kpezeshki/MuddPiV5/GPIO_TEST_WORKING.txt

/*
 * GccApplication1.c
 *
 * Created: 11/12/2018 7:54:07 PM
 * Author : kaveh
 */ 

//WORKING

#include "sam.h"

int main(void)
{
    /* Initialize the SAM system */
    //SystemInit();
	*(int *)0x20000008 = 2;
    /* Replace with your application code */
	REG_PMC_WPMR = PMC_WPMR_WPKEY_PASSWD;
	//now we enable the clock for peripheral #11 (PIOA p50)
	REG_PMC_PCER0 = PMC_PCER0_PID11; 
	
	//next we set the desired pin (PA26) as an output (P588)
	//first need to disable write protection (P633)
	REG_PIOA_WPMR = PIO_WPMR_WPKEY_PASSWD;
	//Now we set the PIO to control pin 26 (bit 26 of PIO_PER)
	//should we be using REG_PIOA_Per in pioa.h?
	REG_PIOA_PER  = PIO_PER_P10;
	//We allow the PIO write access to pin 26
	REG_PIOA_OWER = PIO_OWER_P10;
	//We now set pin 26 as an output, by writing a 1 in pin 26 of PIO_OER
	REG_PIOA_OER  = PIO_OER_P10;
	//We next write the LED to be high, by writing in PIO_SODR (set output data register), and can be cleared by writing in PIO_CODR (clear output data register). These results can be seen on PIO_ODSR (output data status register), which represents the current state of the output pins
	//An overview is on p573
	REG_PIOA_ODSR = 0; //PIO_ODSR_P9;
    while (1) 
    {
	REG_PIOA_CODR = PIO_CODR_P10; //SETS LED LOW
	REG_PIOA_SODR = PIO_SODR_P10; //SETS LED HIGH
	}
	
}
