kpezeshki/MuddPiV5/Pre-Existing Work/FinalVersion/README.txt.docx

The latest update of this version of microMudd Mark V board was April 24, 2018 by Teerapat Jenrungrot.

The Gerbers are generated for both tester board and the main board.
