kpezeshki/MuddPiV5/New PCB, no jumpers/Layout.docx

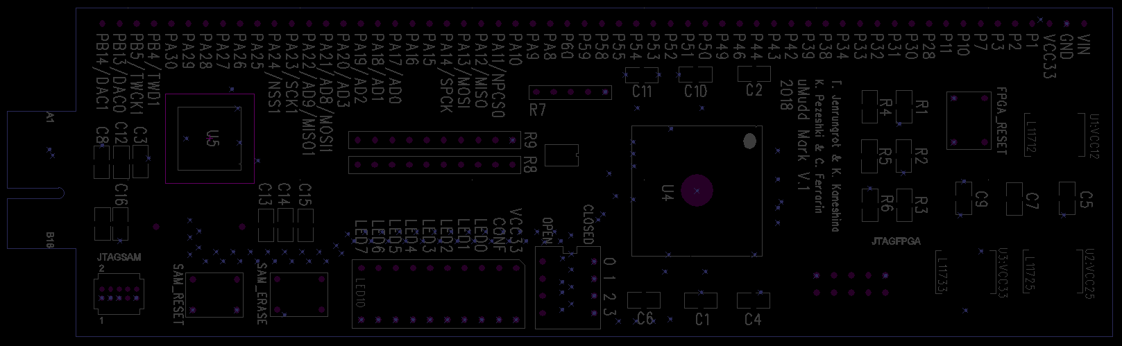
[picture p39: figure]
