kpezeshki/MuddPiV5/Pre-Existing Work/DEPRECATED/OLD/microp-revised-board-20170927T040230Z-001/top-layer.pdf

# R6R⁶x1 R⁶x2 U10

## C10C¹⁰x1 C¹⁰x2

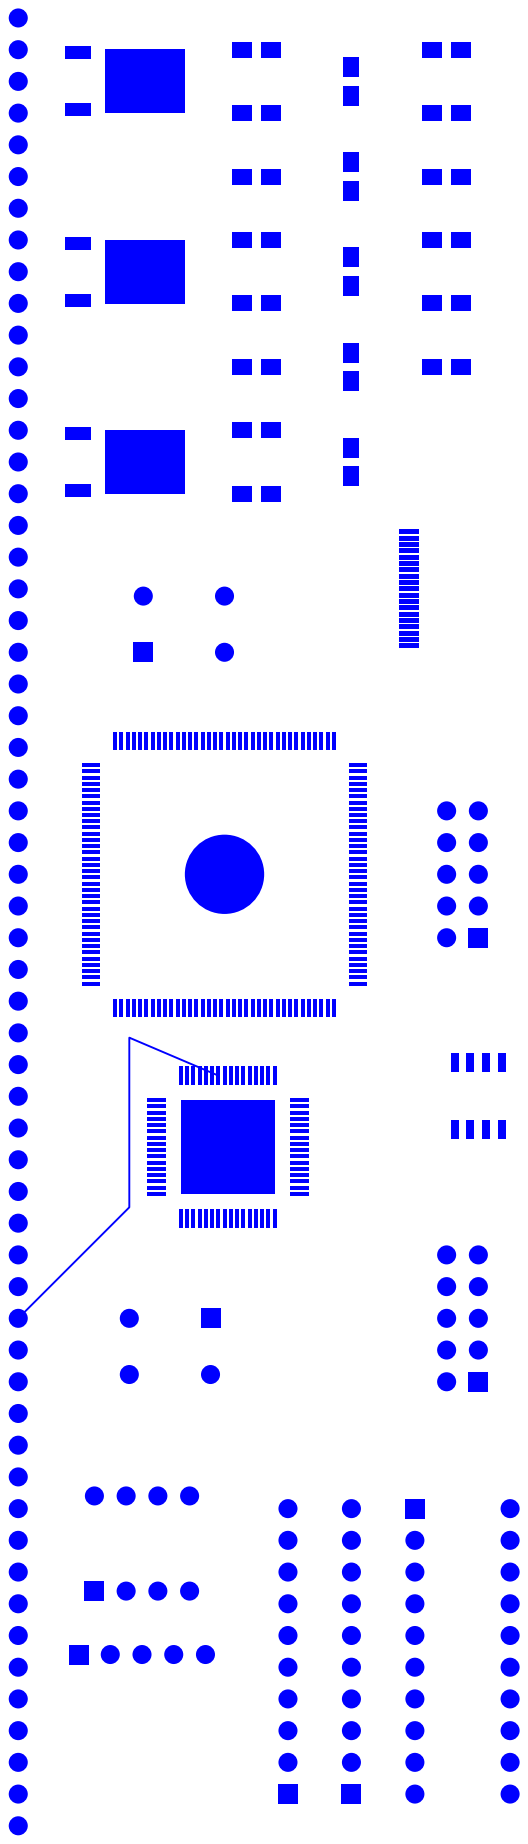
[picture p40: page 1]
U1U¹x1 U¹x3; U¹x2; U2U²x1 U²x3; U²x2; U3U³x1 U³x3; U³x2; U6U⁶x16; U⁶x15; U⁶x14; U⁶x13; U⁶x12; U⁶x11; U⁶x10; U⁶x9; U⁶x8; U⁶x7; U⁶x6; U⁶x5; U⁶x4; U⁶x3; U⁶x2; U⁶x1 U⁶x17 U⁶x18 U⁶x19 U⁶x20 U⁶x21 U⁶x22 U⁶x23 U⁶x24 U⁶x25 U⁶x26 U⁶x27 U⁶x28 U⁶x29 U⁶x30 U⁶x31 U⁶x32; U⁶x33; U⁶x34; U⁶x35; U⁶x36; U⁶x37; U⁶x38; U⁶x39; U⁶x40; U⁶x41; U⁶x42; U⁶x43; U⁶x44; U⁶x45; U⁶x46; U⁶x47; U⁶x48; U⁶x49 U⁶x50 U⁶x51 U⁶x52 U⁶x53 U⁶x54 U⁶x55 U⁶x56 U⁶x57 U⁶x58 U⁶x59 U⁶x60 U⁶x61 U⁶x62 U⁶x63 U⁶x64 U⁶x65; C1C¹x1; C¹x2; C2C²x1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

U12 U¹²x1 U¹²x2 U¹²x3 U¹²x4 U¹²x8 U¹²x7 U¹²x6 U¹²x5 U7U⁷x145 U10 R9R⁹x1 | R⁹x2 | R⁹x3 | R⁹x4 | R⁹x5 U¹⁰x1 U¹⁰x2 U¹⁰x3 U¹⁰x4 U¹⁰x5 U¹⁰x6 U¹⁰x7 U¹⁰x8 U¹⁰x9 U¹⁰x10 U¹⁰x11 U¹⁰x12 U¹⁰x13 U¹⁰x14 U¹⁰x15 U¹⁰x16 U¹⁰x17 U¹⁰x18 U¹⁰x19 U¹⁰x20 U¹⁰x21 U¹⁰x22 U¹⁰x23 U¹⁰x24 U¹⁰x25 U¹⁰x26 U¹⁰x27 U¹⁰x28 U¹⁰x29 U¹⁰x30 U¹⁰x31 U¹⁰x32 U¹⁰x33 U¹⁰x34 U¹⁰x35 U¹⁰x36 U¹⁰x37 U¹⁰x38 U¹⁰x39 U¹⁰x40 U¹⁰x41 U¹⁰x42 U¹⁰x43 U¹⁰x44 U¹⁰x45 U¹⁰x46 U¹⁰x47 U¹⁰x48 U¹⁰x49 U¹⁰x50 U¹⁰x51 U¹⁰x52 U¹⁰x53 U¹⁰x54 U¹⁰x55 U¹⁰x56 U¹⁰x57 U¹⁰x58
U5U⁵xA¹ | U⁵xA² U⁵xB¹ | U⁵xB² | R7R⁷x1 R⁷x2 R⁷x3 R⁷x4 R⁷x5 R⁷x6 R⁷x7 R⁷x8 R⁷x9 R⁷x10 R8R⁸x1 R⁸x2 R⁸x3 R⁸x4 R⁸x5 R⁸x6 R⁸x7 R⁸x8 R⁸x9 R⁸x10
U11 U¹¹xA² | U¹¹xA¹ U¹¹xB² | U¹¹xB¹ | U9U⁹x1 U⁹x2 U⁹x3 U⁹x4 U⁹x5 U⁹x6 U⁹x7 U⁹x8 U⁹x9 U⁹x10 | U⁹x11 U⁹x12 U⁹x13 U⁹x14 U⁹x15 U⁹x16 U⁹x17 U⁹x18 U⁹x19 U⁹x20 JTAGSAM JTAGSAMx2 JTAGSAMx1 JTAGSAMx4 JTAGSAMx3 JTAGSAMx6 JTAGSAMx5 JTAGSAMx8 JTAGSAMx7 JTAGSAMx10 JTAGSAMx9 JTAGFPGA JTAGFPGAx2 JTAGFPGAx1 JTAGFPGAx4 JTAGFPGAx3 JTAGFPGAx6 JTAGFPGAx5 JTAGFPGAx8 JTAGFPGAx7 JTAGFPGAx10 JTAGFPGAx9

U12 U¹²x1 U¹²x2 U¹²x3 U¹²x4 U¹²x8 U¹²x7 U¹²x6 U¹²x5 U7U⁷x145 U10 R9R⁹x1 | R⁹x2 | R⁹x3 | R⁹x4 | R⁹x5 U¹⁰x1 U¹⁰x2 U¹⁰x3 U¹⁰x4 U¹⁰x5 U¹⁰x6 U¹⁰x7 U¹⁰x8 U¹⁰x9 U¹⁰x10 U¹⁰x11 U¹⁰x12 U¹⁰x13 U¹⁰x14 U¹⁰x15 U¹⁰x16 U¹⁰x17 U¹⁰x18 U¹⁰x19 U¹⁰x20 U¹⁰x21 U¹⁰x22 U¹⁰x23 U¹⁰x24 U¹⁰x25 U¹⁰x26 U¹⁰x27 U¹⁰x28 U¹⁰x29 U¹⁰x30 U¹⁰x31 U¹⁰x32 U¹⁰x33 U¹⁰x34 U¹⁰x35 U¹⁰x36 U¹⁰x37 U¹⁰x38 U¹⁰x39 U¹⁰x40 U¹⁰x41 U¹⁰x42 U¹⁰x43 U¹⁰x44 U¹⁰x45 U¹⁰x46 U¹⁰x47 U¹⁰x48 U¹⁰x49 U¹⁰x50 U¹⁰x51 U¹⁰x52 U¹⁰x53 U¹⁰x54 U¹⁰x55 U¹⁰x56 U¹⁰x57 U¹⁰x58
U5U⁵xA¹ | U⁵xA² U⁵xB¹ | U⁵xB² | R7R⁷x1 R⁷x2 R⁷x3 R⁷x4 R⁷x5 R⁷x6 R⁷x7 R⁷x8 R⁷x9 R⁷x10 R8R⁸x1 R⁸x2 R⁸x3 R⁸x4 R⁸x5 R⁸x6 R⁸x7 R⁸x8 R⁸x9 R⁸x10
U11 U¹¹xA² | U¹¹xA¹ U¹¹xB² | U¹¹xB¹ | U9U⁹x1 U⁹x2 U⁹x3 U⁹x4 U⁹x5 U⁹x6 U⁹x7 U⁹x8 U⁹x9 U⁹x10 | U⁹x11 U⁹x12 U⁹x13 U⁹x14 U⁹x15 U⁹x16 U⁹x17 U⁹x18 U⁹x19 U⁹x20 JTAGSAM JTAGSAMx2 JTAGSAMx1 JTAGSAMx4 JTAGSAMx3 JTAGSAMx6 JTAGSAMx5 JTAGSAMx8 JTAGSAMx7 JTAGSAMx10 JTAGSAMx9 JTAGFPGA JTAGFPGAx2 JTAGFPGAx1 JTAGFPGAx4 JTAGFPGAx3 JTAGFPGAx6 JTAGFPGAx5 JTAGFPGAx8 JTAGFPGAx7 JTAGFPGAx10 JTAGFPGAx9

U12 U¹²x1 U¹²x2 U¹²x3 U¹²x4 U¹²x8 U¹²x7 U¹²x6 U¹²x5 U7U⁷x145 U10 R9R⁹x1 | R⁹x2 | R⁹x3 | R⁹x4 | R⁹x5 U¹⁰x1 U¹⁰x2 U¹⁰x3 U¹⁰x4 U¹⁰x5 U¹⁰x6 U¹⁰x7 U¹⁰x8 U¹⁰x9 U¹⁰x10 U¹⁰x11 U¹⁰x12 U¹⁰x13 U¹⁰x14 U¹⁰x15 U¹⁰x16 U¹⁰x17 U¹⁰x18 U¹⁰x19 U¹⁰x20 U¹⁰x21 U¹⁰x22 U¹⁰x23 U¹⁰x24 U¹⁰x25 U¹⁰x26 U¹⁰x27 U¹⁰x28 U¹⁰x29 U¹⁰x30 U¹⁰x31 U¹⁰x32 U¹⁰x33 U¹⁰x34 U¹⁰x35 U¹⁰x36 U¹⁰x37 U¹⁰x38 U¹⁰x39 U¹⁰x40 U¹⁰x41 U¹⁰x42 U¹⁰x43 U¹⁰x44 U¹⁰x45 U¹⁰x46 U¹⁰x47 U¹⁰x48 U¹⁰x49 U¹⁰x50 U¹⁰x51 U¹⁰x52 U¹⁰x53 U¹⁰x54 U¹⁰x55 U¹⁰x56 U¹⁰x57 U¹⁰x58
U5U⁵xA¹ | U⁵xA² U⁵xB¹ | U⁵xB² | R7R⁷x1 R⁷x2 R⁷x3 R⁷x4 R⁷x5 R⁷x6 R⁷x7 R⁷x8 R⁷x9 R⁷x10 R8R⁸x1 R⁸x2 R⁸x3 R⁸x4 R⁸x5 R⁸x6 R⁸x7 R⁸x8 R⁸x9 R⁸x10
U11 U¹¹xA² | U¹¹xA¹ U¹¹xB² | U¹¹xB¹ | U9U⁹x1 U⁹x2 U⁹x3 U⁹x4 U⁹x5 U⁹x6 U⁹x7 U⁹x8 U⁹x9 U⁹x10 | U⁹x11 U⁹x12 U⁹x13 U⁹x14 U⁹x15 U⁹x16 U⁹x17 U⁹x18 U⁹x19 U⁹x20 JTAGSAM JTAGSAMx2 JTAGSAMx1 JTAGSAMx4 JTAGSAMx3 JTAGSAMx6 JTAGSAMx5 JTAGSAMx8 JTAGSAMx7 JTAGSAMx10 JTAGSAMx9 JTAGFPGA JTAGFPGAx2 JTAGFPGAx1 JTAGFPGAx4 JTAGFPGAx3 JTAGFPGAx6 JTAGFPGAx5 JTAGFPGAx8 JTAGFPGAx7 JTAGFPGAx10 JTAGFPGAx9

C1

C2

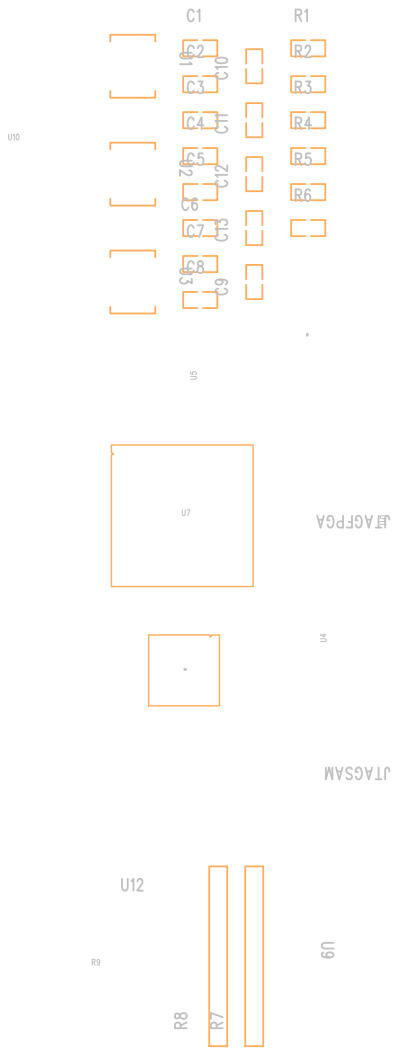
[picture p41: page 5]

.¹³
2

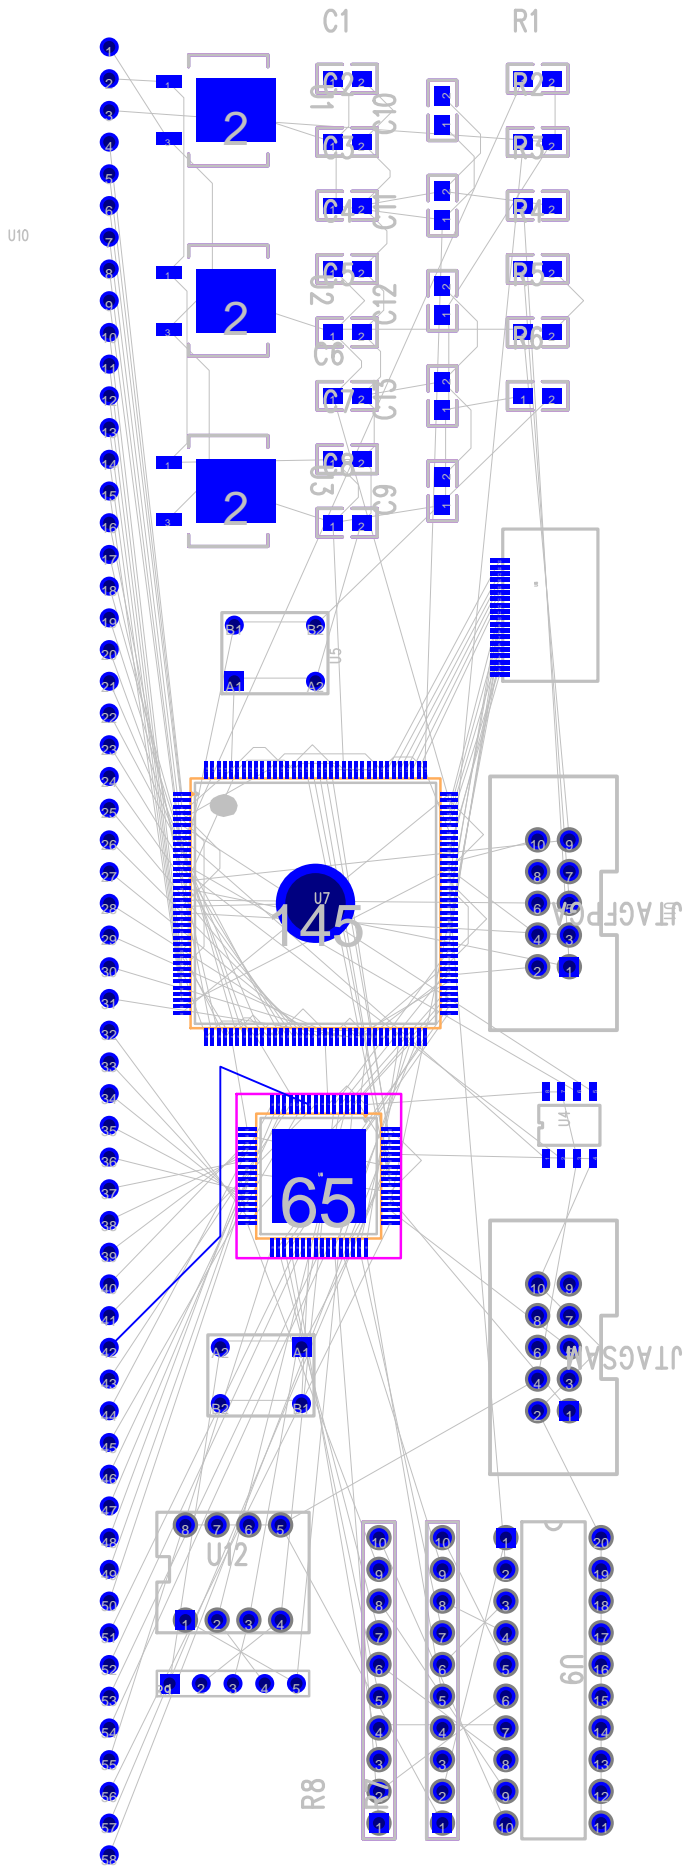
[picture p42: page 7]
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
