kpezeshki/MuddPiV5/deadmemory.JPG

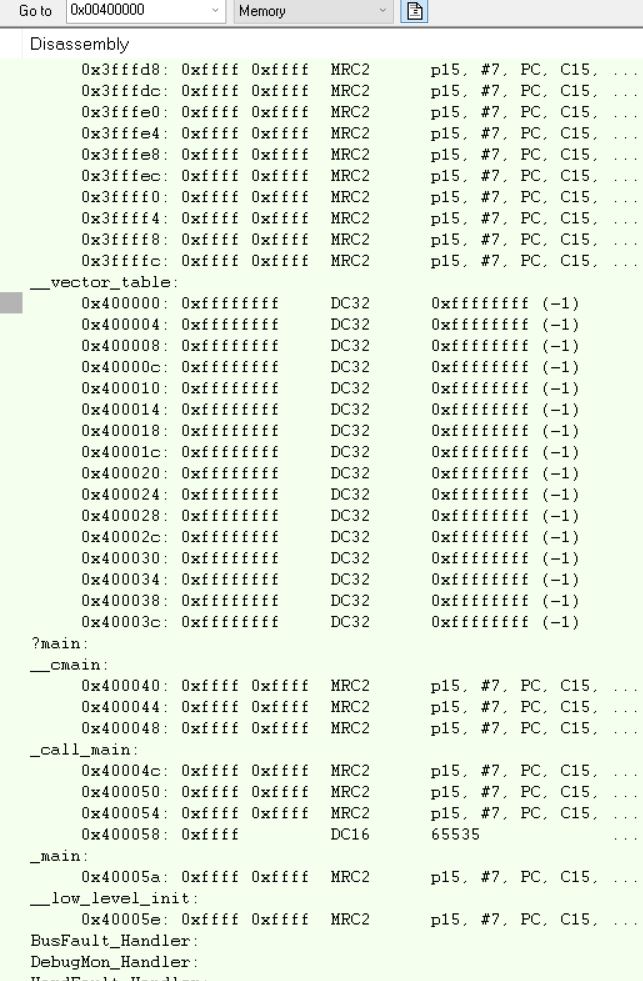
deadmemory.JPG
