kpezeshki/MuddPiV5/Final Report/E155%20Final%20Report/lab6schematic.jpg

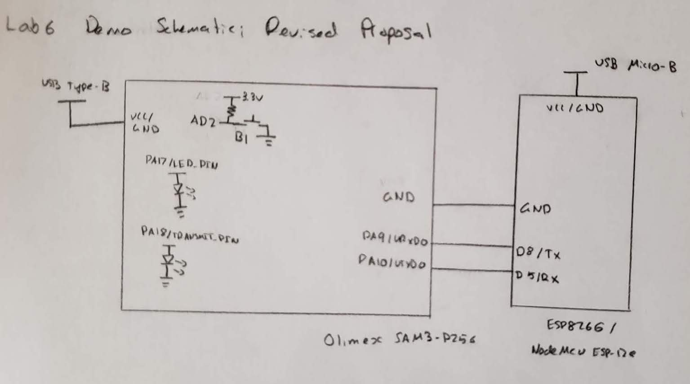
Final Report/E155%20Final%20Report/lab6schematic.jpg
