kpezeshki/MuddPiV5/New PCB, no jumpers/board_screenshot.PNG

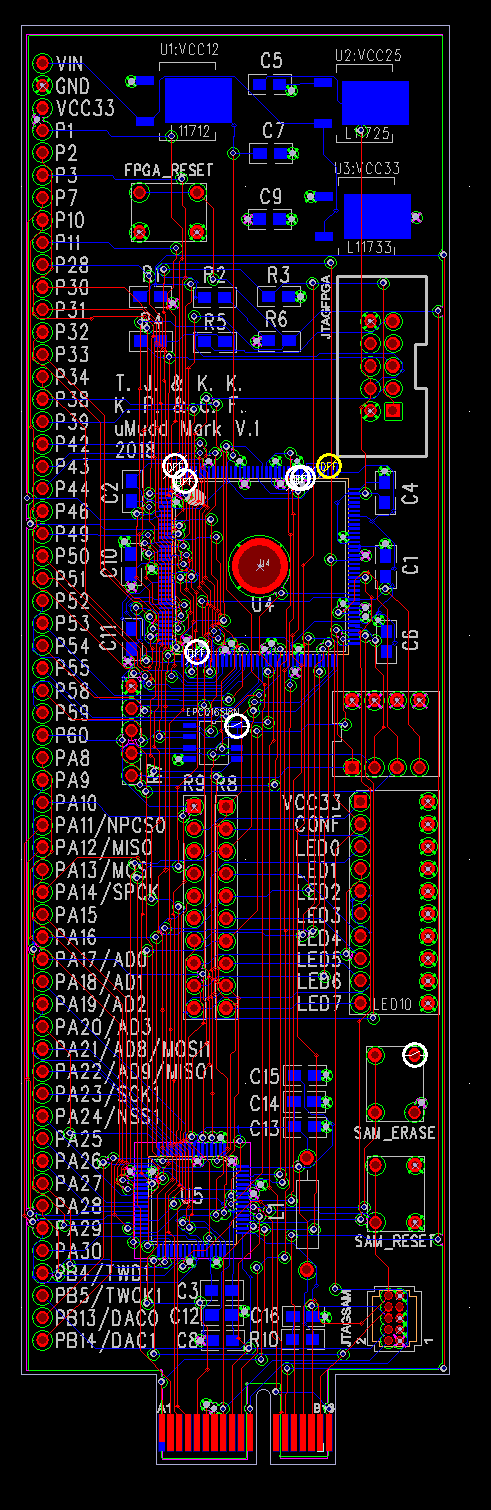
New PCB, no jumpers/board_screenshot.PNG
