kpezeshki/MuddPiV5/Pre-Existing Work/pic.jpg

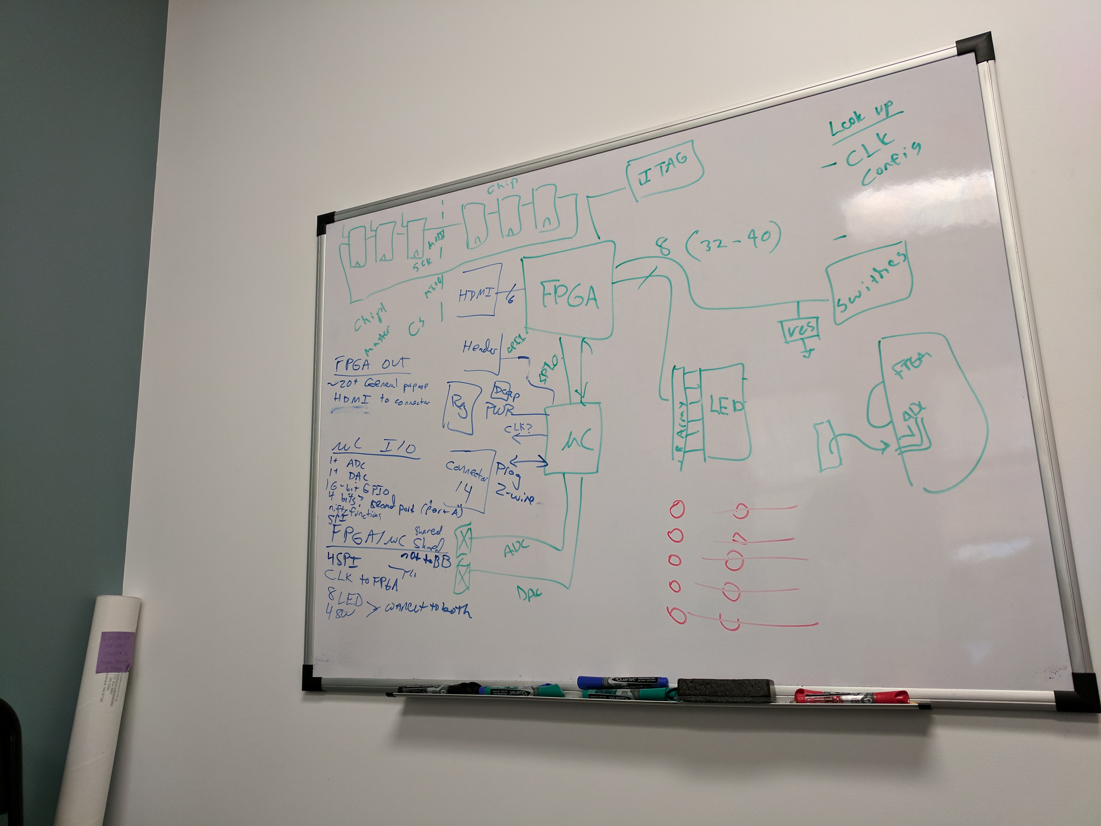
Pre-Existing Work/pic.jpg
