kpezeshki/MuddPiV5/Pre-Existing Work/FinalVersion/Gerbers/dimsensions _ ordering info.docx

MAIN(4 copies)

1.91 x 6.42 inches

TESTER (3 copies)

2.10 x 4.35 inches

http://www.4pcb.com/pcb-student-discount.html

Order 4 of each
