kpezeshki/MuddPiV5/New PCB, no jumpers/Bill of Materials.xlsx

Sheet: uMudd Mark V
 | Parts | Description | Manufacturer | Mfr Part # | Supplier | Sup Part # | Quantity | Unit Price | Total Cost | Notes | availability as of November 1
Ordered
y | U6 | Cyclone IV FPGA | Altera | EP4CE6E22C8N | Digikey | 544-2746-ND | 1 | 11.95 | 11.95 |  | in stock
y | U5 | FPGA flash | Altera | EPCQ16ASI8N | Digikey | 544-3440-ND | 1 | 7.35 | 7.35 | 8-SOIC | in stock
y | U8 | microController | Microchip technology | ATSAM4S4BA-AU | Digikey | ATSAM4S4BA-AU-ND | 1 | 3.93 | 3.93 |  | in stock
n | U9 | Quad DIP switch | Grayhill | 76SB04 | Digikey | GH7170-ND | 1 | 0.92 | 0.92 |  | in stock
y | U1 | 1.2V low-dropout regulator | ST | LD117DT12TRI | Digikey | 497-1231-1-ND | 1 | 1.16 | 1.16 | SMD | in stock
y | U2 | 2.5V low-dropout regulator | ST | LD117DT25CTR | Digikey | 497-1233-1-ND | 1 | 1.16 | 1.16 | SMD | in stock
y | U3 | 3.3V low-dropout regulator | ST | LD117DT33CTR | Digikey | 497-1235-1-ND | 1 | 1.16 | 1.16 | SMD | in stock
n | PB1, PB2, PB3 | SPST pushbutton switch | Panasonic | EVQ-PAE04M | Digikey | P8008S-ND | 3 | 0.29 | 0.87 |  | in stock
n | U10 | 10-segment LED array | Lumex | SSA-LXB10IW-GF/LP | Digikey | 67-1010-ND | 1 | 2.85 | 2.85 |  | in stock
y | R8, R9 | 330 ohm 5 resistor network | Bournes | 4610X-2-331LF | Digikey | 4610X-2-331LF-ND | 2 | 0.286 | 0.572 |  | in stock
n | JTAGFPGA | FPGA download connector | Tyco | 5103309-1 | Digikey | A33160-ND | 1 | 0.76 | 0.76 |  | in stock
n | U11 | 36-pin header | 3M | 929400-01-36-RK | Digikey | 929400E-01-36-ND | 2 | 1.323 | 2.646 |  | in stock
y | R7 | 2.2Kohm 4 resistor network | Bourns Inc. | 4605X-101-222LF | Digikey | 4605X-101-222LF-ND | 1 | 0.51 | 0.51 |  | in stock
y | R2, R3 | 1K resistor | Panasonic Electronic Components | ERJ-6GEYJ102V | Digikey | P1.0KACT-ND | 2 | 0.1 | 0.2 | SMD | in stock
y | R1, R4, R5, R6 | 10K resistor | Panasonic Electronic Components | ERJ-6GEYJ103V | Digikey | P10KACT-ND | 4 | 0.1 | 0.4 | SMD | in stock
y | R10 | 1ohm resistor | Bourns Inc. | CRS0805-FW-1R00ELF | Digikey | CRS0805-FW-1R00ELFCT-ND | 1 | 0.39 | 0.39 | SMD | in stock
y | R11, R12, R13 | 100K resistors | Panasonic Electronic Components | ERJ-6GEYJ104V | Digikey | P100KACT-ND | 3 | 0.1 | 0.3 | SMD | in stock
y | C4, C6, C8, C11, C12, C13, C15, C17 | 0.1 uF capacitor | Samsung Electro-Mechanics America, Inc | CL21F104ZBCNNNC | Digikey | 1276-1007-1-ND | 8 | 0.1 | 0.8 | SMD | in stock
y | C1, C2, C3, C10 | 0.01 uF capacitor | Murata Electronics North America | GRM216R71H103KA01D | Digikey | 490-1664-1-ND | 4 | 0.1 | 0.4 | SMD | in stock
y | C5, C7, C9 | 10 uF capacitor | Samsung Electro-Mechanics America, Inc | CL21A106KPFNNNG | Digikey | 1276-6456-1-ND | 3 | 0.14 | 0.42 | SMD | in stock
y | C14 | 2.2uF capacitor | AVX Corporation | 0805ZG225ZAT4A | Digikey | 478-12511-1-ND | 1 | 0.41 | 0.41 | SMD | in stock
y | C16 | 4.7uF capacitor | Murata Electronics North America | GRT21BC8YA475KE13L | Digikey | 490-12361-1-ND | 1 | 0.45 | 0.45 | SMD | in stock
y | L1 | 10uH inductor | Bourns Inc. | 77F100K-TR-RC | Digikey | 77F100K-TR-RCTR-ND | 1 | 0.096 | 0.096 | through-hole | in stock
y | JTAGSAM | SAM download connector | Samtec | FTSH-105-01-F-D-K | Digikey | SAM8909-ND | 1 | 2.74 | 2.74 | polarized | in stock
y | Y1 | 40MHz oscillator | TXC Corporation | 9B-40.000MAAJ-B | Digikey | 887-2030-ND | 1 | 0.39 | 0.39 | through-hole | in stock

Sheet: Tester Board
Parts | Description | Manufacturer | Mfr Part # | Supplier | Sup Part # | Quantity | Unit Price | Total Cost | Notes | availability as of November 1
U1 | 1.2V low-dropout regulator | ST | LD117DT12TRI | Digikey | 497-1231-1-ND | 1 | 1.16 | 1.16 | SMD | in stock
U2 | 2.5V low-dropout regulator | ST | LD117DT25CTR | Digikey | 497-1233-1-ND | 1 | 1.16 | 1.16 | SMD | in stock
U3 | 3.3V low-dropout regulator | ST | LD117DT33CTR | Digikey | 497-1235-1-ND | 1 | 1.16 | 1.16 | SMD | in stock
U9 | 10-segment LED array | Lumex | SSA-LXB10IW-GF/LP | Digikey | 67-1010-ND | 1 | 2.85 | 2.85 |  | in stock
R7 | 330 ohm 5 resistor network | Bournes | 4610X-2-331LF | Digikey | 4610X-2-331LF-ND | 1 | 0.286 | 0.286 |  | in stock
JTAGSAM | SAM download connector | Samtec | FTSH-105-01-F-D-K | Digikey | SAM8909-ND | 1 | 2.74 | 2.74 | polarized | in stock
JTAGFPGA | FPGA/SAM download connector | Tyco | 5103309-1 | Digikey | A33160-ND | 2 | 0.76 | 1.52 |  | in stock
C4, C6, C8, C11, C13 | 0.1 uF capacitor | Samsung Electro-Mechanics America, Inc | CL21F104ZBCNNNC | Digikey | 1276-1007-1-ND | 5 | 0.1 | 0.5 | SMD | in stock
C1, C2, C3, C10, C12 | 0.01 uF capacitor | Murata Electronics North America | GRM216R71H103KA01D | Digikey | 490-1664-1-ND | 5 | 0.1 | 0.5 | SMD | in stock
C5, C7, C9 | 10 uF capacitor | Samsung Electro-Mechanics America, Inc | CL21A106KPFNNNG | Digikey | 1276-6456-1-ND | 3 | 0.17 | 0.51 | SMD | in stock
R1, R2 | 1K resistor | Panasonic Electronic Components | ERJ-6GEYJ102V | Digikey | P1.0KACT-ND | 2 | 0.1 | 0.2 | SMD | in stock
R3, R4, R5, R6 | 10K resistor | Panasonic Electronic Components | ERJ-6GEYJ103V | Digikey | P10KACT-ND | 4 | 0.1 | 0.4 | SMD | in stock
JTAGFPGA1 | Edge card connector | Molex | 87715-9005 | Digikey | WM9029-ND | 1 | $1.69 | $1.69 |  | in stock
BV2 | Banana socket, board mount, black | Deltron | 571-0100 | Mouser | 164-6218 | 1 | $1.97 | $1.97 |  | in stock
BV1 | Banana socket, board mount, red | Deltron | 571-0500 | Mouser | 164-6219 | 1 | $2.34 | $2.34 |  | in stock
STANOFF1, STANDOFF2, STANDOFF3, STANDOFF4 | Male-Female Threaded Hex Standoff, 18-8 Stainless Steel, 1/4" Hex, 1-1/2" Long, 8-32 to 8-32 Thread | McMaster-Carr | 91075A458 |  |  | 8 | 2.39 | 19.12 |  | in stock
R9, R10, R11, R12 | 100K resistors | Panasonic Electronic Components | ERJ-6GEYJ104V | Digikey | P100KACT-ND | 4 | 0.1 | 0.4 | SMD | in stock

Sheet: Equipment
https://www.segger.com/purchase/pricing/jlink-related/
