kpezeshki/MuddPiV5/New PCB, no jumpers/IO Breakout.xlsx

User-Accessible IO |  |  |  | Internal Signals
Header Pin Silkscreen | Microcontroller Pin | FPGA Pin | Other Pin | Microcontroller Pin | FPGA Pin | Other Pin
VIN | n/a | n/a | VIN | PB11 | P127 | n/a
GND | n/a | n/a | GND | PB10 | P126 | n/a
VCC33 | n/a | n/a | 3.3V regulator output | PB3 | P83 | SW3
P1 | n/a | P1 | n/a | PB2 | P80 | SW2
P2 | n/a | P2 | n/a | PB1 | P77 | SW1
P3 | n/a | P3 | n/a | PB0 | P76 | SW0
P7 | n/a | P7 | n/a | PA7 | P75 | LED7
P10 | n/a | P10 | n/a | PA6 | P74 | LED6
P11 | n/a | P11 | n/a | PA5 | P73 | LED5
P28 | n/a | P28 | n/a | PA30 | P72 | LED4
P30 | n/a | P30 | n/a | PA29 | P71 | LED3
P31 | n/a | P31 | n/a | PA2 | P20 | LED2
P32 | n/a | P32 | n/a | PA1 | P69 | LED1
P33 | n/a | P33 | n/a | PA0 | P68 | LED0
P34 | n/a | P34 | n/a
P38 | n/a | P38 | n/a
P39 | n/a | P39 | n/a
P42 | n/a | P42 | n/a
P43 | n/a | P43 | n/a
P44 | n/a | P44 | n/a
P46 | n/a | P46 | n/a
P49 | n/a | P49 | n/a
P50 | n/a | P50 | n/a
P51 | n/a | P51 | n/a
P52 | n/a | P52 | n/a
P53 | n/a | P53 | n/a
P54 | n/a | P54 | n/a
P55 | n/a | P55 | n/a
P58 | n/a | P58 | n/a
P59 | n/a | P59 | n/a
P60 | n/a | P60 | n/a
PA8 | PA8 | n/a | n/a
PA9 | PA9 | n/a | n/a
PA10 | PA10 | n/a | n/a
PA11/NPCS0 | PA11 | P110 | n/a
PA12/MISO | PA12 | P111 | n/a
PA13/MOSI | PA13 | P112 | n/a
PA14/SPCK | PA14 | P113 | n/a
PA15 | PA15 | n/a | n/a
PA16 | PA16 | n/a | n/a
PA17/AD0 | PA17 | n/a | n/a
PA18/AD1 | PA18 | n/a | n/a
PA19/AD2 | PA19 | n/a | n/a
PA20/AD3 | PA20 | n/a | n/a
PA21/AD8 | PA21 | n/a | n/a
PA22/AD9 | PA22 | n/a | n/a
PA23/SCK1 | PA23 | n/a | n/a
PA24/NSS1 | PA24 | n/a | n/a
PA25 | PA25 | n/a | n/a
PA26 | PA26 | n/a | n/a
PA27 | PA27 | n/a | n/a
PA28 | PA28 | n/a | n/a
PA3 | PA3 | n/a | n/a
PA4 | PA4 | n/a | n/a
PB4/TWD1 | PB4 | n/a | SAM4S JTAG TDI
PB5/TWCK1 | PB5 | n/a | SAM4S JTAG TDO
PB13/DAC0 | PB13 | n/a | n/a
PB14/DAC1 | PB14 | n/a | n/a
