kpezeshki/MuddPiV5/New PCB, no jumpers/Available IO.xlsx

MCU-FPGA
FPGA Pin | MCU Pin | On header? | On LED? | On switch? | MCU Pin Alt Modes
P68 | PA0 | n | y | n | PWM
P69 | PA1 | n | y | n | PWM
P70 | PA2 | n | y | n | PWM
P71 | PA3 | n | y | n | TWD0 | NPCS3 | PA29
P72 | PA4 | n | y | n | TWCK0 | TCLK0 | PA30
P73 | PA5 | n | y | n | RXD0 | NPCS3
P74 | PA6 | n | y | n | TXD0 | PCK0
P75 | PA7 | n | y | n
P76 | PB0 | n | n | y | PWM
P77 | PB1 | n | n | y | PWM
P80 | PB2 | n | n | y | URXD1 | NPCS2
P83 | PB3 | n | n | y | UTXD1 | PCK2
P126 | PB10 | n | n | n
P127 | PB11 | n | n | n
P110 | PA11 | y | n | n | PWM | NPCS0
P111 | PA12 | y | n | n | PWM | MISO
P112 | PA13 | y | n | n | PWM | MOSI
P113 | PA14 | y | n | n | PWM | SPCK
FPGA
29 pins broken out on header |  |  | SPI
MCU
Pin (on header) | Alt modes
PA8 |  | URXD0
PA9 | NPCS1 | UTXD0
PA10 | NPCS2
PA15 | TIOA1
PA16 | TIOB1
PA17 | PCK1
PA18 | PCK2
PA19 | PWM
PA20 | PWM
PA21 | PCK1
PA22 | NPCS3
PA23 | SCK1 | PWM
PA24 | RTS1 | PWM
PA25 | CTS1 | PWM
PA26 | TIOA2
PA27 | TIOB2
PA28 | TCLK1
PA29 | TCLK2 |  | I2C |  | PA3
PA30 | PWM | NPCS2 | I2C |  | PA4
PB13 | PWM | PCK2 | DAC0
PB14 | NPCS1 | PWM | DAC1
