kpezeshki/MuddPiV5/Pre-Existing Work/MicroP Research.xlsx

Sheet: microProcessor Schematic
I | http://ww1.microchip.com/downloads/en/DeviceDoc/Atmel-11100-32-bit%20Cortex-M4-Microcontroller-SAM4S_Datasheet.pdf
Added To schematics | PIN NAME | PIN NUMBER | Pin name/function | description | input | output | connection | HEADER
Y | M28 | 1 | ADVREF | used to set the range of voltages for the ADC | 1.62-3.6V |  | vdd33
Y | M29 | 2 | GND | ground | GND |  | gnd
Y | M5 | 3 | PB0/AD4 | ADC4 |  |  |  | PB0/AD4
Y | M6 | 4 | PB1/AD5 | ADC5 |  |  |  | PB1/AD5
Y | M7 | 5 | PB2/AD6 | ADC6 |  |  |  | PB2/AD6
Y | M8 | 6 | PB3/AD7 | ADC7 |  |  |  | PB3/AD7
Y | M30 | 7 | VDDIN |  | 1.62 - 3.6 V |  | vdd33
Y | M31 | 8 | VDDOUT |  |  | 1.2 V | NC
Y | M1 | 9 | PA17/PGMD5/AD0 | ADC0 |  |  |  | PA17/PGMD5/AD0
Y | M2 | 10 | PA18/PGMD6/AD1 | ADC1 |  |  |  | PA18/PGMD6/AD1
Y | M9 | 11 | PA21/PGMD9/AD8 | ADC8 / RXD1 | USART1 / MOSI |  |  | PA21/PGMD9/AD8
Y | M32 | 12 | VDDCORE |  | 1.08-1.32 V |  | vdd12
Y | M3 | 13 | PA19/PGMD7/AD2 | ADC2
Y | M10 | 14 | PA22/PGMD10/AD9 | ADC9 / TXD1 | USART1 / MISO
Y | M11 | 15 | PA23/PGMD11 | SCK1 | USART1 / serial clock
Y | M4 | 16 | PA20/PGMD8/AD3 | ADC3
Y | M33 | 17 | GND |  | GND |  | gnd
Y | M34 | 18 | VDDIO |  | 1.62 - 3.6 V |  | vdd33
Y | M12 | 19 | PA16/PGMD4 | LED1
Y | M53 | 20 | PA15/PGMD3 | LED0
Y | M35 | 21 | PA14/PGMD2 | SPCK
Y | M36 | 22 | PA13/PGMD1 | MOSI
Y | M13 | 23 | PA24/PGMD12 | RTS1 | USART1 / CS
Y | M37 | 24 | VDDCORE |  | 1.08-1.32 V |  | vdd12
Y | M14 | 25 | PA25/PGMD13 | LED2 | USART1 / CS
Y | M54 | 26 | PA26/PGMD14 | LED3
Y | M38 | 27 | PA12/PGMD0 | MISO
Y | M39 | 28 | PA11/PGMM3 | NPCS0
Y | M15 | 29 | PA10/PGMM2
Y | M16 | 30 | PA9/PGMM1
Y | M17 | 31 | PA8/XOUT32/PGMM0 |  | USART0 / CS
Y | M18 | 32 | PA7/XIN32/PGMNVALID | RTS0 | USART0 / CS
Y | M40 | 33 | TDI/PB4 | TWD1 | i^2/TWI connection (data)
Y | M19 | 34 | PA6/PGMNOE | TXD0 | USART0 / MISO |  | pa6/txd0
Y | M20 | 35 | PA5/PGMRDY | RXD0 | USART0 / MOSI
Y | M25 | 36 | PA4/PGMNCMD | TWCK0 | i^2/TWI connection (clock)
Y | M55 | 37 | PA27/PGMD15 | LED4
Y | M56 | 38 | PA28 | LED5
Y | M41 | 39 | NRST | connected to ground with a swtich |  |  | gnd via switch
Y | M42 | 40 | TST | UNCONNECTED | NC
Y | M57 | 41 | PA29 | LED6
Y | M23 | 42 | PA30 | LED7
Y | M24 | 43 | PA3 | TWD0 | i^2 C/TWI connection (data)
Y | M21 | 44 | PA2/PGMEN2 | SCK0 | USART0 / SPI (serial clock)
Y | M43 | 45 | VDDIO |  |  |  | vdd33
Y | M44 | 46 | GND |  | GND |  | gnd
Y | M58 | 47 | PA1/PGMEN1
Y | M59 | 48 | PA0/PGMEN0
Y | M45 | 49 | TDO/TRACESWO/PB5 | TWCK1 | i^2/TWI connection (clock)
Y | M46 | 50 | JTAGSEL | JTAGsel
Y | M47 | 51 | TMS/SWDIO/PB6 | swdio |  |  | JTAG/TMS
Y | M22 | 52 | PA31 | PCK2
Y | M48 | 53 | TCK/SWCLK/PB7 | swclk |  |  | JTAG/TCK
Y | M49 | 54 | VDDCORE |  | 1.08-1.32 V |  | vdd12
Y | M60 | 55 | ERASE/PB12
Y | M61 | 56 | DDM/PB10 | SW2
Y | M62 | 57 | DDP/PB11 | SW3
Y | M50 | 58 | VDDIO |  |  |  | vdd33
Y | M26 | 59 | PB13/DAC0 | DAC0
Y | M51 | 60 | GND |  | GND |  | gnd
Y | M63 | 61 | XOUT/PB8 | SW0
Y | M64 | 62 | XIN/PGMCK/PB9 | SW1
Y | M27 | 63 | PB14/DAC1 | DAC1
Y | M52 | 64 | VDDPLL |  | 1.08 - 1.32 V |  | vdd12

Sheet: elements
capacitors |  | do we understand?
4.7µF or higher ceramic capacitor must be connected between VDDIN and the closest GND pin of the device |  | yes |  |  | already done by the 10 by the voltage regulator
To ensure stability, an external 2.2 µF output capacitor, CDOUT must be connected between the VDDOUT and the closest GND pin of the device. The ESR (Equivalent Series Resistance) of the capacitor must be in the range 0.1 to 10 Ω. Solid tantalum, and multilayer ceramic capacitors are all suitable as output capacitor | do we even use VDDOut?? | no | no capacitor, leave connected.
A 100 nF bypass capacitor between VDDOUT and the closest GND pin of the device helps decrease output noise and improves the load transient response. |  | yes | no capacitor, leave connected.
USART/SPI: 3.3V domain: VDDIO from 2.85 to 3.6 V, maximum external capacitor = 40 pF |  | yes |  | probably not... check
SSC: 3.3V domain: VDDIO from 2.85 to 3.6 V, maximum external capacitor = 30 pF | synchronous serial controller 15 | no |  | probably not... check
SMC: 3.3V domain: VDDIO from 2.85 to 3.6 V, maximum external capacitor = 50 pF | static memory controller 14 | NO |  | probably not... check
573 external pull up for multi-drive control
twi - 721
1143/1144 for r pullup and pulldown values?
ESR 1167
R_advref = 1173
look for a decap spec
if not then we need to put .01 microF near input voltage/power input of pin. | types: X5R,X7R,NP0/C0G | NP0/C0G FOR .01microF, class 1
ceramic capacitor | dont use Y-class 3 | class 3&2 change voltage on capacitor if tapped, so bad
 | X5R,X7R- cass 2

Sheet: TODO September 19, 28, October
TODO: September 19
1 | Add pull up resistor to reset pin on uC | DONE | Or check if it has internal one
2 | Take out H-bridge + related stuff | DONE
3 | Mark connections on both JTAG connectors (uC and FPGA) | DONE
4 | Look at 5V pin on HDMI | done | we sent the 5v
5 | Find what DDC/CEC does on HDMI | DONE | (Consumer Electronics Control) channel, used for sending command and control data between connected devices. DDC (Display Data Channel), used for communicating EDID (Extended Display Identification Channel) information between devices.
6 | bypass capacitor for microC + other elements
7 | Change the number of header (Probably?) | DONE | Keep it the same
8 | Check if the FPGA can run 80 MHz (from uC)? | Done | look at Table 1.24 | Volume 3 | http://pages.hmc.edu/harris/class/e155/cyclone4-handbook.pdf
9 | connect clock to FPGA | DONE | PIN30 | M16 | PA9/PGMM1
10 | look into what TST does... | do we need? | One dedicated pin, TST, is used to define the device operating mode. When this pin is at low level during powerup, the device is in normal operating mode. When at high level, the device is in test mode or FFPI mode. The TST pin integrates a permanent pull-down resistor of about 15 kW,so that it can be left unconnected for normal operation. Note that when setting the TST pin to low or high level at power up, it must remain in the same state during the duration of the whole operation.
 | RTS only, not CTS | done
 | RTS is the chip select. make CTS simply GPIO | done
 | ddc & cec - i2c | http://www.luxielectronics.com/attachments/File/HDCP_and_EDID_Demystified.pdf
 |  | http://www.st.com/content/ccc/resource/technical/document/application_note/4d/6b/26/ce/14/34/4b/52/DM00050136.pdf/files/DM00050136.pdf/jcr:content/translation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
 | cec -are commands that can be passed through the HDMI connector intended to command and control player devices
2017-09-28
look up footprint guidelines for TQFP ( shape of chip) or QFP
look for a decap spec
if not then we need to put .01 microF near input voltage/power input of pin.
2017-10-03
Different TCK for each JTAG connector |  | done
Renumber the U |  | done
Need Resistor on TCK. Check the values of resistors for FPGA and SAM |  | N/A | Specifically, check if we need resistors on any JTAG pins. Do we need pull-down etc.
Finish the HDMI connector + include the footprint |  |  | Group pins into pair. | Then, use the differences between two signals.
Rename HDMI pins to improve readability. |  | done | Like HDMI_A+/ HDMI_A- or something
Add 0.1 capacitors to VCC33 of the chip and FPGA |  | done
0805 for the size of elements
Double check for all connections
Need an extra bypass cap on 1.2 V reg and 3.3 V |  | done
Put capacitors on any input voltages to microP. |  | done | Have the limit of 4 capacitors | Also try to find the close ones
Change ADC to AD |  | done
Look for hardware debugging of the chip |  |  | Look at TRACESW0
Check JTAGSEL. What does it do? Do we need it? |  | NC | page 36
Start Layout!!! |  |  | Look for some pins that can be sensitive to noise, such as HDMI. Make them close to the chip.
Edgecard connector [to 3.3V/2.5V/1.2V/GND/4 JTAG FPGA/2 JTAG microCont/ 2 unused FPGA pins]
Rename MISO/MOSI |  | done
Rename PCK |  | done
Switch connections A1 A2 |  | done
JTAGFPGA JTAGSAM |  | done
SAMTMS |  | done
SAMTCK |  | done
2017-10-10
edge card connector for testing FPGA (ask how that works + footprints) | We'll have two boards. Another board has 2 JTAG connectors + PROM that can be used to verify the other board. Use 10 microF capacitors for voltage reg. Also need reset + config. Also need some pull-up resistors on configuration pins. Also need LED (Same LED Display). Need a program that can run on both FPGA and microP to verify that they are working. Label LED with something like FPGAGOOD, microPGOOD, bla bla bla.
ask about 5v input to the HDMI (do we need voltage reg?\) |  | wait on this
no configuration functions. move to the top of the fpga (144-109). have them in the same pin bank as well
PADS Route?
Do the calculation for HDMI connector in PADS Layout.
example HDMI connections | http://www.analog.com/en/analog-dialogue/articles/hdmi-made-easy.html
 | http://www.ti.com/lit/an/snva412a/snva412a.pdf
do main board then edge card board
hdmi problem is the differential signal: we need 2.8 Voltage difference | page 458
2017-10-24
power/ground traces should be ~20 mils thick or 12-15 mils if 20 isn't feasible (right click on net then click properties and then rules, change clearance to number desired | done
move vias away from the pins | done
Squeeze the board - make things closer even the Surface mounted parts | done
pinout at the very end
add our names/silkscreen (add textbox for each one rip) | done | be on both sides of pin
straight line between resistors and leds | done
microJTAG => below or next to micro | done
FPGAJTAG => upper or next to FPGA | done
need to add edgecard connector | done
LEDSTATUS
2 leds => indicate all connections from FPGA to microP work | done
1 led for power (maybe) on tester board | done
2 ppl => split to do edgecard board and pads route | lol
circles are standoffs | https://www.mcmaster.com/#catalog/122/3293/=15hl9py
5v and gnd are banana plugs | ??
 | uMudd Mark V. Put on ur names and year lol
power led is for when the power goes into the edgecard lol | done
move caps closer to what they are bypassing (like microP) | done
remove hdmi | done
make header pins half in away from side | done
ask about resistors for FPGA and microcontroller for edge card board (nconfig, nstatus) | we need them... already made the new footprint for more traces. just need to implement
read into SAMTMS SAMTCK pull ups | dont need, they have internal pull ups already. done
how to add stand offs? | https://www.mcmaster.com/#catalog/122/3293/=15hl9py
are the banana plugs we chose right? | no lol they will email us new ones.
is the edge card connector one or two sided? | probably 2 sided
why can't i change the pcb decal to holes instead of traces for the edge card ?
2017-10-31
banana plug stuff
 | Aluminum Female Threaded Hex Standoff, 1/4" Hex, 1-1/2" Length, 8-32 Screw Size | 4 |  | Mcmaster | 91780A202 | $0.85 | $3.40
 | Banana socket, board mount, black | 30 | N/A | N/A | Mouser | 164-6218 | $27.00 | $0.90 | $1.19 | $5.95 | $9.00 | $22.50 | $45.00 | $83.00 | $166.00 | $182.60 | $207.50 | $249.00 | $375.00 | $450.00 | $750.00 | 1
 | Banana socket, board mount, red | 30 | N/A | N/A | Mouser | 164-6219 | $27.00 | $0.90 | $1.19 | $5.95 | $9.00 | $22.50 | $45.00 | $83.00 | $166.00 | $182.60 | $207.50 | $249.00 | $375.00 | $450.00 | $750.00 | 1
8 uMudd boards - put together kits | 6 go to sierra assembly | 2 completely assembled | 4: ask him to put on the two chips |  | kits have all parts
 | 2 others should be unassembled (pete) | give him a heads up, telling them that they will be here at a certain time.
3 tester boards
all boards are being fabricated by 4pcb
send out BOM asap | to Sydney by Friday | quantity 8 (uMudd), quantity 3 (edge card)
check on lead time for each part... | done
send PDF and gerber file | missing 1 layer - check this
time consuming - silk | done
I don’t see a page with the fully routed board with top and bottom metal shown. Is it routable?
I think the JTAG cable will annoyingly hang over the breadboard in this configuration. Rotating it 180 degrees would likely help.
Looking forward to your silk. You may need to move components to accommodate good header pin labels.
Can the capacitors slide any closer to the FPGA and microcontroller?
The vias are pretty big. Is this the minimum size Advanced Circuits can do at a cheap rate? Routing might be easier if they are smaller, and they look bigger than the ones on this year’s board.
Do you have a mating connector in mind for the edge card connector? Can you polarize the design with a notch such that it is impossible to insert backward? Here’s some products to search on DigiKey:
2017-11-06
changed trace width to 10, and clearances to 8 | done
ask about NRST on uC... does it need to be connected to jtag? | done
reduce via size | done
dont have via intersect with silk screen | done
make sure vias arent next to SMP as soldering on parts may short the vias | done
go thru layers and via stuff in pads tutorial | done
fix layer display settings | done
reroute with smalller vias | done
make sure silk on board | done
find another edge card for easier soldering... | done | totalthicknessof63.4mil
fix clearances on edge card board | DONE
rearrange LED and signals | done
board working on silk screen | Label with function rather than numbers | done
individual signals for confirming each are programmed | nstatus, conf_done (shows FPGA is programmed), nconfig=reset for fpga, nreset for both, one for edgecard power, goodconnection | done
add standoffs | done
check drawers for parts, then ask sam if he has, then edit BOM and send out part request to syndey torrey | done
.155 in diameter | double check if right in schematic
add in NRST, and sam programmed to edgecard on main board and on edge card board | done | DONE
look in data for sam programmed | ask them
ADD NETS TO PLANES | done
finish edgecard board | done
remove 12910 from jtag and connector (silk only for micro p student | done
only 1 net per plane, unless split plane | done
3.3 on plane | done
rest are traces (12 or greater) | done? we did 8 and 10 sorry
call buttons RESET SAM / FPGA, also have PB if possible | done
label LDOs with voltage (leave U as well) | done
label position of switches, look at currnet board silk screen | DONE
label LED
move vias away from edge card | done
condense board (move names and move up jtag) | done
try condesing main board in general | done
connnection should blink if good, call it good connection ro seomthing more intuitive | done
mention in instructions | dpme
 | tools- vverify design
fix all diamolns lol fuckj | thin traces are unrouted? aka diamonds- check gerber
 | show gerber proving damonds
PADS Logic | uMudd
 | Tester
PADS Layout | uMudd | done
 | Tester | done
LIbrary | E155
 | microp-revised-board
 | Edgecards | done

Sheet: Questions September 15, 17,24
Question: 9/15
MISO/MOSI/SPI | not enough? how do we connect? | can connect to any FPGA io pin
ADC/DAC | How many pins do we need? - just put them on the breadboard | shared with gpios (pick one that is shared with analog)
16-bit GPIO | What does it mean? - 16 general pins
Connector-14 | What does it mean? - jtag connector
CLK [XIN/XIN32 ...] | What clock are we using? - use the PLLACK, target of 40Mhz, using dividers and multipliers | going to fpga and a header pin |  | pages 513,509 need to be done in code not hardware
Prog-2 wire | What is it? | program microcontroller with 2 wires, only want 2 wire for the microcontroller
JTAG | to both FPGA and microP? or just one? | 2 separate ones
SPI/mosi/miso on FPGA | How to choose pins? - any convenient, do so its easily connected to FPGA
Bluetooth / SPI | How can we connect to both FPGA and bluetooth? | uC spi to gpio FPGA
 |  | regular pins not spi for the unknowns
npcs = chip select
1 spi port is 4 pins | miso,mosi,cs,sck
only a and b ports
port A = PA
A factory-programmed fast RC oscillator. Three output frequencies can be selected: 4/8/12 MHz. By default 4 MHz is selected.
Two 80 to 240 MHz programmable PLL (input from 3 to 32 MHz), capable of providing the clock MCK to the processor and to the peripherals.
PLLACK is the output of the divider and 80 to 240 MHz programmable PLL (PLLA).
need 2 jtag connectors - FPGA and for the uC (its called 2 wire prog) | aka only need tms/swdio and tck/swclk
 | only 2 and grounda nd maybe others but still need 14 connection bit for jtag even if doesnt all.
Question: 9/17
higher pitch on HDMI (.50 mm) | not possible... | okay for now
What are NRST and TST on uC? | NRST - add switch to ground (authomatically pulled high internally, switch will ground and thus pulled low so reset occurs |  |  | look into what TST does...
show schematic and BOM - ask if acceptable
should we specific SPI / gpio pins for bluetooth | no | okay so have only 1 miso/mosi, but need multiple chip selects to alternate between items
 |  | connect miso/mosi to both items and give them diff chip selects...
 |  | ideally have miso and mosi for parts A and B... ideally dont need to share
check if i^2 C - similar to SPI | YES
don't route traces / shorter is better
bypass capacitors should be closer to fpga. should be touching pin of FPGA |  | changed in sheet? | changed in schematic
vias - connect vertical layers of the board | 11-14 spi, spck is sck for spi so ok | check | yes
box schematic parts separately | 2,5,6,7,8 usart/spi | kinda check | YES
 | 3,4 are i^2 c | check | YES
 | 21-25 are usart/spi | kinda check | YES
 | put gpio/spi
 | make sure we have enough for a continuous bank of gpio (16, can be spi as well)
 | prioritze attaching led and switch first
TO DO
edit board connector to show what goes to Bread board for fpga and uC
look up how to connect HDMI and microcontroller (need to figure out what elements need to connect to uC (capacitors, resistors etc))
look into what TST does...
CONFIRM DEFINITIONS OF CTS1 AND RTS1
QUESTIONS 9 /24
10 | look into what TST does... | do we need? | One dedicated pin, TST, is used to define the device operating mode. When this pin is at low level during powerup, the device is in normal operating mode. When at high level, the device is in test mode or FFPI mode. The TST pin integrates a permanent pull-down resistor of about 15 kW,so that it can be left unconnected for normal operation. Note that when setting the TST pin to low or high level at power up, it must remain in the same state during the duration of the whole operation.
confirm CEC - if unused do we ground?. | is this a general rule too (TDO?) | not a general rule.. depends
no I^2C on FPGA?DDC and CEC for communication with other devices?? do we even need to connect them?
differences between C and A1 | http://ww1.microchip.com/downloads/en/DeviceDoc/Atmel-11100-32-bit%20Cortex-M4-Microcontroller-SAM4S_Datasheet.pdf |  |  | doesnt matter
elements sheet
also NRST - dont we need a resistor in between ground and switch? | no its okay leave it due to pull up internal
unconnected = no connection to anything
2 different colors for JTAGS
dont need CEC or DDC, run to unused FPGA pins | already done
look up footprint guidelines for TQFP ( shape of chip) or QFP
look for a decap spec | done
if not then we need to put .01 microF near input voltage/power input of pin.
check JTAG voltage for uC | vdd3
figure out JTAG interface... can we leave unconnected? | connect to whatever we want'
dont pin out LED and Switches | done
rename with real names no MS | done
look into PGM stuff | high-volume programming using a standard gang programmer... we are not using this so just use the pins as GPIO |  | done
clock output pin. look into PLL frequency | PCK is the output pin we need for driving the clock to the microcontroller |  | done
pretty things on schematic/ connecting VCC33 / PA1,2,3 or just header is nice (ADC0, adc1...) | done
Sort by PA1, P2 etc | done

Sheet: References
https://www.altera.com/content/dam/altera-www/global/en_US/pdfs/literature/dp/cyclone-iv/ep4ce6.pdf | pin layout for microcontroller
http://www.molex.com/pdm_docs/sd/471511051_sd.pdf
https://www.jedec.org/system/files/docs/MS-026D.pdf | references for pin layout of microP
http://electronics.howstuffworks.com/hdmi2.htm | HDMI shield pin
https://www.maximintegrated.com/en/app-notes/index.mvp/id/4313 | hdmi signalling
https://www.alliedelec.com/vector-electronics-technology-4112-5/70219557/?pcrid=30980760979 | edgecard connector
http://ww1.microchip.com/downloads/en/DeviceDoc/Atmel-11100-32-bit%20Cortex-M4-Microcontroller-SAM4S_Datasheet.pdf | SAM datasheet
http://sullinscorp.com/glossary/ | glossary for edgecard
part links
edge card connector (MEC2-08-01-L-DV) | http://suddendocs.samtec.com/prints/mec2-xx-xx-x-xxx-xx-xx-footprint.pdf | use figure 1
 | https://www.digikey.com/product-detail/en/samtec-inc/MEC2-08-01-L-DV/SAM11487-ND/6693956
 | https://www.samtec.com/partnumber/mec2-08-01-l-dv?vendor=digikey
Bluetooth LE SPI Friend | https://cdn-shop.adafruit.com/product-files/2267/MDBT40-P256R.pdf

Sheet: BOM Edge Card
Description | Manufacturer | Mfr Part # | Supplier | Sup Part # | Quantity | Unit Price | Total Cost | Notes | availability as of November 1 | HMC in stock
1.2V low-dropout regulator | ST | LD117DT12TRI | Digikey | 497-1231-1-ND | 1 | 1.16 | 1.16 | SMD | in stock | y
2.5V low-dropout regulator | ST | LD117DT25CTR | Digikey | 497-1233-1-ND | 1 | 1.16 | 1.16 | SMD | in stock | y
3.3V low-dropout regulator | ST | LD117DT33CTR | Digikey | 497-1235-1-ND | 1 | 1.16 | 1.16 | SMD | in stock | y
10-segment LED array | Lumex | SSA-LXB10IW-GF/LP | Digikey | 67-1010-ND | 1 | 2.85 | 2.85 |  | in stock | y
330 ohm 5 resistor network | Bournes | 4610X-2-331LF | Digikey | 4610X-2-331LF-ND | 2 | 0.286 | 0.572 |  | in stock | y
FPGA/SAM download connector | Tyco | 5103309-1 | Digikey | A33160-ND | 2 | 0.76 | 1.52 |  | in stock | y
0.1 uF capacitor | Samsung Electro-Mechanics America, Inc | CL21F104ZBCNNNC | Digikey | 1276-1007-1-ND | 5 | 0.1 | 0.5 | SMD | in stock | y
0.01 uF capacitor | Murata Electronics North America | GRM216R71H103KA01D | Digikey | 490-1664-1-ND | 5 | 0.1 | 0.5 | SMD | in stock | y
10 uF capacitor | Taiyo Yuden | LMK212F106ZG-T | Digikey | 587-1312-1-ND | 3 | 0.17 | 0.51 | SMD | in stock | y
1K resistor | Panasonic Electronic Components | ERJ-6GEYJ102V | Digikey | P1.0KACT-ND | 2 | 0.1 | 0.2 | SMD | in stock | y
10K resistor | Panasonic Electronic Components | ERJ-6GEYJ103V | Digikey | P10KACT-ND | 4 | 0.1 | 0.4 | SMD | in stock | y
Edge card connector | samtec | PCIE-036-02-F-D-TH | Digikey | SAM10625-ND | 1 | 1.95 | 1.95 |  | in stock | ordered form #426
Banana socket, board mount, black | Deltron | 571-0100 | Mouser | 164-6218 | 1 | $1.97 | $1.97 |  | in stock | ordered form #427
Banana socket, board mount, red | Deltron | 571-0500 | Mouser | 164-6219 | 1 | $2.34 | $2.34 |  | in stock | ordered form #427
Male-Female Threaded Hex Standoff, 18-8 Stainless Steel, 1/4" Hex, 1-1/2" Long, 8-32 to 8-32 Thread | McMaster-Carr | 91075A458 |  |  | 4 | 2.39 | 9.56 |  | in stock
Machine screw |  |  |  |  | 4 | N/A | N/A

Sheet: uMudd BOM
Description | Manufacturer | Mfr Part # | Supplier | Sup Part # | Quantity | Unit Price | Total Cost | Notes | availability as of November 1
Cyclone IV FPGA | Altera | EP4CE6E22C8N | Digikey | 544-2746-ND | 1 | 11.95 | 11.95 |  | in stock | ordered form #426
FPGA flash | Altera | EPCQ16SI8N | Mouser | 989-EPCQ16SI8N | 1 | 7 | 7 | 8-SOIC | in stock | ordered form #427
microController | Microchip technology | ATSAM4S4BA-AU | Digikey | ATSAM4S4BA-AU-ND | 1 | 3.93 | 3.93 |  | in stock | ordered form #426
Quad DIP switch | Grayhill | 76SB04 | Digikey | GH7170-ND | 1 | 0.92 | 0.92 |  | in stock | y
1.2V low-dropout regulator | ST | LD117DT12TRI | Digikey | 497-1231-1-ND | 1 | 1.16 | 1.16 | SMD | in stock | y
2.5V low-dropout regulator | ST | LD117DT25CTR | Digikey | 497-1233-1-ND | 1 | 1.16 | 1.16 | SMD | in stock | y
3.3V low-dropout regulator | ST | LD117DT33CTR | Digikey | 497-1235-1-ND | 1 | 1.16 | 1.16 | SMD | in stock | y
SPST pushbutton switch | Panasonic | EVQ-PAE04M | Digikey | P8008S-ND | 2 | 0.29 | 0.58 |  | in stock | y
10-segment LED array | Lumex | SSA-LXB10IW-GF/LP | Digikey | 67-1010-ND | 1 | 2.85 | 2.85 |  | in stock | y
330 ohm 5 resistor network | Bournes | 4610X-2-331LF | Digikey | 4610X-2-331LF-ND | 2 | 0.286 | 0.572 |  | in stock | y
FPGA/SAM download connector | Tyco | 5103309-1 | Digikey | A33160-ND | 2 | 0.76 | 1.52 |  | in stock | y
36-pin header | 3M | 929400-01-36-RK | Digikey | 929400E-01-36-ND | 2 | 1.323 | 2.646 |  | in stock | y
2.2Kohm 4 resistor network | Bourns Inc. | 4605X-101-222LF | Mouser | 4605X-101-222LF-ND | 1 | 0.27 | 0.27 |  | in stock | y
1K resistor | Panasonic Electronic Components | ERJ-6GEYJ102V | Digikey | P1.0KACT-ND | 2 | 0.1 | 0.2 | SMD | in stock | y
10K resistor | Panasonic Electronic Components | ERJ-6GEYJ103V | Digikey | P10KACT-ND | 4 | 0.1 | 0.4 | SMD | in stock | y
0.1 uF capacitor | Samsung Electro-Mechanics America, Inc | CL21F104ZBCNNNC | Digikey | 1276-1007-1-ND | 5 | 0.1 | 0.5 | SMD | in stock | y
0.01 uF capacitor | Murata Electronics North America | GRM216R71H103KA01D | Digikey | 490-1664-1-ND | 5 | 0.1 | 0.5 | SMD | in stock | y
10 uF capacitor | Taiyo Yuden | LMK212F106ZG-T | Digikey | 587-1312-1-ND | 3 | 0.17 | 0.51 | SMD | in stock | y

Sheet: Sheet6
A security bit can be set using the Set Security Bit command (SSE). Once the security bit is active, the Fast Flash
programming is disabled. No other command can be run. An event on the Erase pin can erase the security bit
once the contents of the Flash have been erased
Once the security bit is set, it is not possible to access FFPI. The only way to erase the security bit is to erase the
Flash.
In order to erase the Flash, the user must perform the following:
1. Power-off the chip.
2. Power-on the chip with TST = 0.
3. Assert Erase during a period of more than 220 ms.
4. Power-off the chip.
Then it is possible to return to FFPI mode and check that Flash is erased
The ERASE pin is a system I/O pin and can be used as a standard I/O. At startup, the ERASE pin is not configured
as a PIO pin. If the ERASE pin is used as a standard I/O, startup level of this pin must be low to prevent unwanted
erasing. Refer to Section 11.2 “Peripheral Signal Multiplexing on I/O Lines” on page 51. Also, if the ERASE pin is
used as a standard I/O output, asserting the pin to low does not erase the Flash.
