kpezeshki/MuddPiV5/New PCB, no jumpers/uMuddMarkVLayout_3.dxf

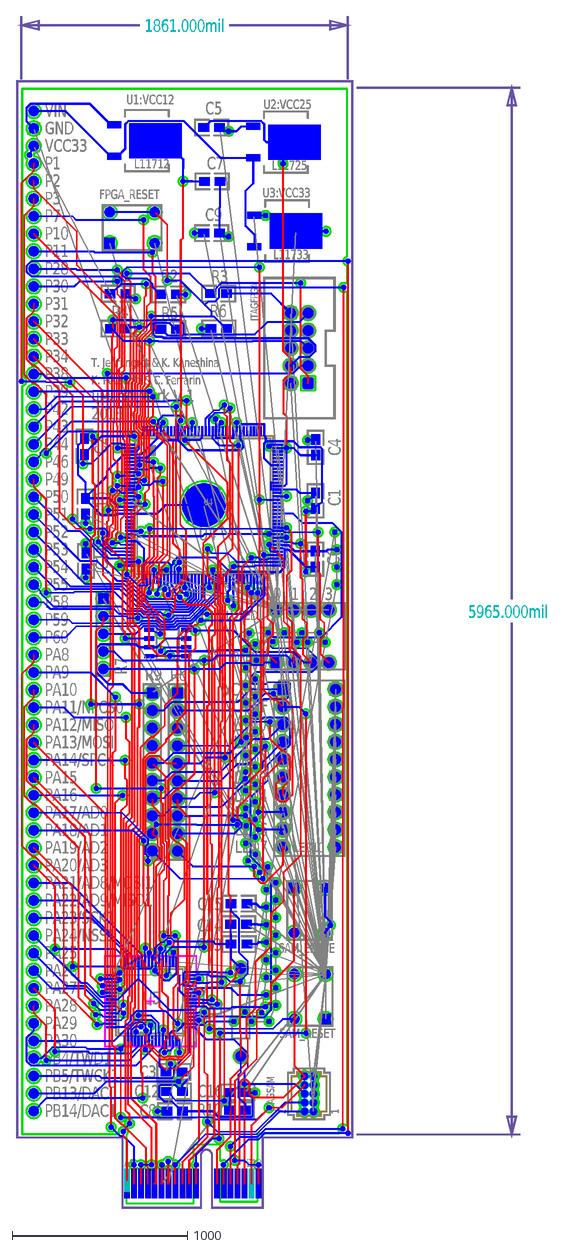
[picture p47: CAD file, 2018-12-12]
New PCB, no jumpers/uMuddMarkVLayout_3.dxf
1861.000mil
5965.000mil
VIN
GND
VCC33
P1
P2
P3
P7
P10
P11
P28
P30
P31
P32
P33
P34
P38
P39
P42
P43
P44
P46
P49
P50
P51
P52
P53
P54
P55
P58
P59
P60
PA8
PA9
PA10
PA11/NPCS0
PA12/MISO
PA13/MOSI
PA14/SPCK
PA15
PA16
PA17/AD0
PA18/AD1
PA19/AD2
PA20/AD3
PA21/AD8/MOSI1
PA22/AD9/MISO1
PA23/SCK1
PA24/NSS1
PA25
PA26
PA27
PA28
PA29
PA30
PB4/TWD1
PB5/TWCK1
PB13/DAC0
PB14/DAC1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
