kpezeshki/MuddPiV5/Pre-Existing Work/DEPRECATED/Tutorial/Router_Session.log.docx

`<000>

`<001>

The following product options expire in fewer than 30 days.

To download and install the most current license file for your Site, follow the instructions found at:

`COMMAND[ 'http://supportnet.mentor.com/reference/technotes/public/technote.cfm?tn=mg243083'][http://supportnet.mentor.com/reference/technotes/public/technote.cfm?tn=mg243083]

Shell in 27 days

General Editing in 27 days

Auto-routing in 27 days

Any Angle in 27 days

Advanced Rules in 27 days

Dynamic Route Editing in 27 days

High-speed Routing (auto) in 27 days

High-speed Routing (manual) in 27 days

Layers in 27 days

Test Point in 27 days

Database Limit in 27 days

Verify Design in 27 days
