kpezeshki/MuddPiV5/Pre-Existing Work/DEPRECATED/Tutorial/pcb.pdf

R2R²x1 | R²x2
U1U¹x1 U¹x2 U¹x3 U¹x4 | U¹x5 U¹x6 U¹x7 U¹x8 | D1D¹xA D¹xK

# C2C²x1 C²x2

# J1J1x1 J1x2

R3R³x1 | R³x2
R1 C1C¹x1 | C¹x2 R¹x1 R¹x2

R2R²x1 | R²x2

# D1D¹xA D¹xK

# C2C²x1 C²x2

# J1J1x1 J1x2

R3R³x1 | R³x2
R1 C1C¹x1 | C¹x2 R¹x1 R¹x2

R2R²x1 | R²x2

# D1D¹xA D¹xK

# C2C²x1 C²x2

# J1J1x1 J1x2

R3R³x1 | R³x2
R1 C1C¹x1 | C¹x2 R¹x1 R¹x2

R2R²x1 | R²x2

# D1D¹xA D¹xK

# C2C²x1 C²x2

# J1J1x1 J1x2

R3R³x1 | R³x2
R1 C1C¹x1 | C¹x2 R¹x1 R¹x2

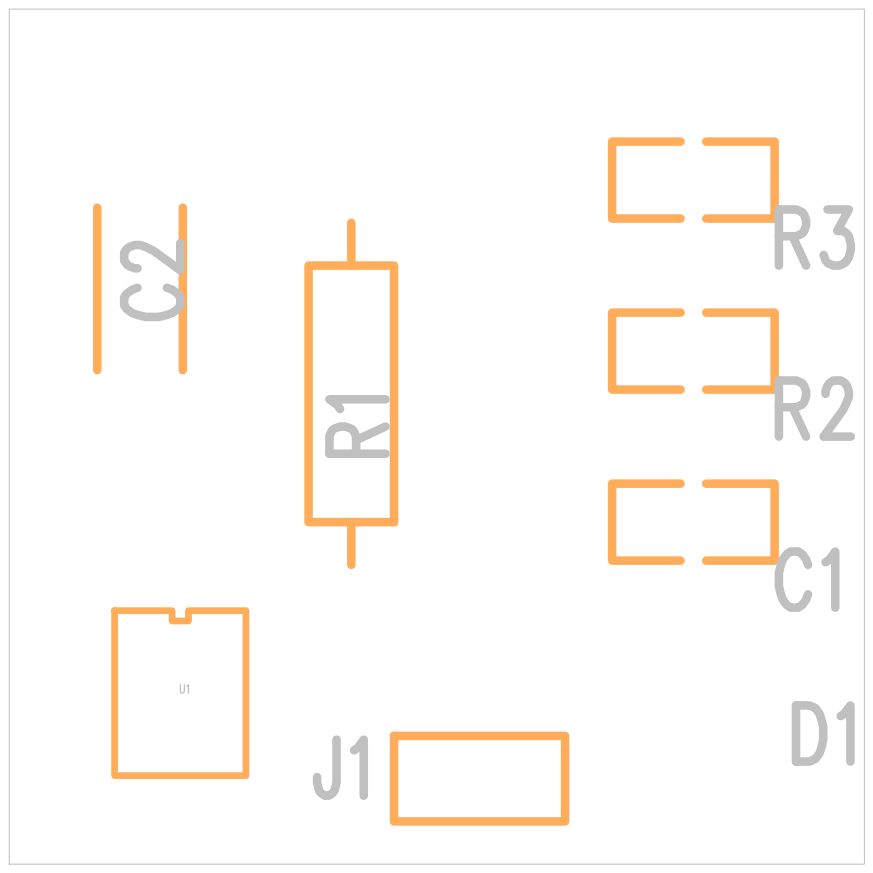
[picture p48: page 5]

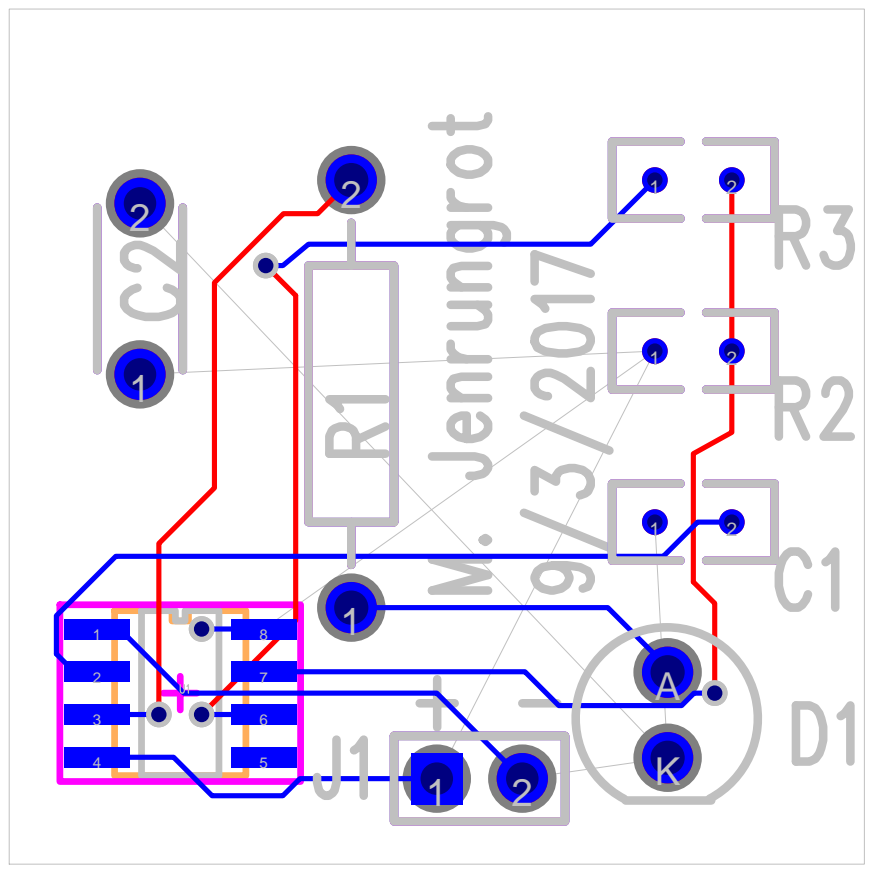
[picture p49: page 7]
