kpezeshki/MuddPiV5/TestProgram/Objects/keil_olimex.htm

# Static Call Graph for image .\Objects\keil_olimex.axf

#<CALLGRAPH># ARM Linker, 5060528: Last Updated: Tue Nov 27 01:31:15 2018

### Maximum Stack Usage = 12 bytes + Unknown(Functions without stacksize, Cycles, Untraceable Function Pointers)

### Call chain for Maximum Stack Depth:

__rt_entry_main ⇒ main ⇒ uartInit

### Functions with no stack information

- __user_initial_stackheap

### Mutually Recursive functions

- NMI_Handler ⇒ NMI_Handler
- HardFault_Handler ⇒ HardFault_Handler
- MemManage_Handler ⇒ MemManage_Handler
- BusFault_Handler ⇒ BusFault_Handler
- UsageFault_Handler ⇒ UsageFault_Handler
- SVC_Handler ⇒ SVC_Handler
- DebugMon_Handler ⇒ DebugMon_Handler
- PendSV_Handler ⇒ PendSV_Handler
- SysTick_Handler ⇒ SysTick_Handler
- ACC_IRQHandler ⇒ ACC_IRQHandler

### Function Pointers

- ACC_IRQHandler from startup_sam3s.o(.text) referenced from startup_sam3s.o(RESET)
- ADC_IRQHandler from startup_sam3s.o(.text) referenced from startup_sam3s.o(RESET)
- BusFault_Handler from startup_sam3s.o(.text) referenced from startup_sam3s.o(RESET)
- CRCCU_IRQHandler from startup_sam3s.o(.text) referenced from startup_sam3s.o(RESET)
- DACC_IRQHandler from startup_sam3s.o(.text) referenced from startup_sam3s.o(RESET)
- DebugMon_Handler from startup_sam3s.o(.text) referenced from startup_sam3s.o(RESET)
- EEFC_IRQHandler from startup_sam3s.o(.text) referenced from startup_sam3s.o(RESET)
- HSMCI_IRQHandler from startup_sam3s.o(.text) referenced from startup_sam3s.o(RESET)
- HardFault_Handler from startup_sam3s.o(.text) referenced from startup_sam3s.o(RESET)
- MemManage_Handler from startup_sam3s.o(.text) referenced from startup_sam3s.o(RESET)
- NMI_Handler from startup_sam3s.o(.text) referenced from startup_sam3s.o(RESET)
- PIOA_IRQHandler from startup_sam3s.o(.text) referenced from startup_sam3s.o(RESET)
- PIOB_IRQHandler from startup_sam3s.o(.text) referenced from startup_sam3s.o(RESET)
- PIOC_IRQHandler from startup_sam3s.o(.text) referenced from startup_sam3s.o(RESET)
- PMC_IRQHandler from startup_sam3s.o(.text) referenced from startup_sam3s.o(RESET)
- PWM_IRQHandler from startup_sam3s.o(.text) referenced from startup_sam3s.o(RESET)
- PendSV_Handler from startup_sam3s.o(.text) referenced from startup_sam3s.o(RESET)
- RSTC_IRQHandler from startup_sam3s.o(.text) referenced from startup_sam3s.o(RESET)
- RTC_IRQHandler from startup_sam3s.o(.text) referenced from startup_sam3s.o(RESET)
- RTT_IRQHandler from startup_sam3s.o(.text) referenced from startup_sam3s.o(RESET)
- Reset_Handler from startup_sam3s.o(.text) referenced from startup_sam3s.o(RESET)
- SPI_IRQHandler from startup_sam3s.o(.text) referenced from startup_sam3s.o(RESET)
- SSC_IRQHandler from startup_sam3s.o(.text) referenced from startup_sam3s.o(RESET)
- SUPC_IRQHandler from startup_sam3s.o(.text) referenced from startup_sam3s.o(RESET)
- SVC_Handler from startup_sam3s.o(.text) referenced from startup_sam3s.o(RESET)
- SysTick_Handler from startup_sam3s.o(.text) referenced from startup_sam3s.o(RESET)
- SystemInit from system_sam3s.o(i.SystemInit) referenced from startup_sam3s.o(.text)
- TC0_IRQHandler from startup_sam3s.o(.text) referenced from startup_sam3s.o(RESET)
- TC1_IRQHandler from startup_sam3s.o(.text) referenced from startup_sam3s.o(RESET)
- TC2_IRQHandler from startup_sam3s.o(.text) referenced from startup_sam3s.o(RESET)
- TC3_IRQHandler from startup_sam3s.o(.text) referenced from startup_sam3s.o(RESET)
- TC4_IRQHandler from startup_sam3s.o(.text) referenced from startup_sam3s.o(RESET)
- TC5_IRQHandler from startup_sam3s.o(.text) referenced from startup_sam3s.o(RESET)
- TWI0_IRQHandler from startup_sam3s.o(.text) referenced from startup_sam3s.o(RESET)
- TWI1_IRQHandler from startup_sam3s.o(.text) referenced from startup_sam3s.o(RESET)
- UART0_IRQHandler from startup_sam3s.o(.text) referenced from startup_sam3s.o(RESET)
- UART1_IRQHandler from startup_sam3s.o(.text) referenced from startup_sam3s.o(RESET)
- UDP_IRQHandler from startup_sam3s.o(.text) referenced from startup_sam3s.o(RESET)
- USART0_IRQHandler from startup_sam3s.o(.text) referenced from startup_sam3s.o(RESET)
- USART1_IRQHandler from startup_sam3s.o(.text) referenced from startup_sam3s.o(RESET)
- UsageFault_Handler from startup_sam3s.o(.text) referenced from startup_sam3s.o(RESET)
- WDT_IRQHandler from startup_sam3s.o(.text) referenced from startup_sam3s.o(RESET)
- __main from __main.o(!!!main) referenced from startup_sam3s.o(.text)

### Global Symbols

__main (Thumb, 8 bytes, Stack size 0 bytes, __main.o(!!!main))

[Calls]

- >> __scatterload
- >> __rt_entry

__scatterload (Thumb, 0 bytes, Stack size unknown bytes, __scatter.o(!!!scatter))

[Called By]

- >> __main

__scatterload_rt2 (Thumb, 44 bytes, Stack size unknown bytes, __scatter.o(!!!scatter), UNUSED)

[Calls]

- >> __rt_entry

__scatterload_rt2_thumb_only (Thumb, 0 bytes, Stack size unknown bytes, __scatter.o(!!!scatter), UNUSED)

__scatterload_null (Thumb, 0 bytes, Stack size unknown bytes, __scatter.o(!!!scatter), UNUSED)

__scatterload_zeroinit (Thumb, 28 bytes, Stack size unknown bytes, __scatter_zi.o(!!handler_zi), UNUSED)

__rt_lib_init (Thumb, 0 bytes, Stack size unknown bytes, libinit.o(.ARM.Collect$$libinit$$00000000))

[Called By]

- >> __rt_entry_li

__rt_lib_init_alloca_1 (Thumb, 0 bytes, Stack size unknown bytes, libinit2.o(.ARM.Collect$$libinit$$0000002E))

__rt_lib_init_argv_1 (Thumb, 0 bytes, Stack size unknown bytes, libinit2.o(.ARM.Collect$$libinit$$0000002C))

__rt_lib_init_atexit_1 (Thumb, 0 bytes, Stack size unknown bytes, libinit2.o(.ARM.Collect$$libinit$$0000001B))

__rt_lib_init_clock_1 (Thumb, 0 bytes, Stack size unknown bytes, libinit2.o(.ARM.Collect$$libinit$$00000021))

__rt_lib_init_cpp_1 (Thumb, 0 bytes, Stack size unknown bytes, libinit2.o(.ARM.Collect$$libinit$$00000032))

__rt_lib_init_exceptions_1 (Thumb, 0 bytes, Stack size unknown bytes, libinit2.o(.ARM.Collect$$libinit$$00000030))

__rt_lib_init_fp_1 (Thumb, 0 bytes, Stack size unknown bytes, libinit2.o(.ARM.Collect$$libinit$$00000002))

__rt_lib_init_fp_trap_1 (Thumb, 0 bytes, Stack size unknown bytes, libinit2.o(.ARM.Collect$$libinit$$0000001F))

__rt_lib_init_getenv_1 (Thumb, 0 bytes, Stack size unknown bytes, libinit2.o(.ARM.Collect$$libinit$$00000023))

__rt_lib_init_heap_1 (Thumb, 0 bytes, Stack size unknown bytes, libinit2.o(.ARM.Collect$$libinit$$0000000A))

__rt_lib_init_lc_collate_1 (Thumb, 0 bytes, Stack size unknown bytes, libinit2.o(.ARM.Collect$$libinit$$00000011))

__rt_lib_init_lc_ctype_1 (Thumb, 0 bytes, Stack size unknown bytes, libinit2.o(.ARM.Collect$$libinit$$00000013))

__rt_lib_init_lc_monetary_1 (Thumb, 0 bytes, Stack size unknown bytes, libinit2.o(.ARM.Collect$$libinit$$00000015))

__rt_lib_init_lc_numeric_1 (Thumb, 0 bytes, Stack size unknown bytes, libinit2.o(.ARM.Collect$$libinit$$00000017))

__rt_lib_init_lc_time_1 (Thumb, 0 bytes, Stack size unknown bytes, libinit2.o(.ARM.Collect$$libinit$$00000019))

__rt_lib_init_preinit_1 (Thumb, 0 bytes, Stack size unknown bytes, libinit2.o(.ARM.Collect$$libinit$$00000004))

__rt_lib_init_rand_1 (Thumb, 0 bytes, Stack size unknown bytes, libinit2.o(.ARM.Collect$$libinit$$0000000E))

__rt_lib_init_return (Thumb, 0 bytes, Stack size unknown bytes, libinit2.o(.ARM.Collect$$libinit$$00000033))

__rt_lib_init_signal_1 (Thumb, 0 bytes, Stack size unknown bytes, libinit2.o(.ARM.Collect$$libinit$$0000001D))

__rt_lib_init_stdio_1 (Thumb, 0 bytes, Stack size unknown bytes, libinit2.o(.ARM.Collect$$libinit$$00000025))

__rt_lib_init_user_alloc_1 (Thumb, 0 bytes, Stack size unknown bytes, libinit2.o(.ARM.Collect$$libinit$$0000000C))

__rt_lib_shutdown (Thumb, 0 bytes, Stack size unknown bytes, libshutdown.o(.ARM.Collect$$libshutdown$$00000000))

[Called By]

- >> __rt_exit_ls

__rt_lib_shutdown_cpp_1 (Thumb, 0 bytes, Stack size unknown bytes, libshutdown2.o(.ARM.Collect$$libshutdown$$00000002))

__rt_lib_shutdown_fp_trap_1 (Thumb, 0 bytes, Stack size unknown bytes, libshutdown2.o(.ARM.Collect$$libshutdown$$00000007))

__rt_lib_shutdown_heap_1 (Thumb, 0 bytes, Stack size unknown bytes, libshutdown2.o(.ARM.Collect$$libshutdown$$0000000F))

__rt_lib_shutdown_return (Thumb, 0 bytes, Stack size unknown bytes, libshutdown2.o(.ARM.Collect$$libshutdown$$00000010))

__rt_lib_shutdown_signal_1 (Thumb, 0 bytes, Stack size unknown bytes, libshutdown2.o(.ARM.Collect$$libshutdown$$0000000A))

__rt_lib_shutdown_stdio_1 (Thumb, 0 bytes, Stack size unknown bytes, libshutdown2.o(.ARM.Collect$$libshutdown$$00000004))

__rt_lib_shutdown_user_alloc_1 (Thumb, 0 bytes, Stack size unknown bytes, libshutdown2.o(.ARM.Collect$$libshutdown$$0000000C))

__rt_entry (Thumb, 0 bytes, Stack size unknown bytes, __rtentry.o(.ARM.Collect$$rtentry$$00000000))

[Called By]

- >> __scatterload_rt2
- >> __main

__rt_entry_presh_1 (Thumb, 0 bytes, Stack size unknown bytes, __rtentry2.o(.ARM.Collect$$rtentry$$00000002))

__rt_entry_sh (Thumb, 0 bytes, Stack size unknown bytes, __rtentry4.o(.ARM.Collect$$rtentry$$00000004))

[Stack]

- Max Depth = 8 + Unknown Stack Size
- Call Chain = __rt_entry_sh ⇒ __user_setup_stackheap

[Calls]

- >> __user_setup_stackheap

__rt_entry_li (Thumb, 0 bytes, Stack size unknown bytes, __rtentry2.o(.ARM.Collect$$rtentry$$0000000A))

[Calls]

- >> __rt_lib_init

__rt_entry_postsh_1 (Thumb, 0 bytes, Stack size unknown bytes, __rtentry2.o(.ARM.Collect$$rtentry$$00000009))

__rt_entry_main (Thumb, 0 bytes, Stack size unknown bytes, __rtentry2.o(.ARM.Collect$$rtentry$$0000000D))

[Stack]

- Max Depth = 12 + Unknown Stack Size
- Call Chain = __rt_entry_main ⇒ main ⇒ uartInit

[Calls]

- >> exit
- >> main

__rt_entry_postli_1 (Thumb, 0 bytes, Stack size unknown bytes, __rtentry2.o(.ARM.Collect$$rtentry$$0000000C))

__rt_exit (Thumb, 0 bytes, Stack size unknown bytes, rtexit.o(.ARM.Collect$$rtexit$$00000000))

[Called By]

- >> exit

__rt_exit_ls (Thumb, 0 bytes, Stack size unknown bytes, rtexit2.o(.ARM.Collect$$rtexit$$00000003))

[Calls]

- >> __rt_lib_shutdown

__rt_exit_prels_1 (Thumb, 0 bytes, Stack size unknown bytes, rtexit2.o(.ARM.Collect$$rtexit$$00000002))

__rt_exit_exit (Thumb, 0 bytes, Stack size unknown bytes, rtexit2.o(.ARM.Collect$$rtexit$$00000004))

[Calls]

- >> _sys_exit

Reset_Handler (Thumb, 8 bytes, Stack size 0 bytes, startup_sam3s.o(.text))

NMI_Handler (Thumb, 2 bytes, Stack size 0 bytes, startup_sam3s.o(.text))

[Calls]

- >> NMI_Handler

[Called By]

- >> NMI_Handler

[Address Reference Count : 1]

- startup_sam3s.o(RESET)

HardFault_Handler (Thumb, 2 bytes, Stack size 0 bytes, startup_sam3s.o(.text))

[Calls]

- >> HardFault_Handler

[Called By]

- >> HardFault_Handler

[Address Reference Count : 1]

- startup_sam3s.o(RESET)

MemManage_Handler (Thumb, 2 bytes, Stack size 0 bytes, startup_sam3s.o(.text))

[Calls]

- >> MemManage_Handler

[Called By]

- >> MemManage_Handler

[Address Reference Count : 1]

- startup_sam3s.o(RESET)

BusFault_Handler (Thumb, 2 bytes, Stack size 0 bytes, startup_sam3s.o(.text))

[Calls]

- >> BusFault_Handler

[Called By]

- >> BusFault_Handler

[Address Reference Count : 1]

- startup_sam3s.o(RESET)

UsageFault_Handler (Thumb, 2 bytes, Stack size 0 bytes, startup_sam3s.o(.text))

[Calls]

- >> UsageFault_Handler

[Called By]

- >> UsageFault_Handler

[Address Reference Count : 1]

- startup_sam3s.o(RESET)

SVC_Handler (Thumb, 2 bytes, Stack size 0 bytes, startup_sam3s.o(.text))

[Calls]

- >> SVC_Handler

[Called By]

- >> SVC_Handler

[Address Reference Count : 1]

- startup_sam3s.o(RESET)

DebugMon_Handler (Thumb, 2 bytes, Stack size 0 bytes, startup_sam3s.o(.text))

[Calls]

- >> DebugMon_Handler

[Called By]

- >> DebugMon_Handler

[Address Reference Count : 1]

- startup_sam3s.o(RESET)

PendSV_Handler (Thumb, 2 bytes, Stack size 0 bytes, startup_sam3s.o(.text))

[Calls]

- >> PendSV_Handler

[Called By]

- >> PendSV_Handler

[Address Reference Count : 1]

- startup_sam3s.o(RESET)

SysTick_Handler (Thumb, 2 bytes, Stack size 0 bytes, startup_sam3s.o(.text))

[Calls]

- >> SysTick_Handler

[Called By]

- >> SysTick_Handler

[Address Reference Count : 1]

- startup_sam3s.o(RESET)

ACC_IRQHandler (Thumb, 0 bytes, Stack size 0 bytes, startup_sam3s.o(.text))

[Calls]

- >> ACC_IRQHandler

[Called By]

- >> ACC_IRQHandler

[Address Reference Count : 1]

- startup_sam3s.o(RESET)

ADC_IRQHandler (Thumb, 0 bytes, Stack size 0 bytes, startup_sam3s.o(.text))
[Address Reference Count : 1]

- startup_sam3s.o(RESET)

CRCCU_IRQHandler (Thumb, 0 bytes, Stack size 0 bytes, startup_sam3s.o(.text))
[Address Reference Count : 1]

- startup_sam3s.o(RESET)

DACC_IRQHandler (Thumb, 0 bytes, Stack size 0 bytes, startup_sam3s.o(.text))
[Address Reference Count : 1]

- startup_sam3s.o(RESET)

EEFC_IRQHandler (Thumb, 0 bytes, Stack size 0 bytes, startup_sam3s.o(.text))
[Address Reference Count : 1]

- startup_sam3s.o(RESET)

HSMCI_IRQHandler (Thumb, 0 bytes, Stack size 0 bytes, startup_sam3s.o(.text))
[Address Reference Count : 1]

- startup_sam3s.o(RESET)

PIOA_IRQHandler (Thumb, 0 bytes, Stack size 0 bytes, startup_sam3s.o(.text))
[Address Reference Count : 1]

- startup_sam3s.o(RESET)

PIOB_IRQHandler (Thumb, 0 bytes, Stack size 0 bytes, startup_sam3s.o(.text))
[Address Reference Count : 1]

- startup_sam3s.o(RESET)

PIOC_IRQHandler (Thumb, 0 bytes, Stack size 0 bytes, startup_sam3s.o(.text))
[Address Reference Count : 1]

- startup_sam3s.o(RESET)

PMC_IRQHandler (Thumb, 0 bytes, Stack size 0 bytes, startup_sam3s.o(.text))
[Address Reference Count : 1]

- startup_sam3s.o(RESET)

PWM_IRQHandler (Thumb, 0 bytes, Stack size 0 bytes, startup_sam3s.o(.text))
[Address Reference Count : 1]

- startup_sam3s.o(RESET)

RSTC_IRQHandler (Thumb, 0 bytes, Stack size 0 bytes, startup_sam3s.o(.text))
[Address Reference Count : 1]

- startup_sam3s.o(RESET)

RTC_IRQHandler (Thumb, 0 bytes, Stack size 0 bytes, startup_sam3s.o(.text))
[Address Reference Count : 1]

- startup_sam3s.o(RESET)

RTT_IRQHandler (Thumb, 0 bytes, Stack size 0 bytes, startup_sam3s.o(.text))
[Address Reference Count : 1]

- startup_sam3s.o(RESET)

SMC_IRQHandler (Thumb, 0 bytes, Stack size 0 bytes, startup_sam3s.o(.text), UNUSED, KEPT)

SPI_IRQHandler (Thumb, 0 bytes, Stack size 0 bytes, startup_sam3s.o(.text))
[Address Reference Count : 1]

- startup_sam3s.o(RESET)

SSC_IRQHandler (Thumb, 0 bytes, Stack size 0 bytes, startup_sam3s.o(.text))
[Address Reference Count : 1]

- startup_sam3s.o(RESET)

SUPC_IRQHandler (Thumb, 0 bytes, Stack size 0 bytes, startup_sam3s.o(.text))
[Address Reference Count : 1]

- startup_sam3s.o(RESET)

TC0_IRQHandler (Thumb, 0 bytes, Stack size 0 bytes, startup_sam3s.o(.text))
[Address Reference Count : 1]

- startup_sam3s.o(RESET)

TC1_IRQHandler (Thumb, 0 bytes, Stack size 0 bytes, startup_sam3s.o(.text))
[Address Reference Count : 1]

- startup_sam3s.o(RESET)

TC2_IRQHandler (Thumb, 0 bytes, Stack size 0 bytes, startup_sam3s.o(.text))
[Address Reference Count : 1]

- startup_sam3s.o(RESET)

TC3_IRQHandler (Thumb, 0 bytes, Stack size 0 bytes, startup_sam3s.o(.text))
[Address Reference Count : 1]

- startup_sam3s.o(RESET)

TC4_IRQHandler (Thumb, 0 bytes, Stack size 0 bytes, startup_sam3s.o(.text))
[Address Reference Count : 1]

- startup_sam3s.o(RESET)

TC5_IRQHandler (Thumb, 0 bytes, Stack size 0 bytes, startup_sam3s.o(.text))
[Address Reference Count : 1]

- startup_sam3s.o(RESET)

TWI0_IRQHandler (Thumb, 0 bytes, Stack size 0 bytes, startup_sam3s.o(.text))
[Address Reference Count : 1]

- startup_sam3s.o(RESET)

TWI1_IRQHandler (Thumb, 0 bytes, Stack size 0 bytes, startup_sam3s.o(.text))
[Address Reference Count : 1]

- startup_sam3s.o(RESET)

UART0_IRQHandler (Thumb, 0 bytes, Stack size 0 bytes, startup_sam3s.o(.text))
[Address Reference Count : 1]

- startup_sam3s.o(RESET)

UART1_IRQHandler (Thumb, 0 bytes, Stack size 0 bytes, startup_sam3s.o(.text))
[Address Reference Count : 1]

- startup_sam3s.o(RESET)

UDP_IRQHandler (Thumb, 0 bytes, Stack size 0 bytes, startup_sam3s.o(.text))
[Address Reference Count : 1]

- startup_sam3s.o(RESET)

USART0_IRQHandler (Thumb, 0 bytes, Stack size 0 bytes, startup_sam3s.o(.text))
[Address Reference Count : 1]

- startup_sam3s.o(RESET)

USART1_IRQHandler (Thumb, 0 bytes, Stack size 0 bytes, startup_sam3s.o(.text))
[Address Reference Count : 1]

- startup_sam3s.o(RESET)

WDT_IRQHandler (Thumb, 0 bytes, Stack size 0 bytes, startup_sam3s.o(.text))
[Address Reference Count : 1]

- startup_sam3s.o(RESET)

__user_initial_stackheap (Thumb, 0 bytes, Stack size unknown bytes, startup_sam3s.o(.text))

[Called By]

- >> __user_setup_stackheap

__use_two_region_memory (Thumb, 2 bytes, Stack size 0 bytes, heapauxi.o(.text), UNUSED)

__rt_heap_escrow$2region (Thumb, 2 bytes, Stack size 0 bytes, heapauxi.o(.text), UNUSED)

__rt_heap_expand$2region (Thumb, 2 bytes, Stack size 0 bytes, heapauxi.o(.text), UNUSED)

__user_setup_stackheap (Thumb, 74 bytes, Stack size 8 bytes, sys_stackheap_outer.o(.text))

[Stack]

- Max Depth = 8 + Unknown Stack Size
- Call Chain = __user_setup_stackheap

[Calls]

- >> __user_perproc_libspace
- >> __user_initial_stackheap

[Called By]

- >> __rt_entry_sh

exit (Thumb, 18 bytes, Stack size 8 bytes, exit.o(.text))

[Stack]

- Max Depth = 8 + Unknown Stack Size
- Call Chain = exit

[Calls]

- >> __rt_exit

[Called By]

- >> __rt_entry_main

__user_libspace (Thumb, 8 bytes, Stack size 0 bytes, libspace.o(.text), UNUSED)

__user_perproc_libspace (Thumb, 0 bytes, Stack size 0 bytes, libspace.o(.text))

[Called By]

- >> __user_setup_stackheap

__user_perthread_libspace (Thumb, 0 bytes, Stack size 0 bytes, libspace.o(.text), UNUSED)

_sys_exit (Thumb, 8 bytes, Stack size 0 bytes, sys_exit.o(.text))

[Called By]

- >> __rt_exit_exit

__I$use$semihosting (Thumb, 0 bytes, Stack size 0 bytes, use_no_semi.o(.text), UNUSED)

__use_no_semihosting_swi (Thumb, 2 bytes, Stack size 0 bytes, use_no_semi.o(.text), UNUSED)

__semihosting_library_function (Thumb, 0 bytes, Stack size unknown bytes, indicate_semi.o(.text), UNUSED)

SystemInit (Thumb, 238 bytes, Stack size 0 bytes, system_sam3s.o(i.SystemInit))
[Address Reference Count : 1]

- startup_sam3s.o(.text)

main (Thumb, 28 bytes, Stack size 0 bytes, main.o(i.main))

[Stack]

- Max Depth = 12
- Call Chain = main ⇒ uartInit

[Calls]

- >> uartTx
- >> uartRx
- >> uartInit
- >> pioInit

[Called By]

- >> __rt_entry_main

pinMode (Thumb, 494 bytes, Stack size 0 bytes, main.o(i.pinMode))

[Called By]

- >> uartInit

pioInit (Thumb, 14 bytes, Stack size 0 bytes, main.o(i.pioInit))

[Called By]

- >> main

uartInit (Thumb, 86 bytes, Stack size 12 bytes, main.o(i.uartInit))

[Stack]

- Max Depth = 12
- Call Chain = uartInit

[Calls]

- >> pinMode

[Called By]

- >> main

uartRx (Thumb, 24 bytes, Stack size 0 bytes, main.o(i.uartRx))

[Called By]

- >> main

uartTx (Thumb, 22 bytes, Stack size 0 bytes, main.o(i.uartTx))

[Called By]

- >> main

### Local Symbols

### Undefined Global Symbols
