kpezeshki/MuddPiV5/Final Report/uMuddMarkVTesterLogic_letter.pdf

GND GND

<Released By> <Release Date>

uMudd Mark V Tester Board
