kpezeshki/MuddPiV5/Final Report/uMuddMarkVTesterLogic.pdf

D

6 | 5 | 4 | 3 | 2 | 1

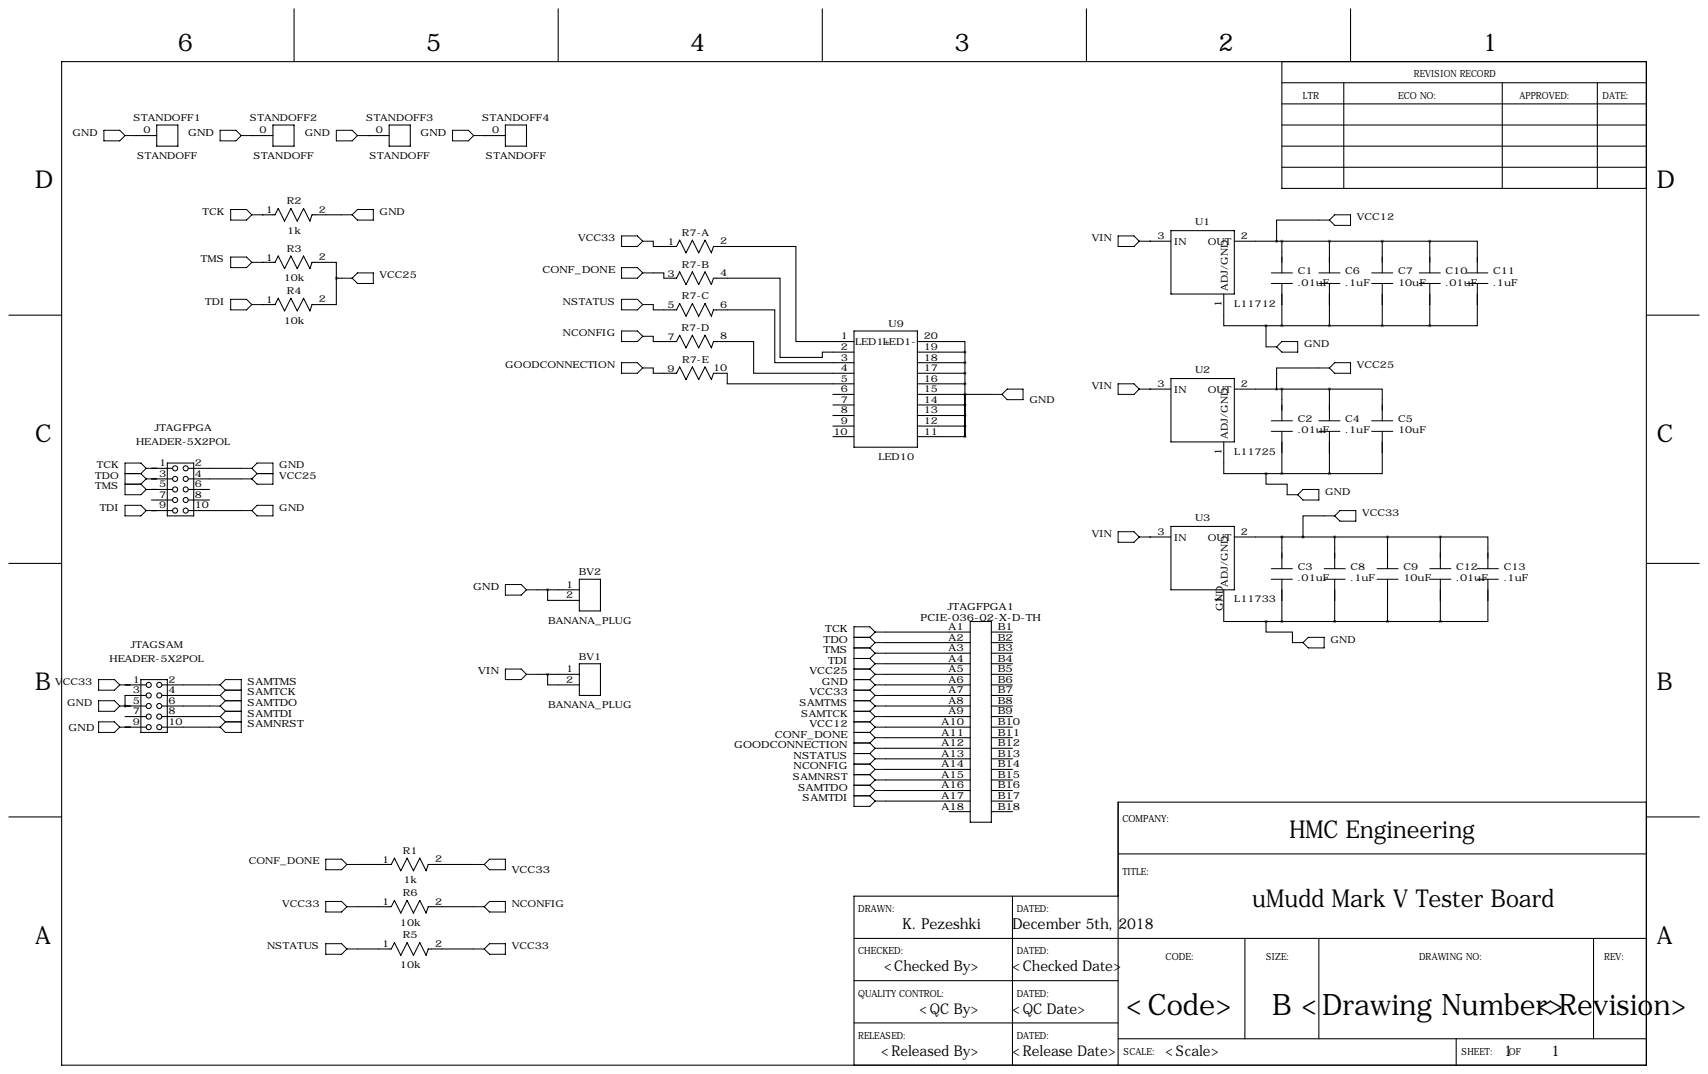
[picture p54: page 1]

STANDOFF1 STANDOFF2 STANDOFF3 STANDOFF4 | REVISION RECORD

LTR | ECO NO: | APPROVED: | DATE:

uMudd Mark V Tester Board

DRAWN: K. Pezeshki | DATED: December 5th, 2018

CHECKED: <Checked By> | DATED: <Checked Date> | CODE: | SIZE: | DRAWING NO: | REV:

QUALITY CONTROL: <QC By> | DATED: <QC Date>

RELEASED: <Released By> | DATED: <Release Date>

<Scale> SCALE: | 1 1 SHEET: OF
