kpezeshki/MuddPiV5/New PCB, no jumpers/uMuddMarkVTesterLayout_blz.pdf

# BV2BV²x1 BV²x2

# BV1BV¹x1 BV¹x2

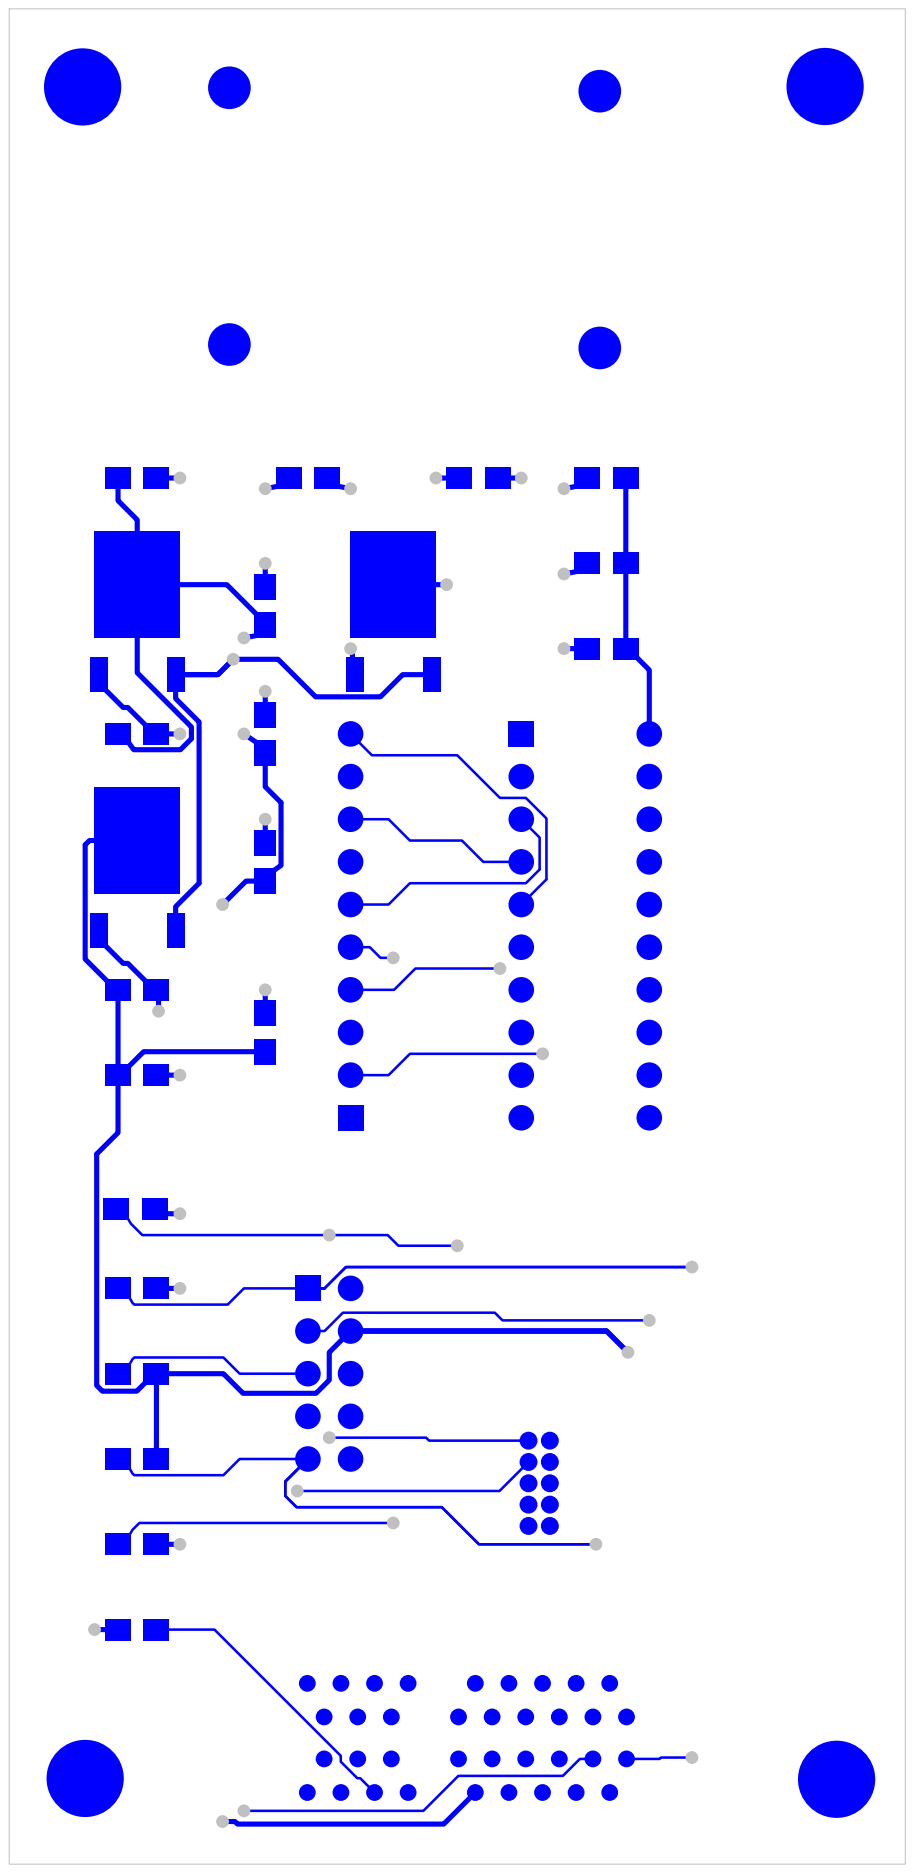
[picture p55: page 1]
JTAGSAM JTAGSAMx2 JTAGSAMx1 JTAGSAMx4 JTAGSAMx3 JTAGSAMx6 JTAGSAMx5 JTAGSAMx8 JTAGSAMx7 JTAGSAMx10 JTAGSAMx9; C5C⁵x1; C⁵x2; U9U⁹x1 U⁹x2 U⁹x3 U⁹x4 U⁹x5 U⁹x6 U⁹x7 U⁹x8 U⁹x9 U⁹x10; U⁹x11 U⁹x12 U⁹x13 U⁹x14 U⁹x15 U⁹x16 U⁹x17 U⁹x18 U⁹x19 U⁹x20; C13C¹³x1; C¹³x2; C12C¹²x1; C¹²x2; C9C⁹x1; C⁹x2; C8C⁸x1; C⁸x2; R7R⁷x1 R⁷x2 R⁷x3 R⁷x4 R⁷x5 R⁷x6 R⁷x7 R⁷x8 R⁷x9 R⁷x10; U3U³x1 U³x2 U³x3; C3C³x1; C³x2; C6C⁶x1 C⁶x2; C7C⁷x1 C⁷x2; C11C¹¹x1 C¹¹x2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

# BV2BV²x1 BV²x2

# BV1BV¹x1

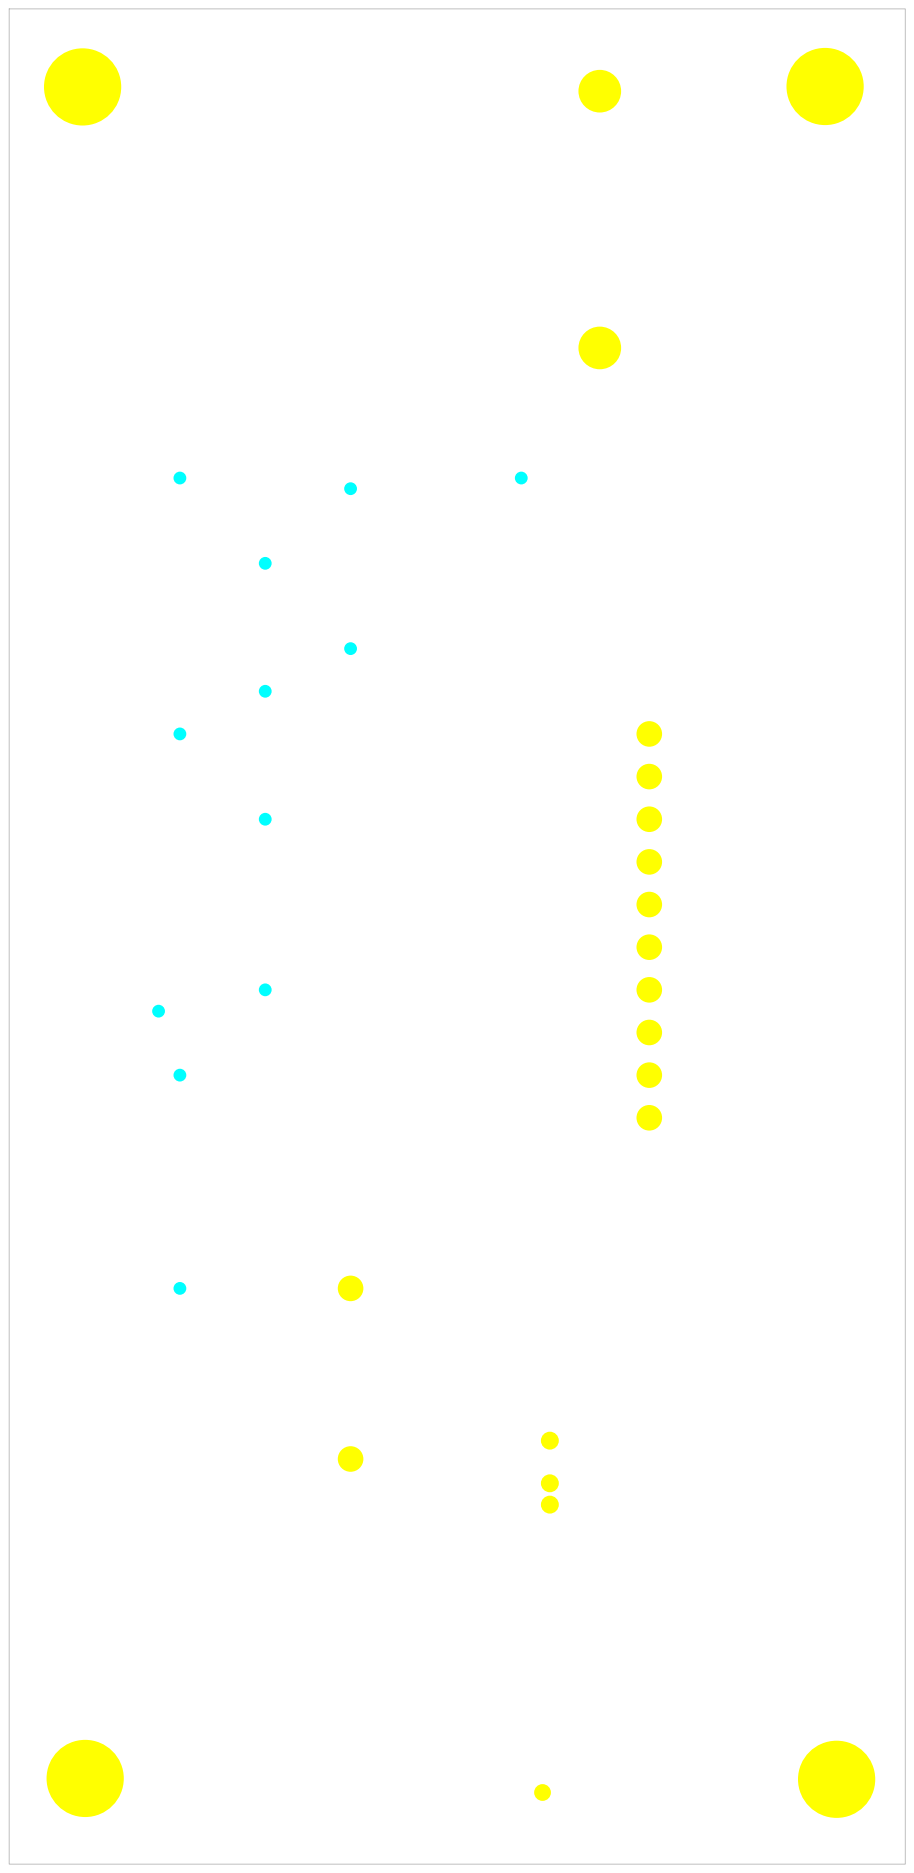
[picture p56: page 2]
JTAGSAM JTAGSAMx2 JTAGSAMx1 JTAGSAMx4 JTAGSAMx3 JTAGSAMx6 JTAGSAMx5 JTAGSAMx8 JTAGSAMx7 JTAGSAMx10 JTAGSAMx9; U9U⁹x1 U⁹x2 U⁹x3 U⁹x4 U⁹x5 U⁹x6 U⁹x7 U⁹x8 U⁹x9 U⁹x10; U⁹x11 U⁹x12 U⁹x13 U⁹x14 U⁹x15 U⁹x16 U⁹x17 U⁹x18 U⁹x19 U⁹x20; R7R⁷x1 R⁷x2 R⁷x3 R⁷x4 R⁷x5 R⁷x6 R⁷x7 R⁷x8 R⁷x9 R⁷x10; JTAGFPGA JTAGFPGAx1 JTAGFPGAx2 JTAGFPGAx3 JTAGFPGAx4 JTAGFPGAx5 JTAGFPGAx6 JTAGFPGAx7 JTAGFPGAx8 JTAGFPGAx9 JTAGFPGAx10; STANDOFF1; STANDOFF1x0; STANDOFF2STANDOFF2x0; STANDOFF4STANDOFF4x0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

JTAGSAM JTAGSAMx2 JTAGSAMx1 JTAGSAMx4 JTAGSAMx3 JTAGSAMx6 JTAGSAMx5 JTAGSAMx8 JTAGSAMx7 JTAGSAMx10 JTAGSAMx9

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

# BV2BV²x1 BV²x2

# R7R⁷x1 R⁷x2 R⁷x3 R⁷x4 R⁷x5 R⁷x6 R⁷x7 R⁷x8 R⁷x9 R⁷x10

JTAGFPGA JTAGFPGAx1 JTAGFPGAx2 JTAGFPGAx3 JTAGFPGAx4 JTAGFPGAx5 JTAGFPGAx6 JTAGFPGAx7 JTAGFPGAx8 JTAGFPGAx9 JTAGFPGAx10

# BV1BV¹x1

# STANDOFF1

# STANDOFF1x0

# STANDOFF2STANDOFF2x0

STANDOFF4STANDOFF4x0 | JTAGFPGA1 STANDOFF3STANDOFF3x0 JTAGFPGA¹xA¹ JTAGFPGA¹xA² JTAGFPGA¹xA³ JTAGFPGA¹xA⁴ JTAGFPGA¹xA⁵ JTAGFPGA¹xA⁶ JTAGFPGA¹xA⁷ JTAGFPGA¹xA⁸ JTAGFPGA¹xA⁹ JTAGFPGA¹xA¹⁰ JTAGFPGA¹xA¹¹ JTAGFPGA¹xA¹² JTAGFPGA¹xA¹³ JTAGFPGA¹xA¹⁴ JTAGFPGA¹xA¹⁵ JTAGFPGA¹xA¹⁶ JTAGFPGA¹xA¹⁷ JTAGFPGA¹xA¹⁸ | JTAGFPGA¹xB¹ JTAGFPGA¹xB² JTAGFPGA¹xB³ JTAGFPGA¹xB⁴ JTAGFPGA¹xB⁵ JTAGFPGA¹xB⁶ JTAGFPGA¹xB⁷ JTAGFPGA¹xB⁸ JTAGFPGA¹xB⁹ JTAGFPGA¹xB¹⁰ JTAGFPGA¹xB¹¹ JTAGFPGA¹xB¹² JTAGFPGA¹xB¹³ JTAGFPGA¹xB¹⁴ JTAGFPGA¹xB¹⁵ JTAGFPGA¹xB¹⁶ JTAGFPGA¹xB¹⁷ JTAGFPGA¹xB¹⁸

# BV2BV²x1 BV²x2

# BV1BV¹x1

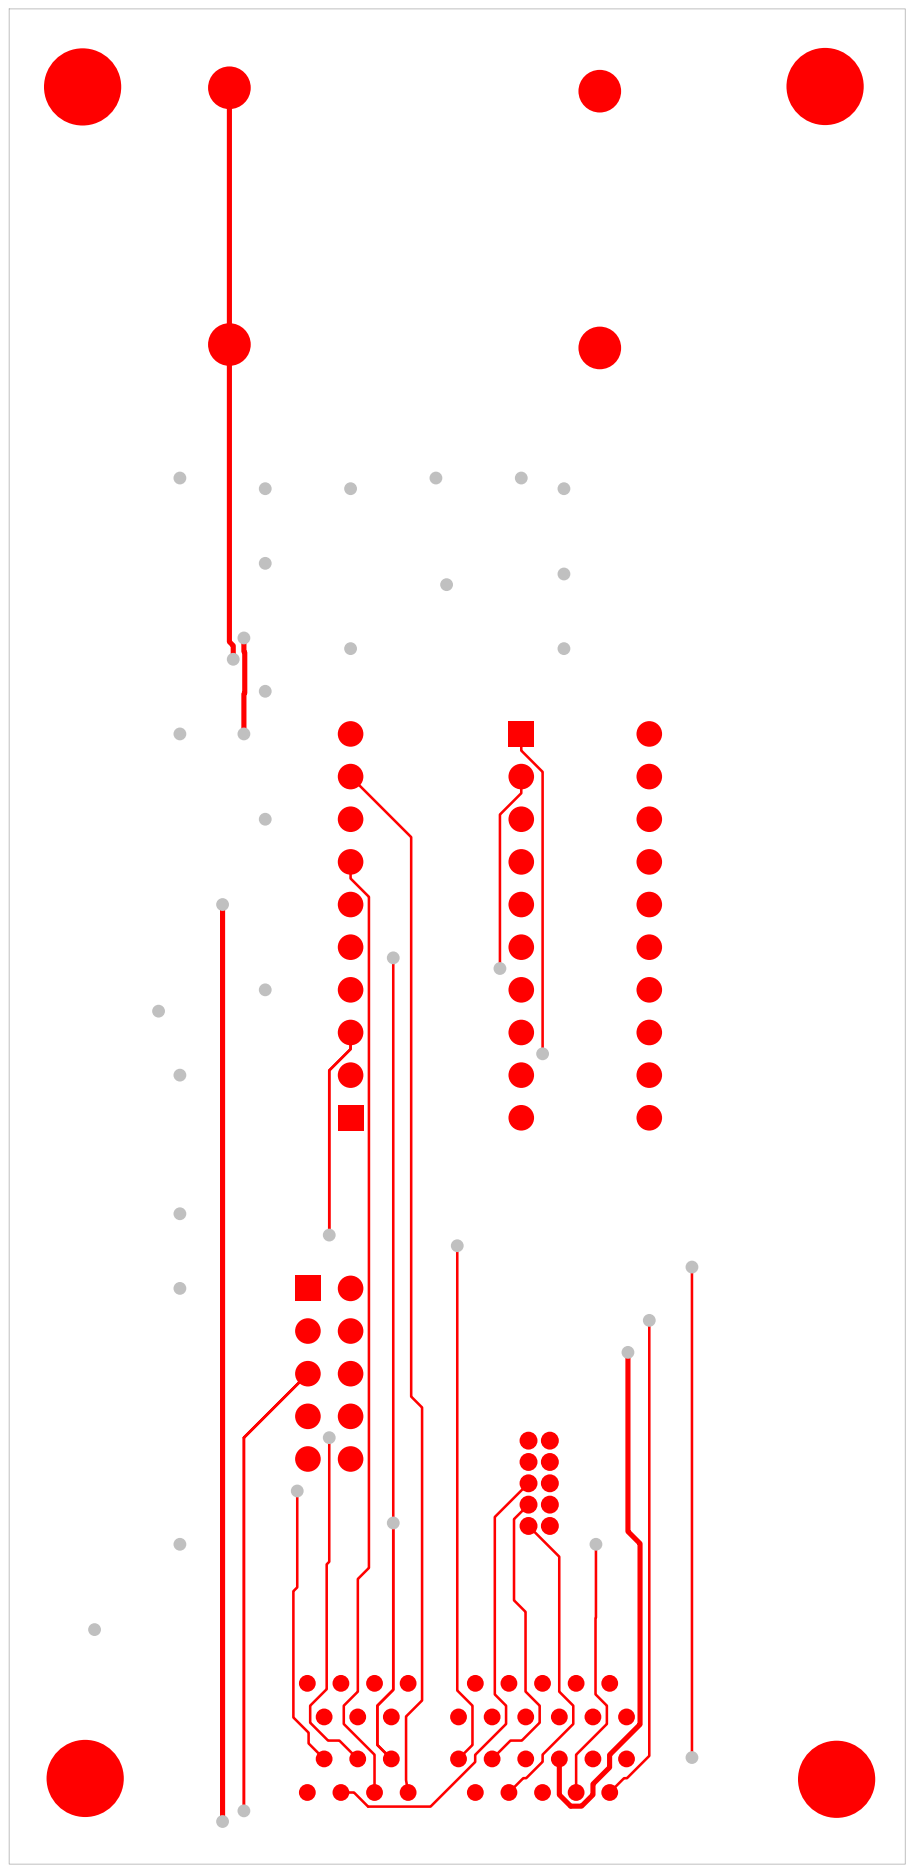
[picture p57: page 4]
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

# JTAGSAM

C5

C13

C12

C8 C9
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
# JTAGFPGA1

VIN(+5) | GNDK. Kaneshina & T. Jenrungrot

# 2006.000mil

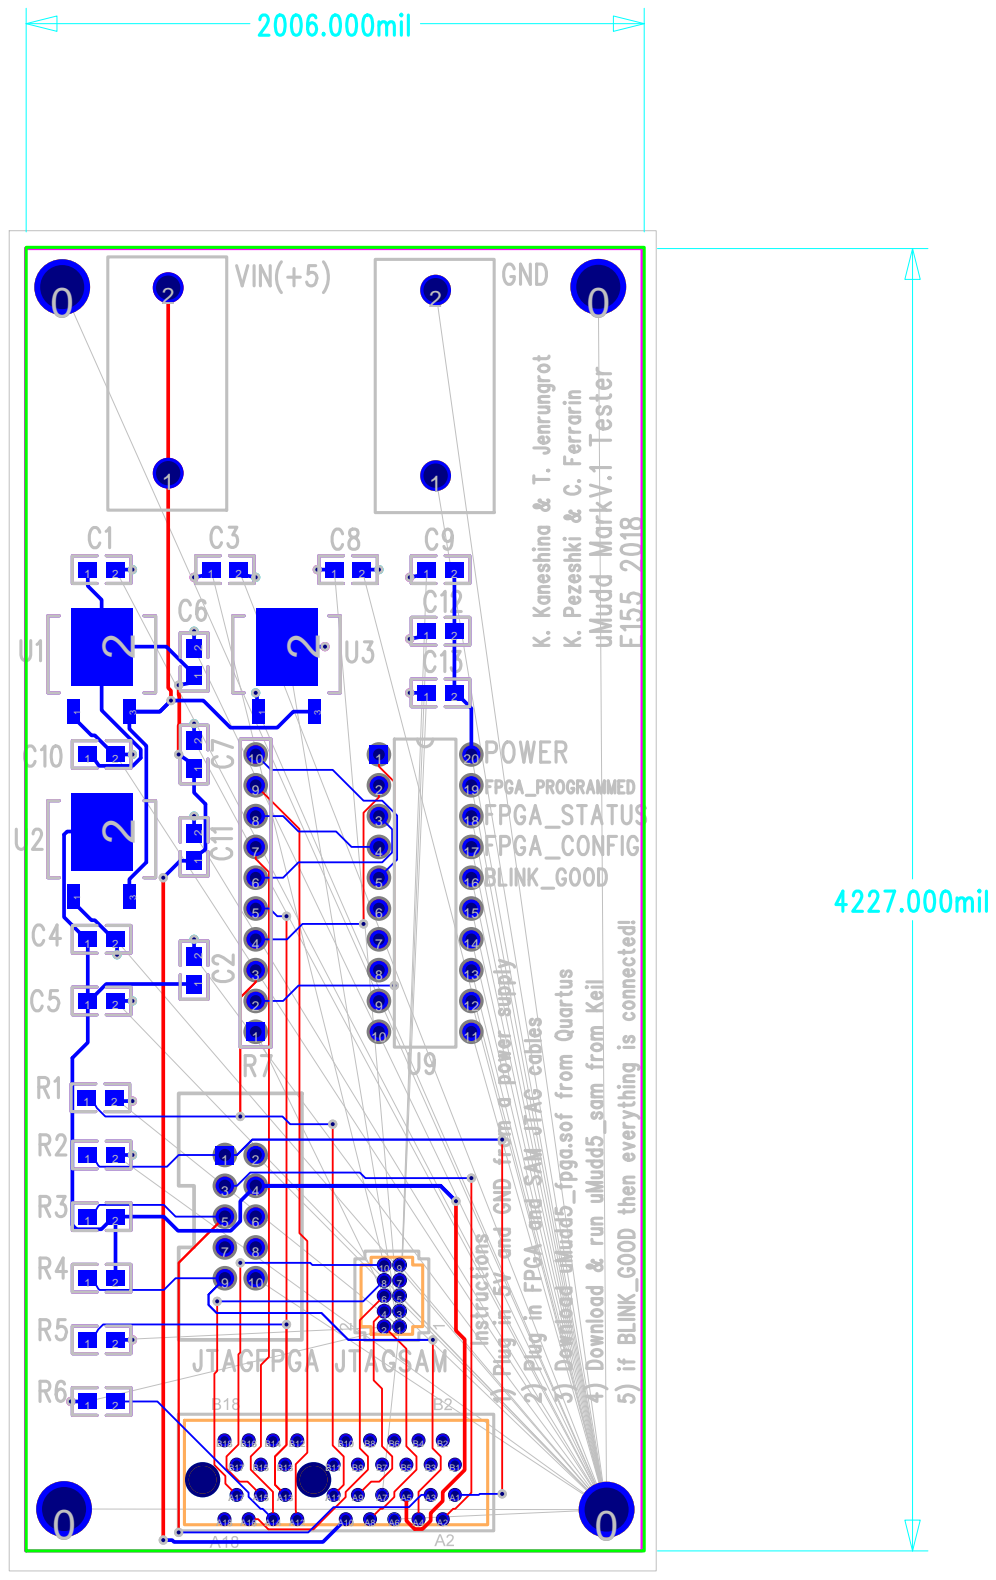
[picture p58: page 7]

R7R⁷x1 R⁷x2 R⁷x3 R⁷x4 R⁷x5 R⁷x6 R⁷x7 R⁷x8 R⁷x9 R⁷x10
POWER Instructions 1⁾ Plug in 5V and GND from a power supply 2⁾ Plug in FPGA and SAM JTAG cables 3⁾ Download uMudd5_fpga.sof from Quartus

5) if BLINK_GOOD then everything is connected!

4) Download & run uMudd5_sam from Keil
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
