kpezeshki/MuddPiV5/New PCB, no jumpers/uMuddMarkVLayout.pdf

U5U⁵x1 U⁵x2 U⁵x3 U⁵x4 | U⁵x5 U⁵x6 U⁵x7 U⁵x8 U11U¹¹x1 U¹¹x2 U¹¹x3 U¹¹x4 U¹¹x5 U¹¹x6 U¹¹x7 U¹¹x8 U¹¹x9 U¹¹x10 U¹¹x11 U¹¹x12 U¹¹x13 U¹¹x14 U¹¹x15 U¹¹x16 U¹¹x17 U¹¹x18 U¹¹x19 U¹¹x20 U¹¹x21 U¹¹x22 U¹¹x23 U¹¹x24 U¹¹x25 U¹¹x26 U¹¹x27 U¹¹x28 U¹¹x29 U¹¹x30 U¹¹x31 U¹¹x32 U¹¹x33 U¹¹x34 U¹¹x35 U¹¹x36 U¹¹x37 U¹¹x38 U¹¹x39 U¹¹x40 U¹¹x41 U¹¹x42 U¹¹x43 U¹¹x44 U¹¹x45 U¹¹x46 U¹¹x47 U¹¹x48 U¹¹x49 U¹¹x50 U¹¹x51 U¹¹x52 U¹¹x53 U¹¹x54 U¹¹x55 U¹¹x56 U¹¹x57 U¹¹x58
U8U⁸x16 | U⁸x15 | U⁸x14 | U⁸x13 | U⁸x12 | U⁸x11 | U⁸x10 | U⁸x9 | U⁸x8 | U⁸x7 | U⁸x6 | U⁸x5 | U⁸x4 | U⁸x3 | U⁸x2 | U⁸x1 U⁸x17 U⁸x18 U⁸x19 U⁸x20 U⁸x21 U⁸x22 U⁸x23 U⁸x24 U⁸x25 U⁸x26 U⁸x27 U⁸x28 U⁸x29 U⁸x30 U⁸x31 U⁸x32 | U⁸x33 | U⁸x34 | U⁸x35 | U⁸x36 | U⁸x37 | U⁸x38 | U⁸x39 | U⁸x40 | U⁸x41 | U⁸x42 | U⁸x43 | U⁸x44 | U⁸x45 | U⁸x46 | U⁸x47 | U⁸x48 | U⁸x49 U⁸x50 U⁸x51 U⁸x52 U⁸x53 U⁸x54 U⁸x55 U⁸x56 U⁸x57 U⁸x58 U⁸x59 U⁸x60 U⁸x61 U⁸x62 U⁸x63 U⁸x64 | JTAGFPGA JTAGFPGAx2 JTAGFPGAx1 JTAGFPGAx4 JTAGFPGAx3 JTAGFPGAx6 JTAGFPGAx5 JTAGFPGAx8 JTAGFPGAx7 JTAGFPGAx10 JTAGFPGAx9

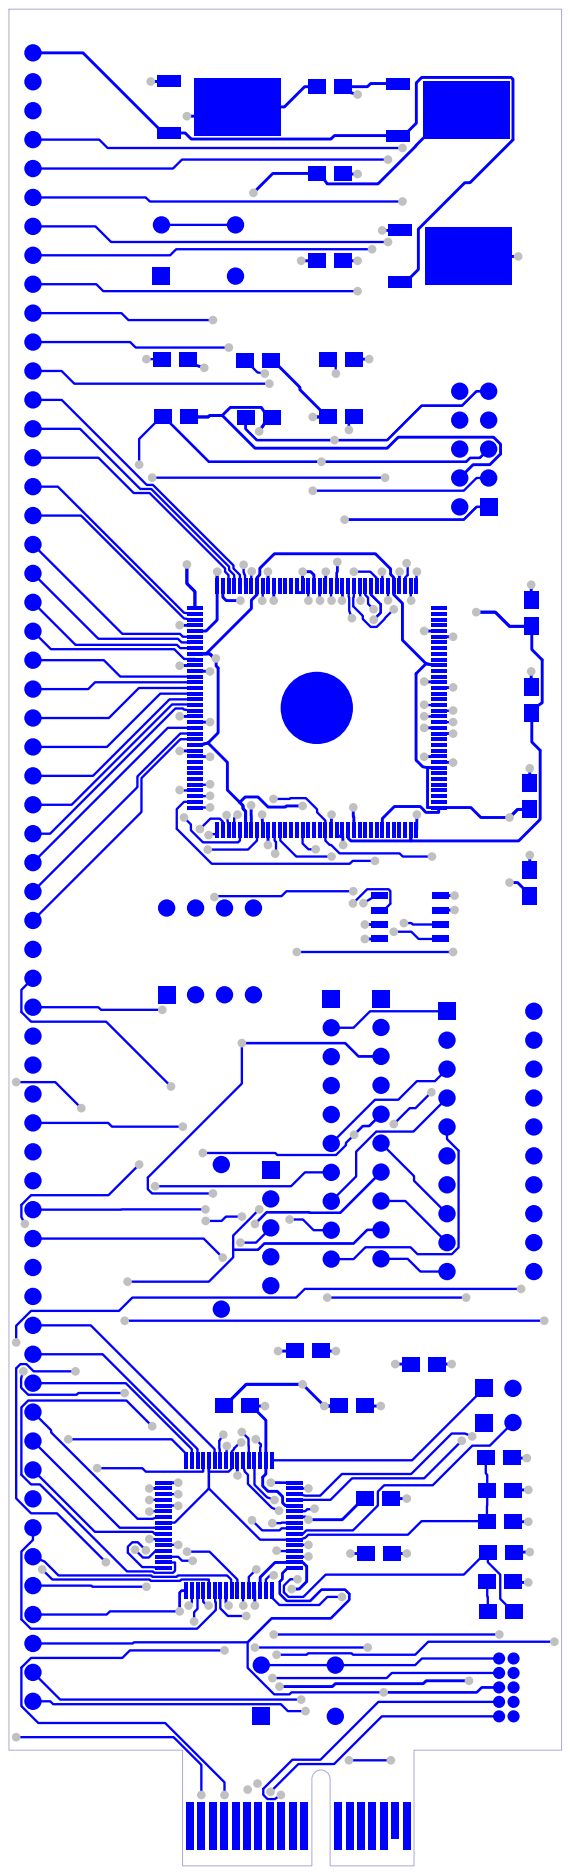
[picture p59: page 1]
U6 U⁶x36; U⁶x35; U⁶x34; U⁶x33; U⁶x32; U⁶x31; U⁶x30; U⁶x29; U⁶x28; U⁶x27; U⁶x26; U⁶x25; U⁶x24; U⁶x23; U⁶x22; U⁶x21; U⁶x20; U⁶x19; U⁶x18; U⁶x17; U⁶x16; U⁶x15; U⁶x14; U⁶x13; U⁶x12; U⁶x11; U⁶x10; U⁶x9; U⁶x8; U⁶x7; U⁶x6; U⁶x5; U⁶x4; U⁶x3; U⁶x2; U⁶x1; C1C¹x1; C¹x2; R4R⁴x1; R⁴x2; C6C⁶x1 C⁶x2; C7C⁷x1 C⁷x2; C4C⁴x1 C⁴x2; C5C⁵x1 C⁵x2; JTAGSAM JTAGSAMx2 JTAGSAMx1 JTAGSAMx4 JTAGSAMx3 JTAGSAMx6 JTAGSAMx5 JTAGSAMx8 JTAGSAMx7 JTAGSAMx10 JTAGSAMx9; R3R³x1; R³x2; U3:VCC33 U³:VCC³³x1 U³:VCC³³x3; U³:VCC³³x2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

JTAGFPGA JTAGFPGAx2 JTAGFPGAx1 JTAGFPGAx4 JTAGFPGAx3 JTAGFPGAx6 JTAGFPGAx5 JTAGFPGAx8 JTAGFPGAx7 JTAGFPGAx10 JTAGFPGAx9

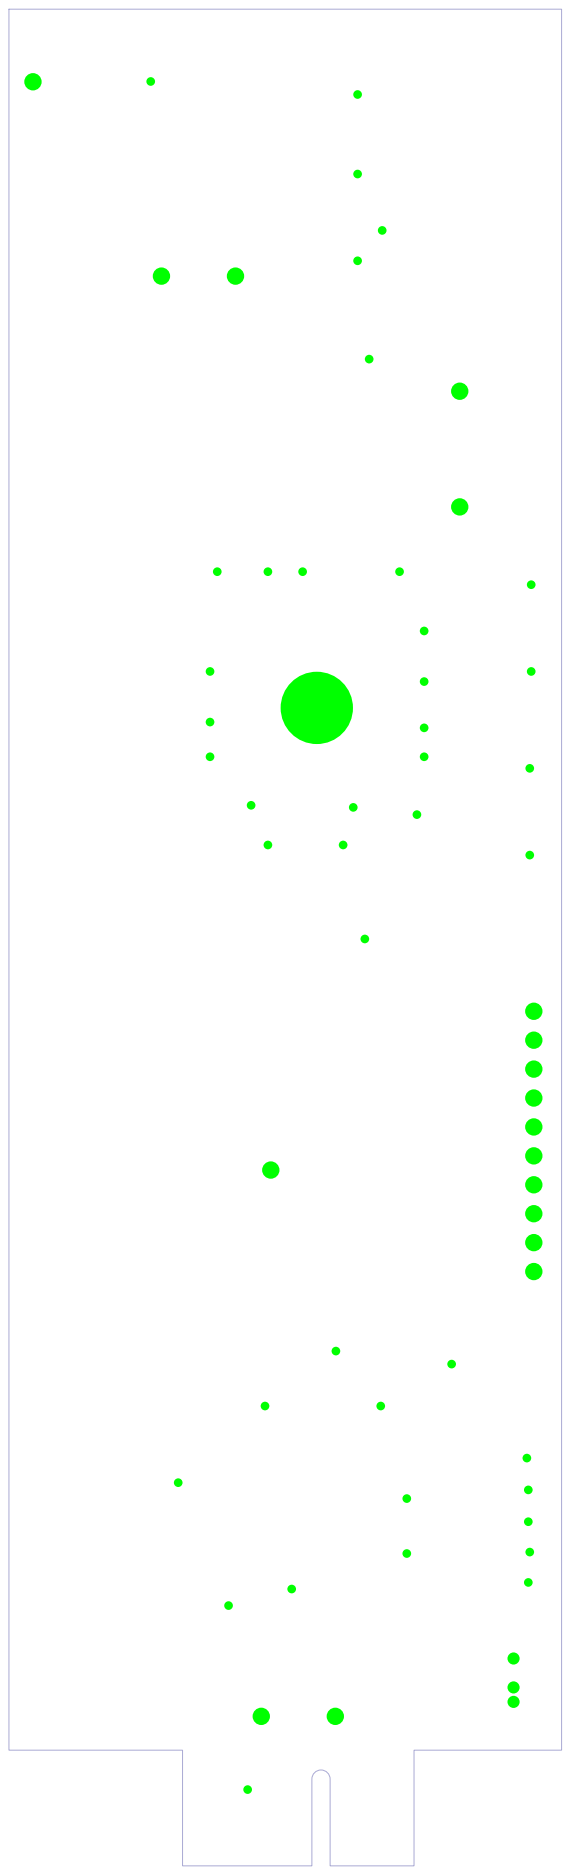
[picture p60: page 2]
U6U⁶x145; JTAGSAM JTAGSAMx2 JTAGSAMx1 JTAGSAMx4 JTAGSAMx3 JTAGSAMx6 JTAGSAMx5 JTAGSAMx8 JTAGSAMx7 JTAGSAMx10 JTAGSAMx9; U9U⁹x1 U⁹x2 U⁹x3 U⁹x4 U⁹x8 U⁹x7 U⁹x6 U⁹x5; R7R⁷x1 R⁷x2 R⁷x3 R⁷x4 R⁷x5; U10 U¹⁰x1 U¹⁰x2 U¹⁰x3 U¹⁰x4 U¹⁰x5 U¹⁰x6 U¹⁰x7 U¹⁰x8 U¹⁰x9 U¹⁰x10; U¹⁰x11 U¹⁰x12 U¹⁰x13 U¹⁰x14 U¹⁰x15 U¹⁰x16 U¹⁰x17 U¹⁰x18 U¹⁰x19 U¹⁰x20; PB1:JTAG_RESET PB¹:JTAG_RESETxA¹; PB¹:JTAG_RESETxA² PB¹:JTAG_RESETxB¹; PB¹:JTAG_RESETxB²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

JTAGFPGA JTAGFPGAx2 JTAGFPGAx1 JTAGFPGAx4 JTAGFPGAx3 JTAGFPGAx6 JTAGFPGAx5 JTAGFPGAx8 JTAGFPGAx7 JTAGFPGAx10 JTAGFPGAx9

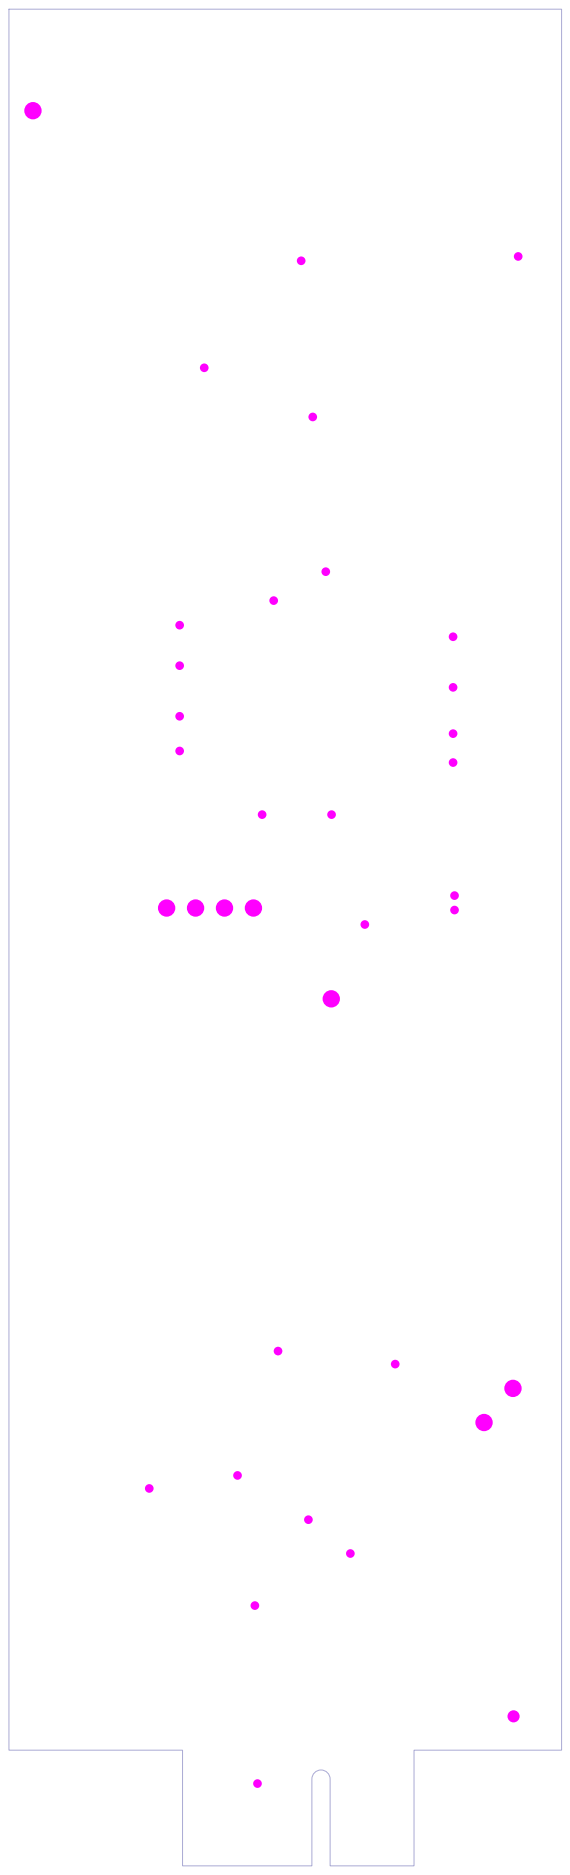
[picture p61: page 3]
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

JTAGFPGA JTAGFPGAx2 JTAGFPGAx1 JTAGFPGAx4 JTAGFPGAx3 JTAGFPGAx6 JTAGFPGAx5 JTAGFPGAx8 JTAGFPGAx7 JTAGFPGAx10 JTAGFPGAx9

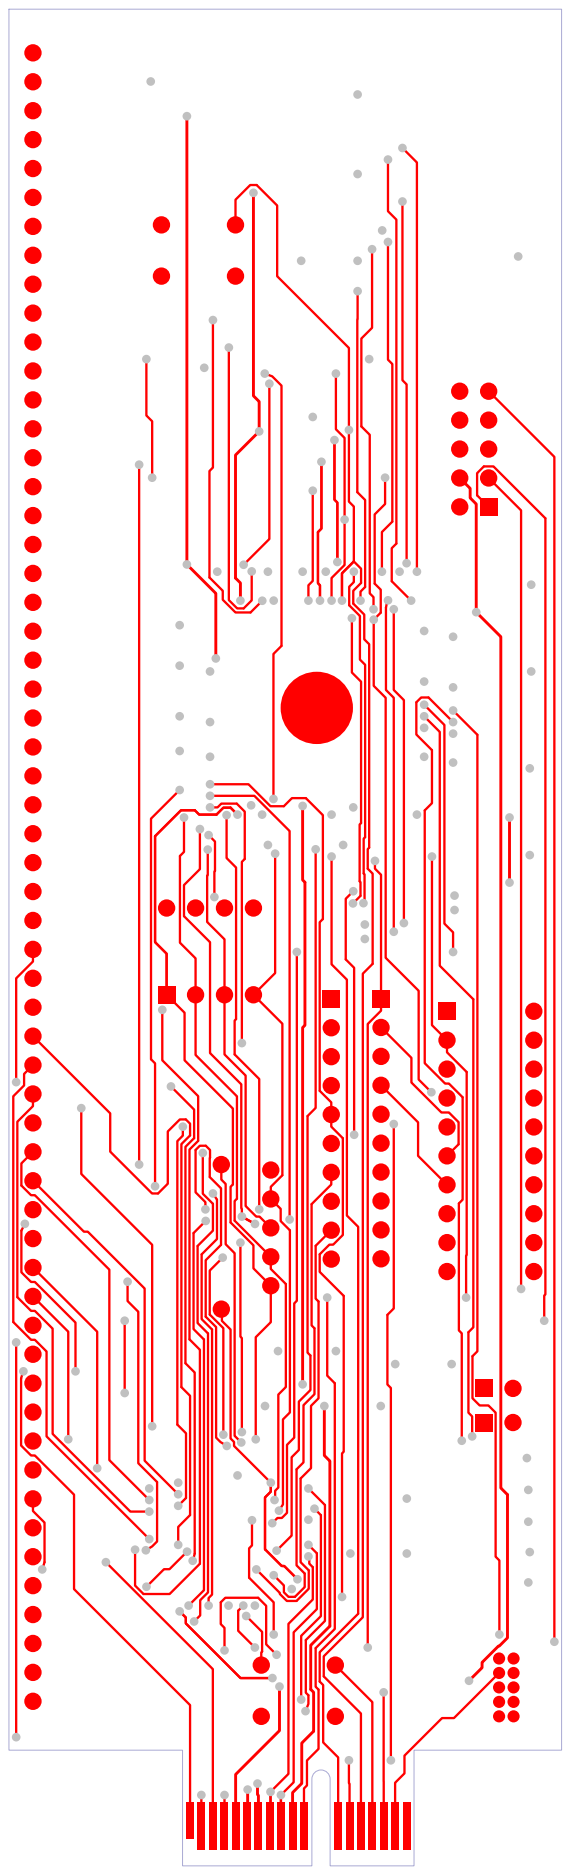
[picture p62: page 4]
U6U⁶x145; JTAGSAM JTAGSAMx2 JTAGSAMx1 JTAGSAMx4 JTAGSAMx3 JTAGSAMx6 JTAGSAMx5 JTAGSAMx8 JTAGSAMx7 JTAGSAMx10 JTAGSAMx9; U9U⁹x1 U⁹x2 U⁹x3 U⁹x4 U⁹x8 U⁹x7 U⁹x6 U⁹x5; R7R⁷x1 R⁷x2 R⁷x3 R⁷x4 R⁷x5; U10 U¹⁰x1 U¹⁰x2 U¹⁰x3 U¹⁰x4 U¹⁰x5 U¹⁰x6 U¹⁰x7 U¹⁰x8 U¹⁰x9 U¹⁰x10; U¹⁰x11 U¹⁰x12 U¹⁰x13 U¹⁰x14 U¹⁰x15 U¹⁰x16 U¹⁰x17 U¹⁰x18 U¹⁰x19 U¹⁰x20; CONNECTOR CONNECTORxA¹ CONNECTORxA² CONNECTORxA³ CONNECTORxA⁴ CONNECTORxA⁵ CONNECTORxA⁶ CONNECTORxA⁷ CONNECTORxA⁸ CONNECTORxA⁹ CONNECTORxA¹⁰ CONNECTORxA¹¹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

L1

U6

# JTAGSAM

U8

# JTAGFPGA

# ADVREF ERASE

L1

## VIN GND

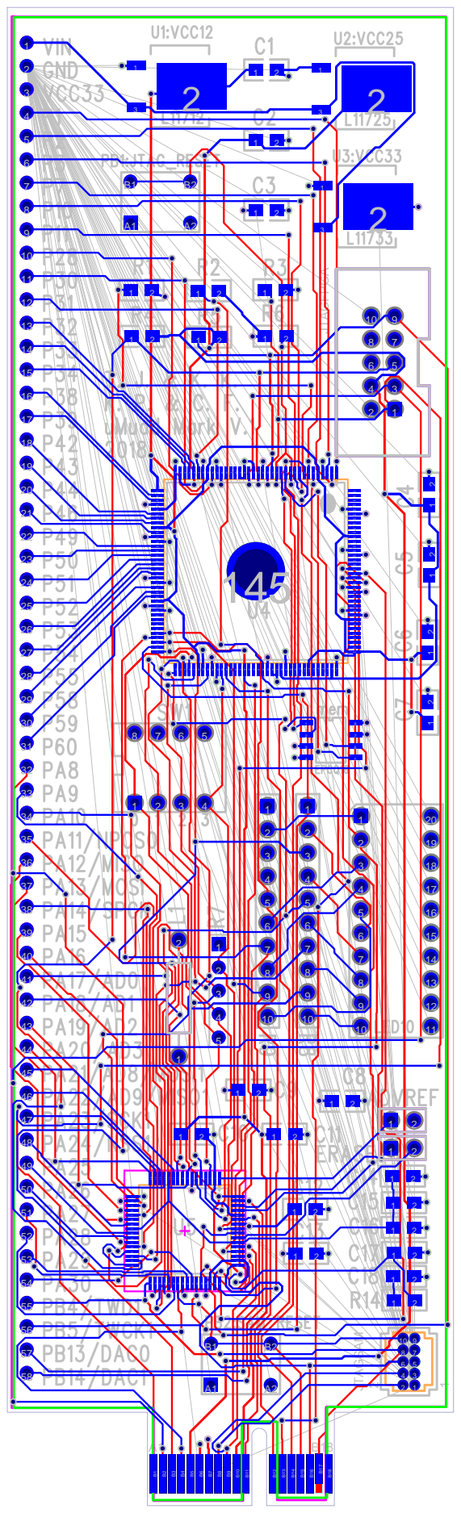
[picture p63: page 7]

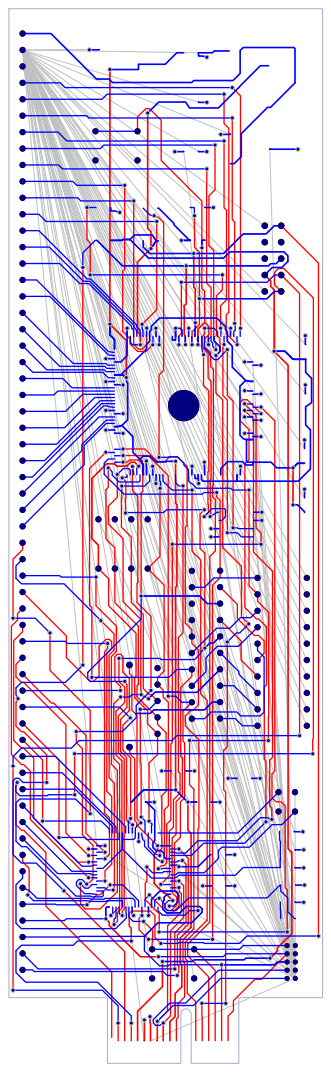
[picture p64: page 10]
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
