kpezeshki/MuddPiV5/Final Report/uMuddMarkVLayout_3.pdf

R4R⁴x1 | R⁴x2
C7C⁷x1 | C⁷x2

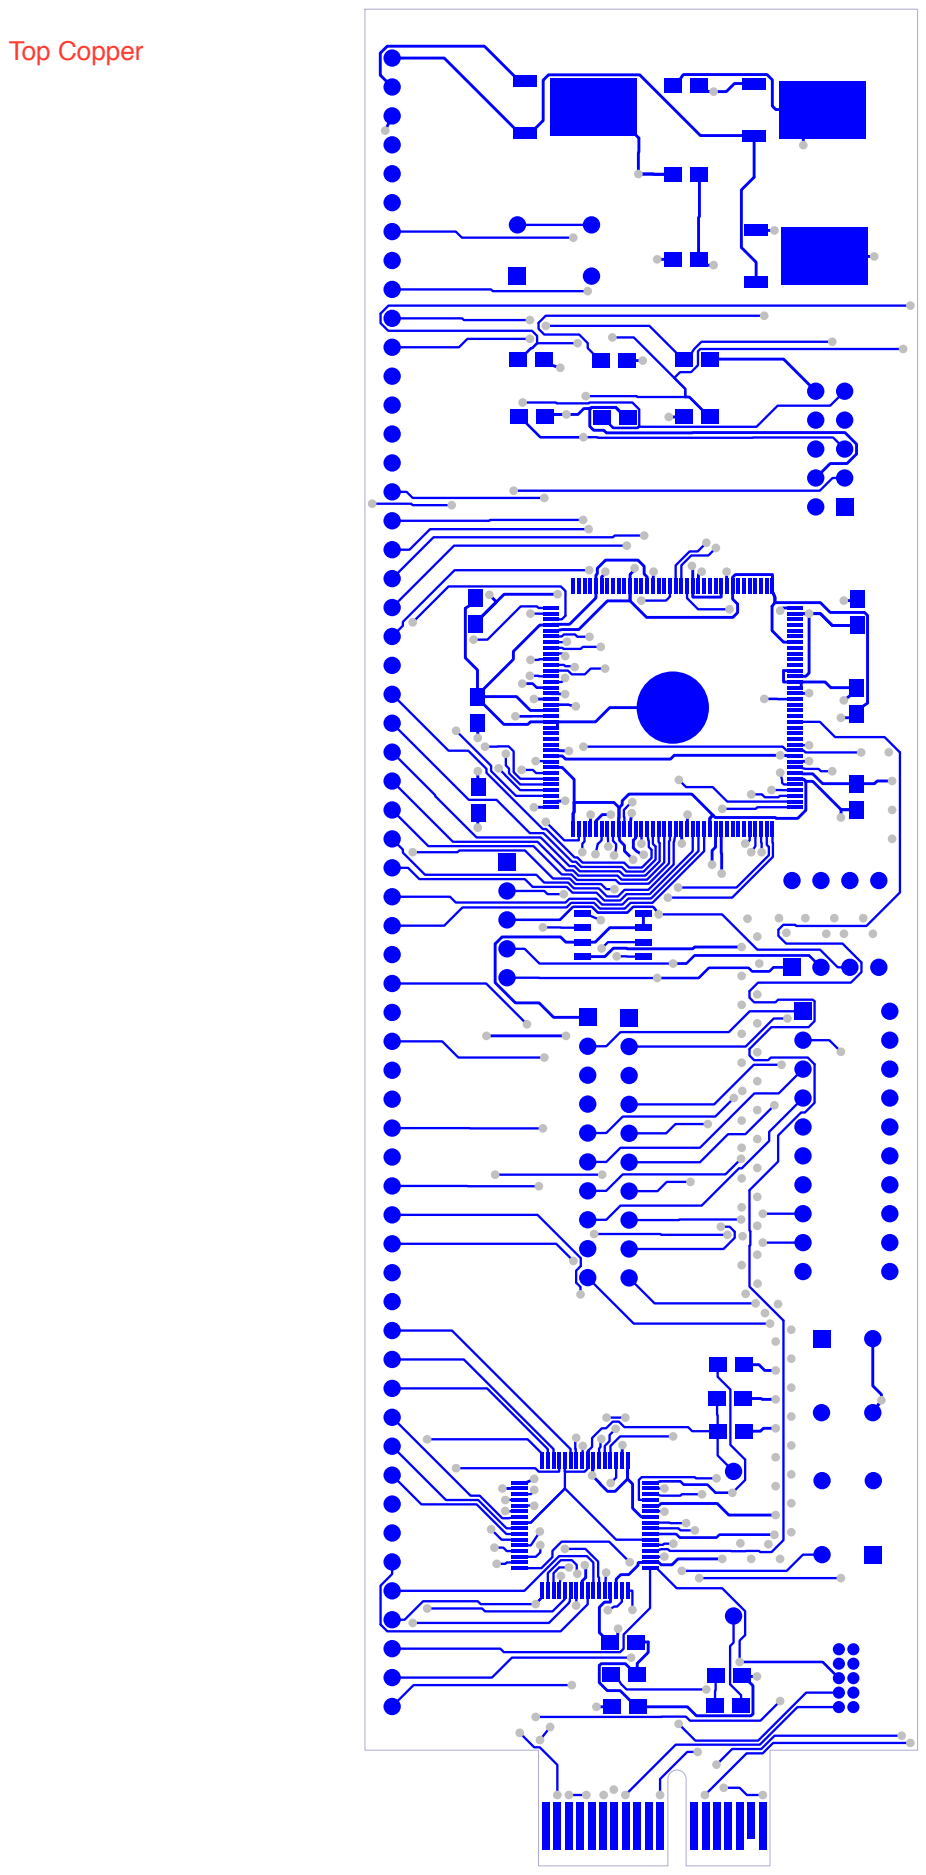
[picture p70: page 1]
U5U⁵x16; U⁵x15; U⁵x14; U⁵x13; U⁵x12; U⁵x11; U⁵x10; U⁵x9; U⁵x8; U⁵x7; U⁵x6; U⁵x5; U⁵x4; U⁵x3; U⁵x2; U⁵x1 U⁵x17 U⁵x18 U⁵x19 U⁵x20 U⁵x21 U⁵x22 U⁵x23 U⁵x24 U⁵x25 U⁵x26 U⁵x27 U⁵x28 U⁵x29 U⁵x30 U⁵x31 U⁵x32; U⁵x33; U⁵x34; U⁵x35; U⁵x36; U⁵x37; U⁵x38; U⁵x39; U⁵x40; U⁵x41; U⁵x42; U⁵x43; U⁵x44; U⁵x45; U⁵x46; U⁵x47; U⁵x48; U⁵x49 U⁵x50 U⁵x51 U⁵x52 U⁵x53 U⁵x54 U⁵x55 U⁵x56 U⁵x57 U⁵x58 U⁵x59 U⁵x60 U⁵x61 U⁵x62 U⁵x63 U⁵x64; SAM_RESETSAM_RESETxA¹ SAM_RESETxA² SAM_RESETxB¹ SAM_RESETxB²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

JTAGFPGA JTAGFPGAx2 JTAGFPGAx1 JTAGFPGAx4 JTAGFPGAx3 JTAGFPGAx6 JTAGFPGAx5 JTAGFPGAx8 JTAGFPGAx7 JTAGFPGAx10 JTAGFPGAx9

U4U⁴x145 U7U⁷x1 U⁷x2 U⁷x3 U⁷x4 U⁷x5 U⁷x6 U⁷x7 U⁷x8 U⁷x9 U⁷x10 U⁷x11 U⁷x12 U⁷x13 U⁷x14 U⁷x15 U⁷x16 U⁷x17 U⁷x18 U⁷x19 U⁷x20 U⁷x21 U⁷x22 U⁷x23 U⁷x24 U⁷x25 U⁷x26 U⁷x27 U⁷x28 U⁷x29 U⁷x30 U⁷x31 U⁷x32 U⁷x33 U⁷x34 U⁷x35 U⁷x36 U⁷x37 U⁷x38 U⁷x39 U⁷x40 U⁷x41 U⁷x42 U⁷x43 U⁷x44 U⁷x45 U⁷x46 U⁷x47 U⁷x48 U⁷x49 U⁷x50 U⁷x51 U⁷x52 U⁷x53 U⁷x54 U⁷x55 U⁷x56 U⁷x57 U⁷x58

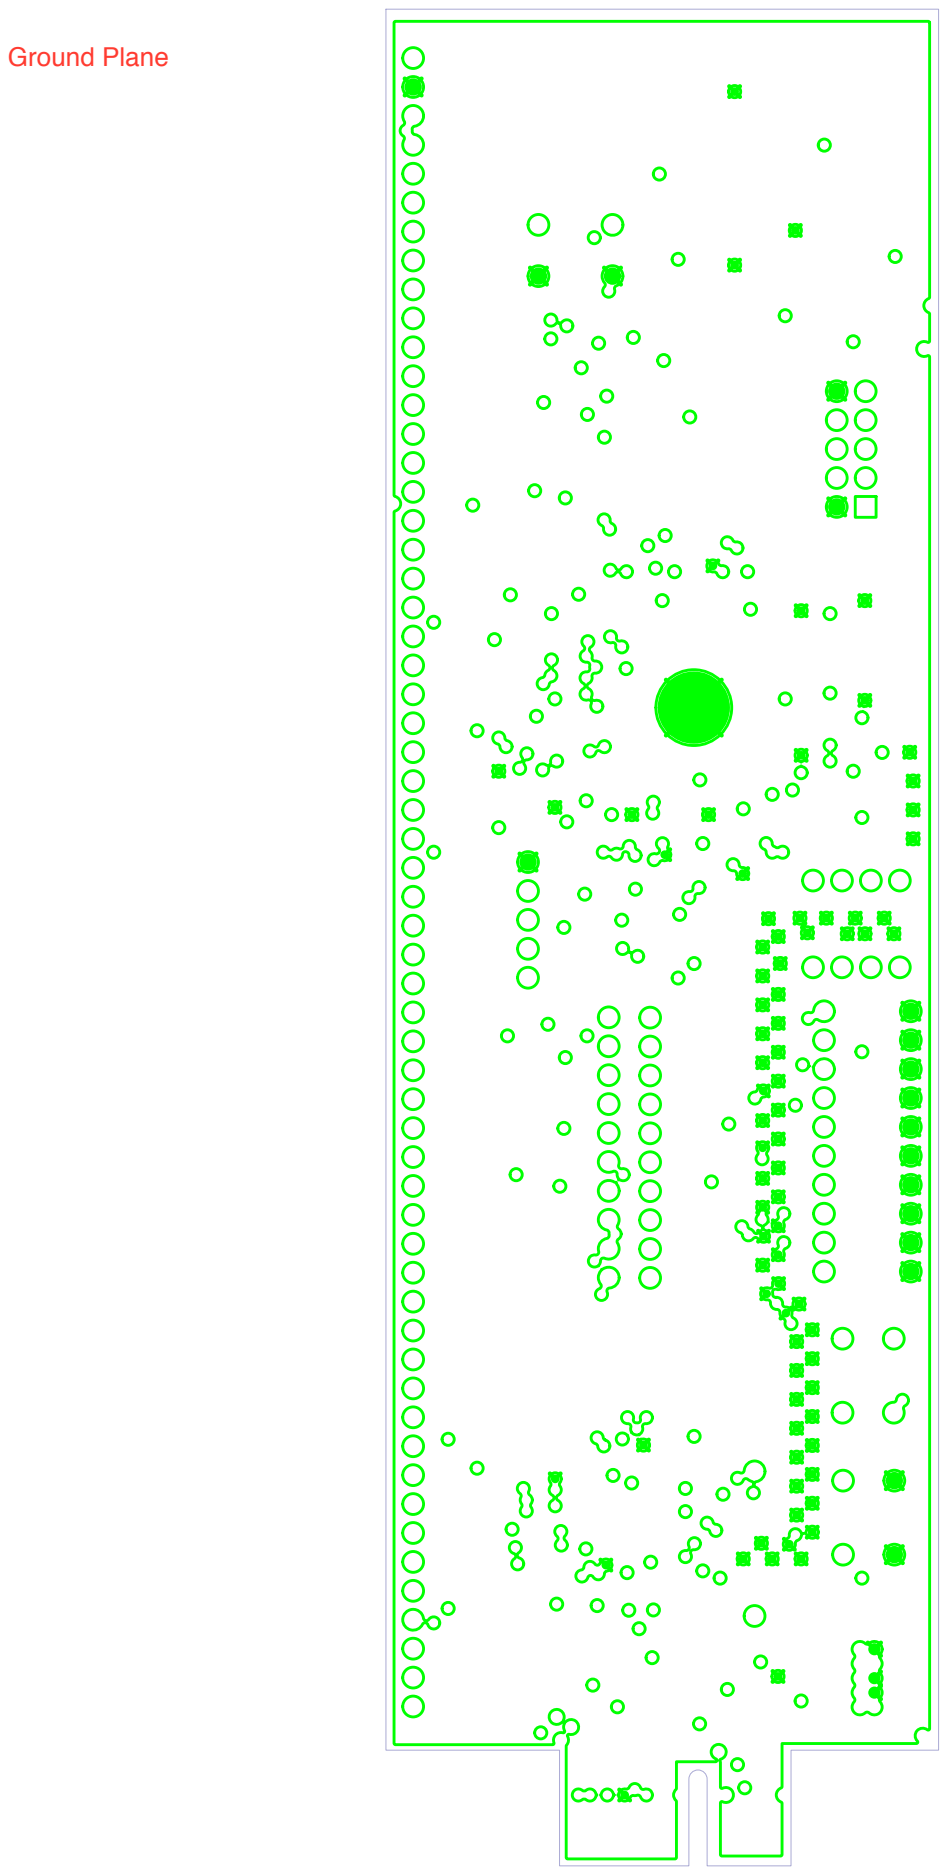
[picture p71: page 2]
SAM_RESETSAM_RESETxA¹ SAM_RESETxA² SAM_RESETxB¹ SAM_RESETxB²; SAM_ERASE SAM_ERASExA¹ SAM_ERASExA²; SAM_ERASExB¹ SAM_ERASExB²; JTAGSAM JTAGSAMx2 JTAGSAMx1 JTAGSAMx4 JTAGSAMx3 JTAGSAMx6 JTAGSAMx5 JTAGSAMx8 JTAGSAMx7 JTAGSAMx10 JTAGSAMx9; R7R⁷x1 R⁷x2 R⁷x3 R⁷x4 R⁷x5; U6U⁶x1 U⁶x2 U⁶x3 U⁶x4 U⁶x5 U⁶x6 U⁶x7 U⁶x8 U⁶x9 U⁶x10; U⁶x11 U⁶x12 U⁶x13 U⁶x14 U⁶x15 U⁶x16 U⁶x17 U⁶x18 U⁶x19 U⁶x20; JTAG_RESET JTAG_RESETxA¹; JTAG_RESETxA² JTAG_RESETxB¹; JTAG_RESETxB²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

JTAGFPGA JTAGFPGAx2 JTAGFPGAx1 JTAGFPGAx4 JTAGFPGAx3 JTAGFPGAx6 JTAGFPGAx5 JTAGFPGAx8 JTAGFPGAx7 JTAGFPGAx10 JTAGFPGAx9

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

JTAGFPGA JTAGFPGAx2 JTAGFPGAx1 JTAGFPGAx4 JTAGFPGAx3 JTAGFPGAx6 JTAGFPGAx5 JTAGFPGAx8 JTAGFPGAx7 JTAGFPGAx10 JTAGFPGAx9

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

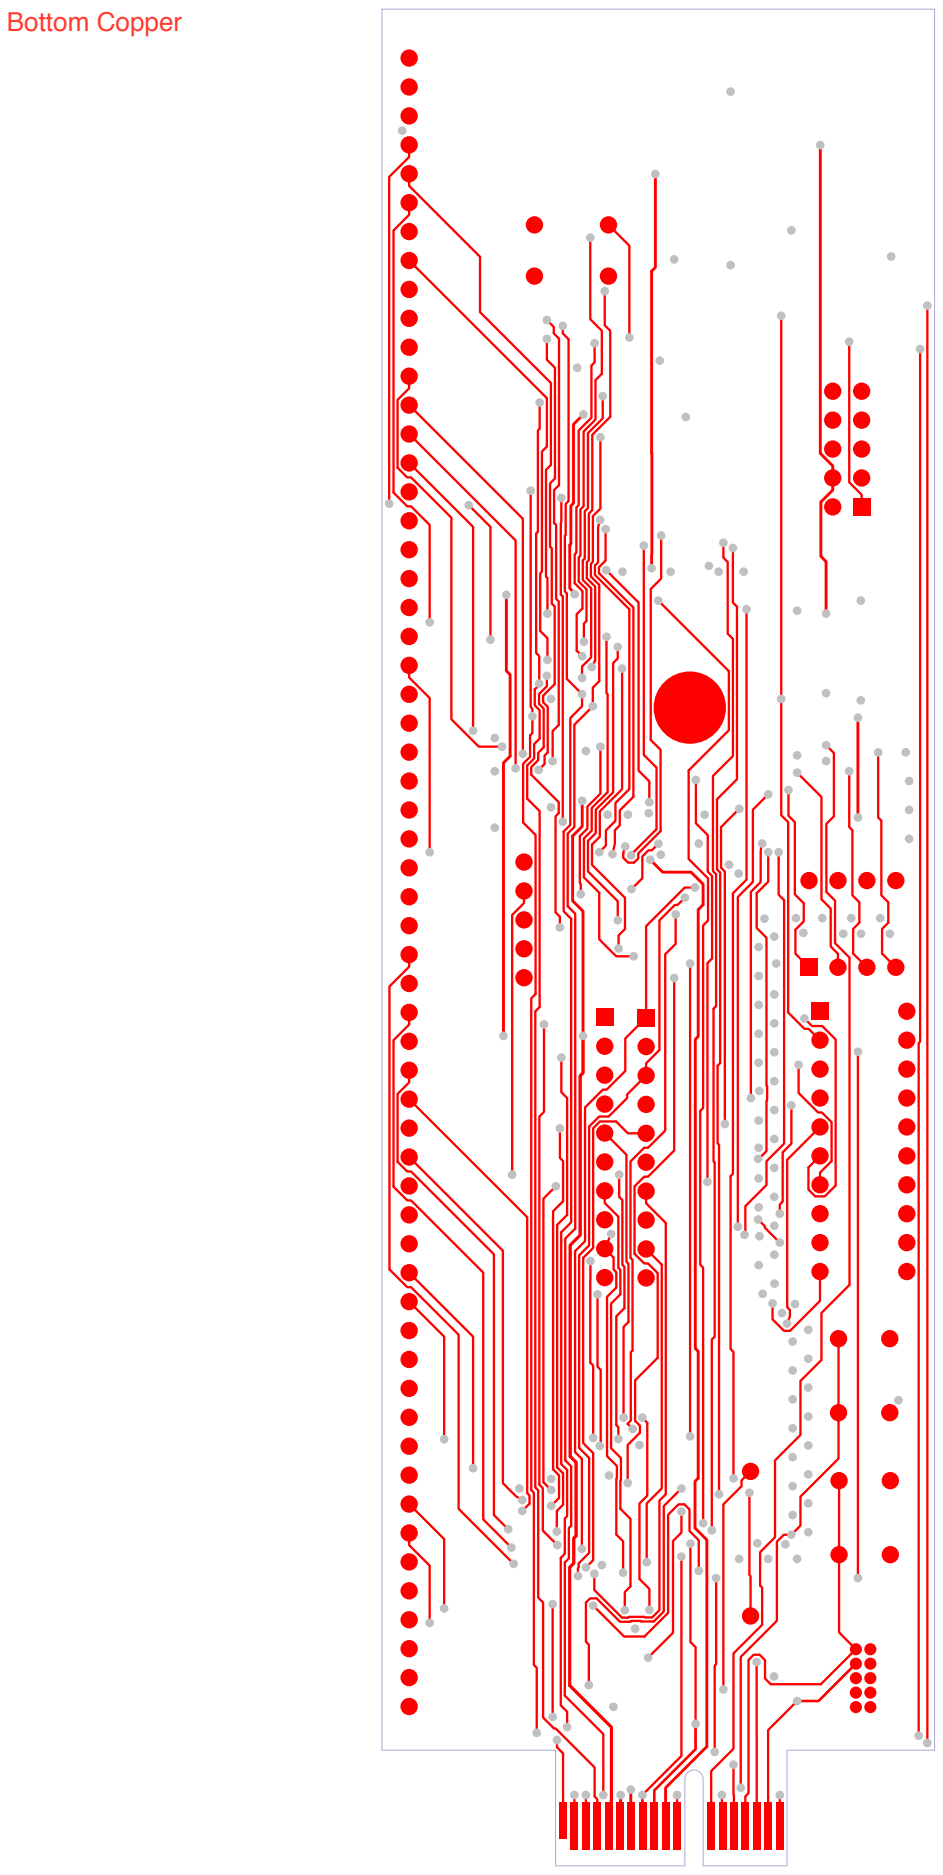
[picture p72: page 4]
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

EPCQ16SI8N; JTAGSAM; JTAGFPGA

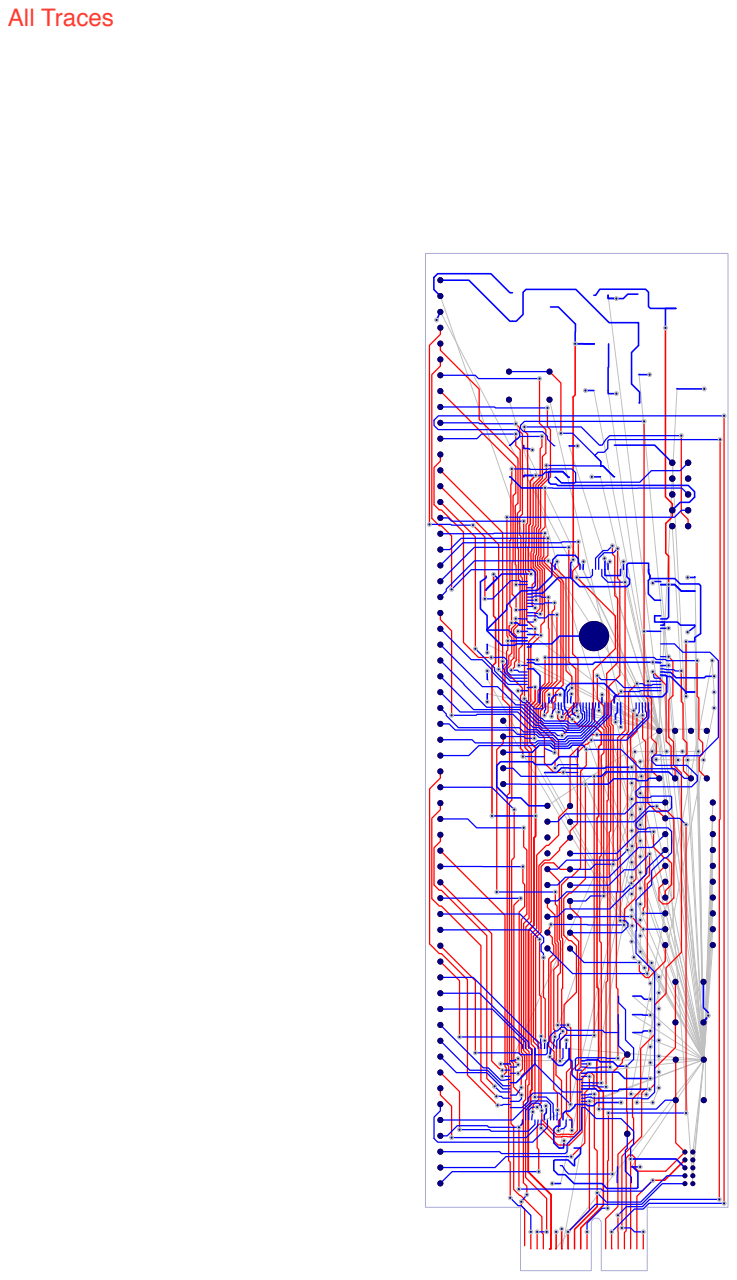
[picture p73: page 9]
