kpezeshki/MuddPiV5/Final Report/uMuddMarkVLogic.pdf

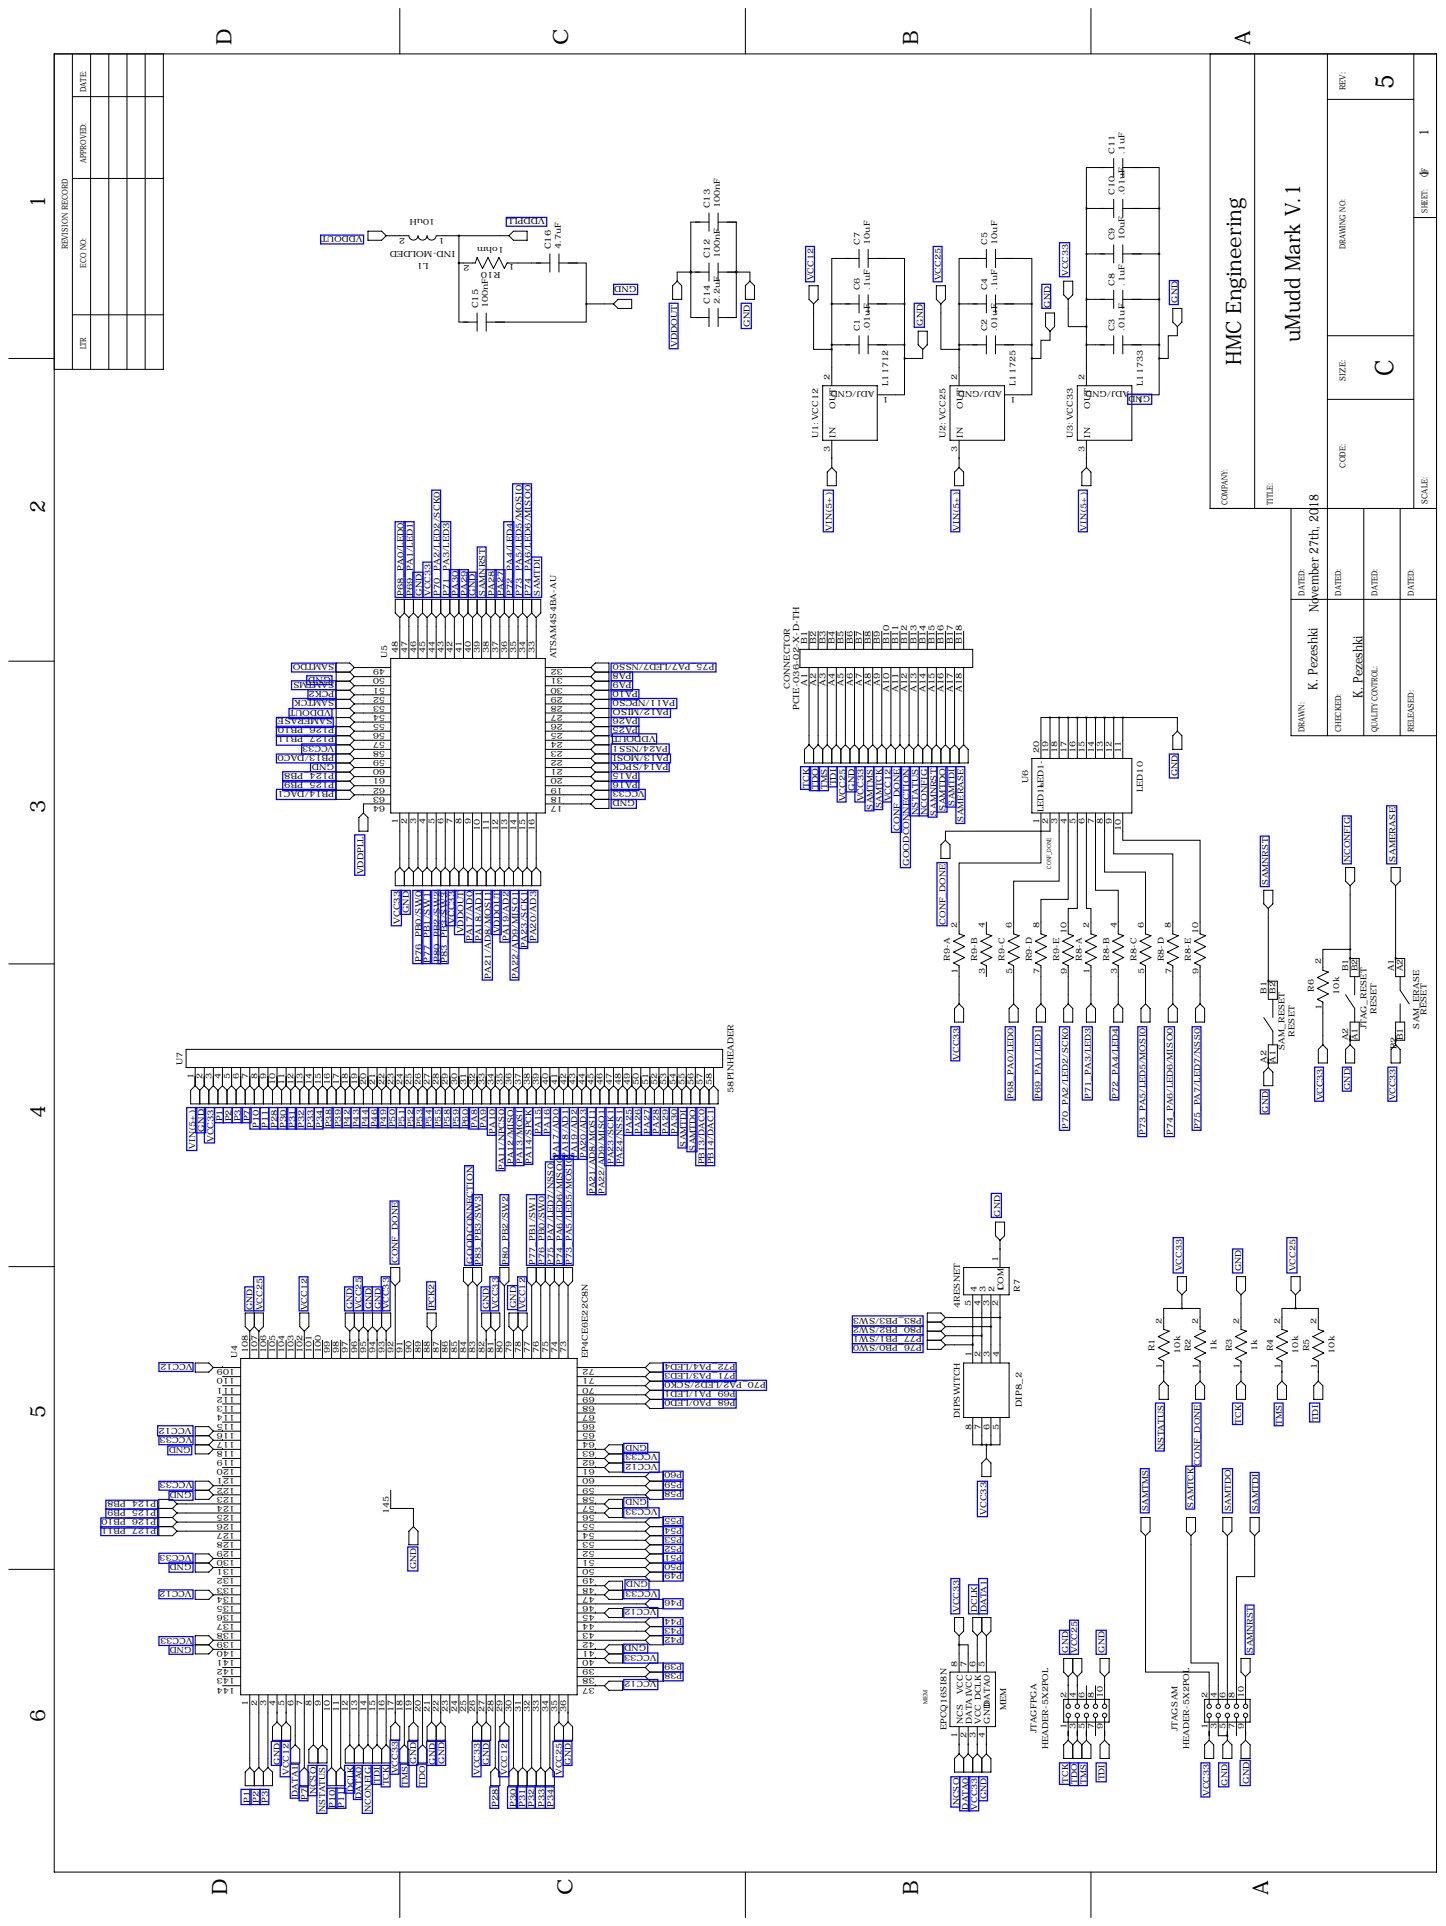
[picture p74: page 1]

APPROVED: ECO NO: LTR DATE:
