kpezeshki/MuddPiV5/Final Report/uMuddMarkVLogic_letter.pdf

APPROVED: ECO NO: LTR DATE:
