kpezeshki/MuddPiV5/brokennet.pdf

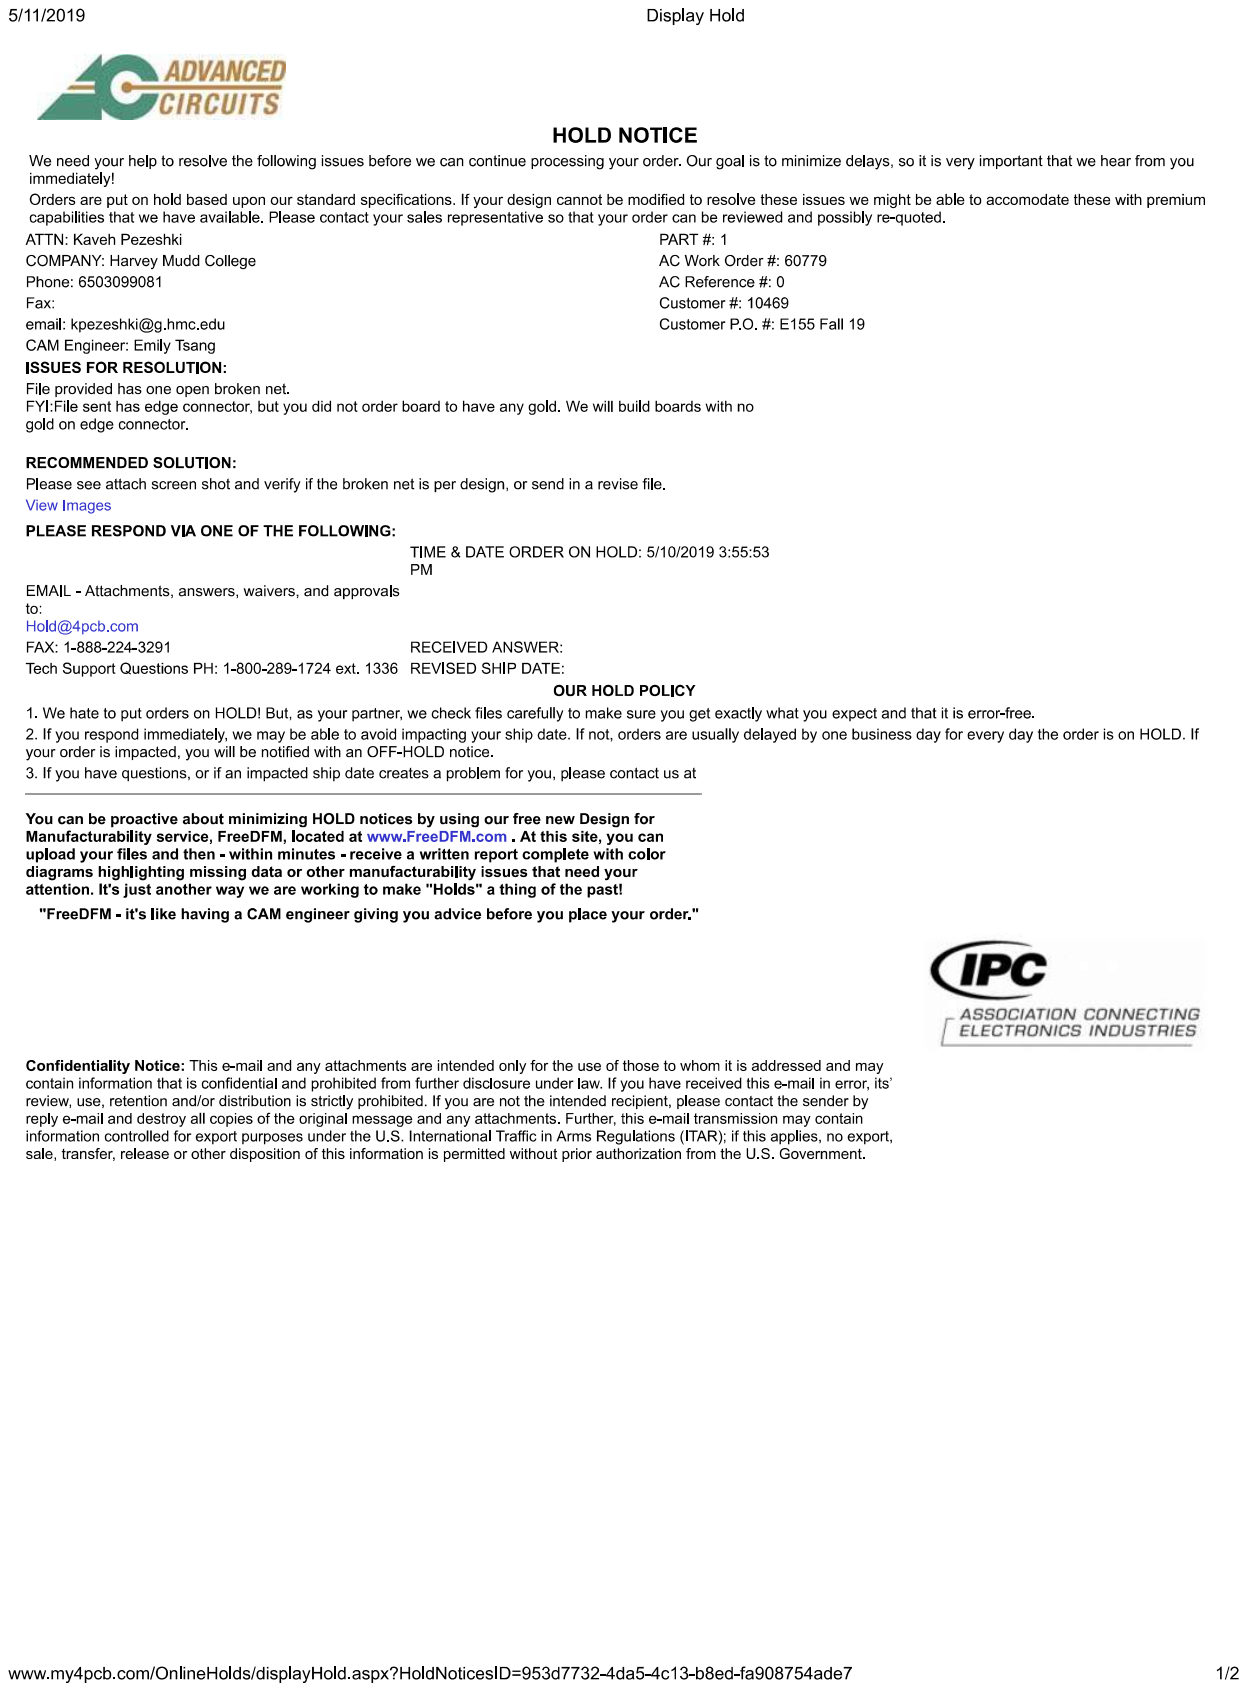
[picture p75: page 1]

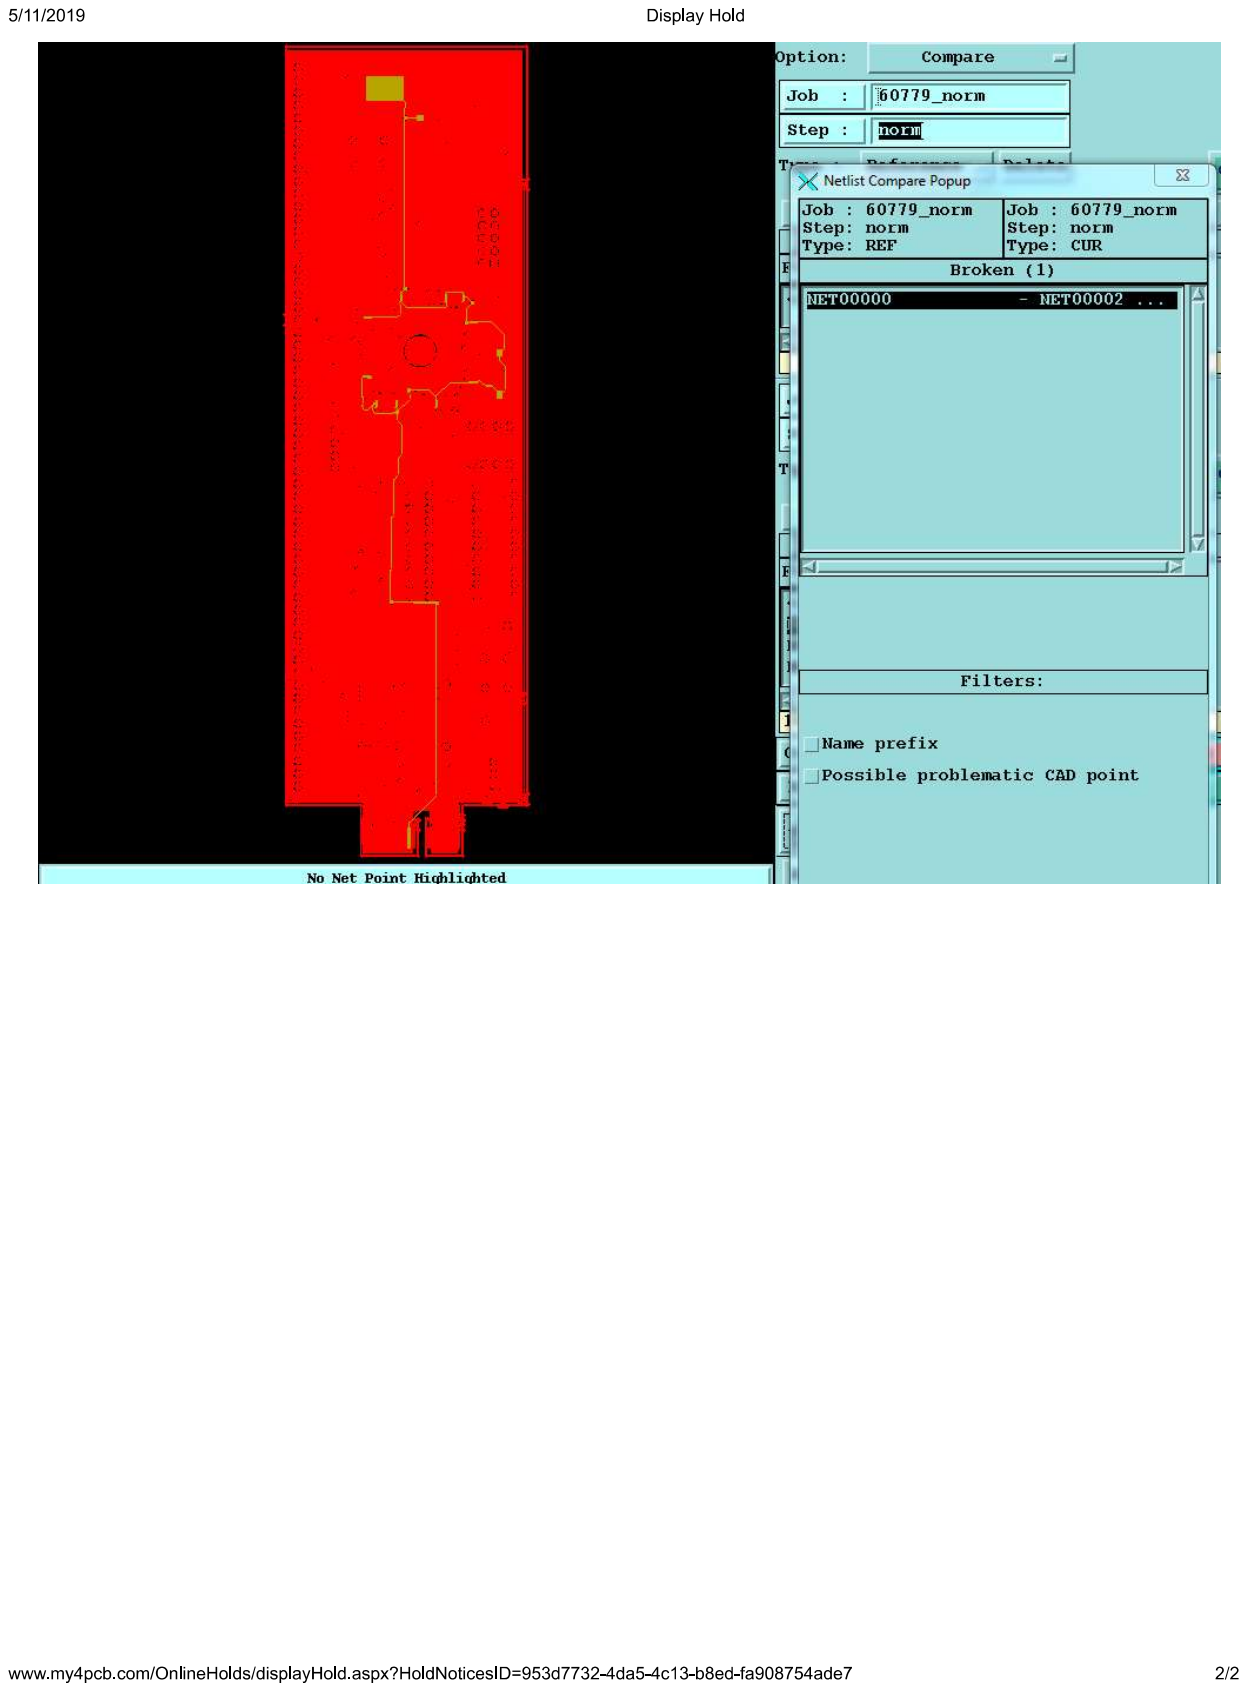
[picture p76: page 2]
