kpezeshki/MuddPiV5/New PCB, no jumpers/uMuddMarkVLayout_3_oscillator_blz.pdf

R4R⁴x1 | R⁴x2
R1R¹x1 | R¹x2

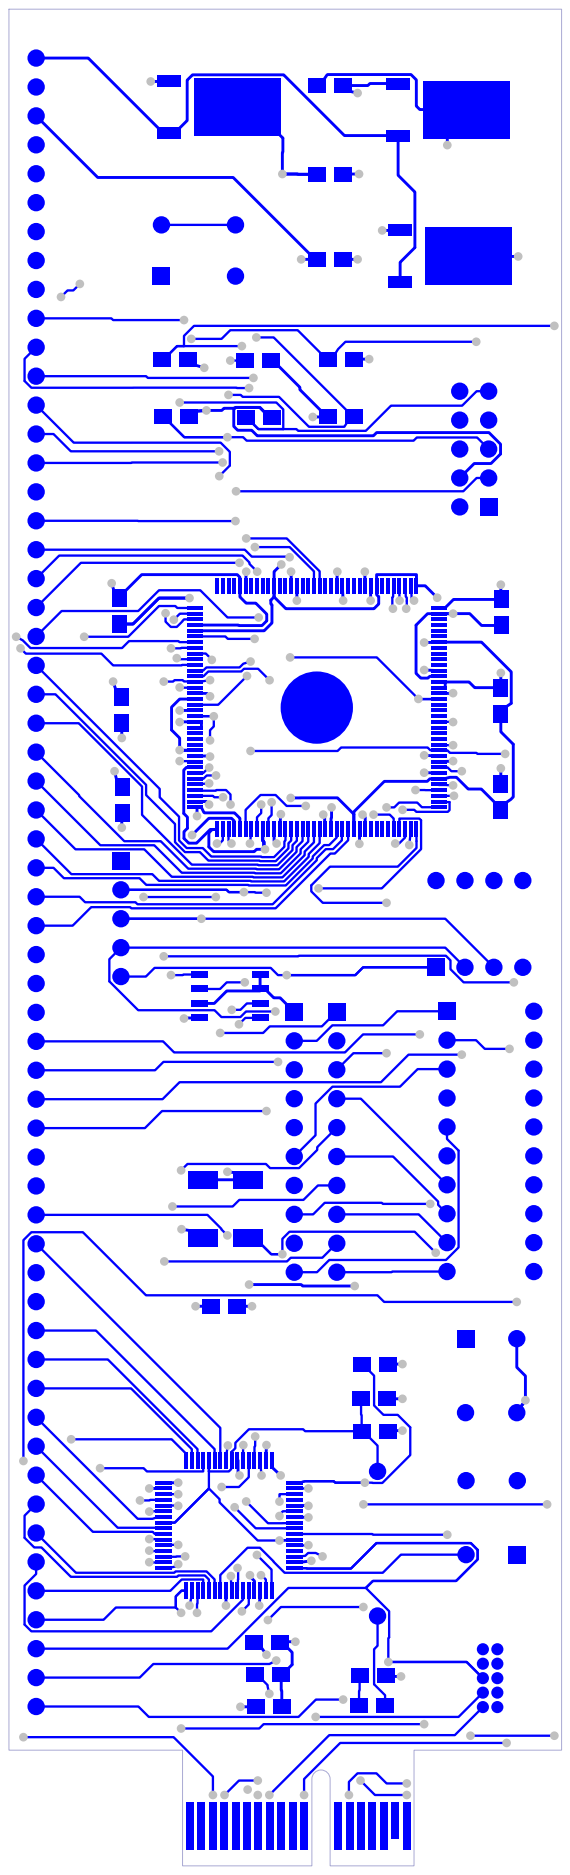
[picture p77: page 1]
C4C⁴x1 C⁴x2; U6U⁶x1 U⁶x2 U⁶x3 U⁶x4 U⁶x5 U⁶x6 U⁶x7 U⁶x8 U⁶x9 U⁶x10; U⁶x11 U⁶x12 U⁶x13 U⁶x14 U⁶x15 U⁶x16 U⁶x17 U⁶x18 U⁶x19 U⁶x20; DIPSWITCH DIPSWITCHx1 DIPSWITCHx2 DIPSWITCHx3 DIPSWITCHx4 DIPSWITCHx8 DIPSWITCHx7 DIPSWITCHx6 DIPSWITCHx5; R10R¹⁰x1; R¹⁰x2; EPCQ16SI8N EPCQ¹⁶SI8Nx1 EPCQ¹⁶SI8Nx2 EPCQ¹⁶SI8Nx3 EPCQ¹⁶SI8Nx4; EPCQ¹⁶SI8Nx5 EPCQ¹⁶SI8Nx6 EPCQ¹⁶SI8Nx7 EPCQ¹⁶SI8Nx8 Y1Y¹x1 Y¹x2; Y¹x3 Y¹x4; C18C¹⁸x1; C¹⁸x2; U5U⁵x16; U⁵x15; U⁵x14; U⁵x13; U⁵x12; U⁵x11; U⁵x10; U⁵x9; U⁵x8; U⁵x7; U⁵x6; U⁵x5; U⁵x4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

JTAGFPGA JTAGFPGAx2 JTAGFPGAx1 JTAGFPGAx4 JTAGFPGAx3 JTAGFPGAx6 JTAGFPGAx5 JTAGFPGAx8 JTAGFPGAx7 JTAGFPGAx10 JTAGFPGAx9

U4U⁴x145 U7U⁷x1 U⁷x2 U⁷x3 U⁷x4 U⁷x5 U⁷x6 U⁷x7 U⁷x8 U⁷x9 U⁷x10 U⁷x11 U⁷x12 U⁷x13 U⁷x14 U⁷x15 U⁷x16 U⁷x17 U⁷x18 U⁷x19 U⁷x20 U⁷x21 U⁷x22 U⁷x23 U⁷x24 U⁷x25 U⁷x26 U⁷x27 U⁷x28 U⁷x29 U⁷x30 U⁷x31 U⁷x32 U⁷x33 U⁷x34 U⁷x35 U⁷x36 U⁷x37 U⁷x38 U⁷x39 U⁷x40 U⁷x41 U⁷x42 U⁷x43 U⁷x44 U⁷x45 U⁷x46 U⁷x47 U⁷x48 U⁷x49 U⁷x50 U⁷x51 U⁷x52 U⁷x53 U⁷x54 U⁷x55 U⁷x56 U⁷x57 U⁷x58

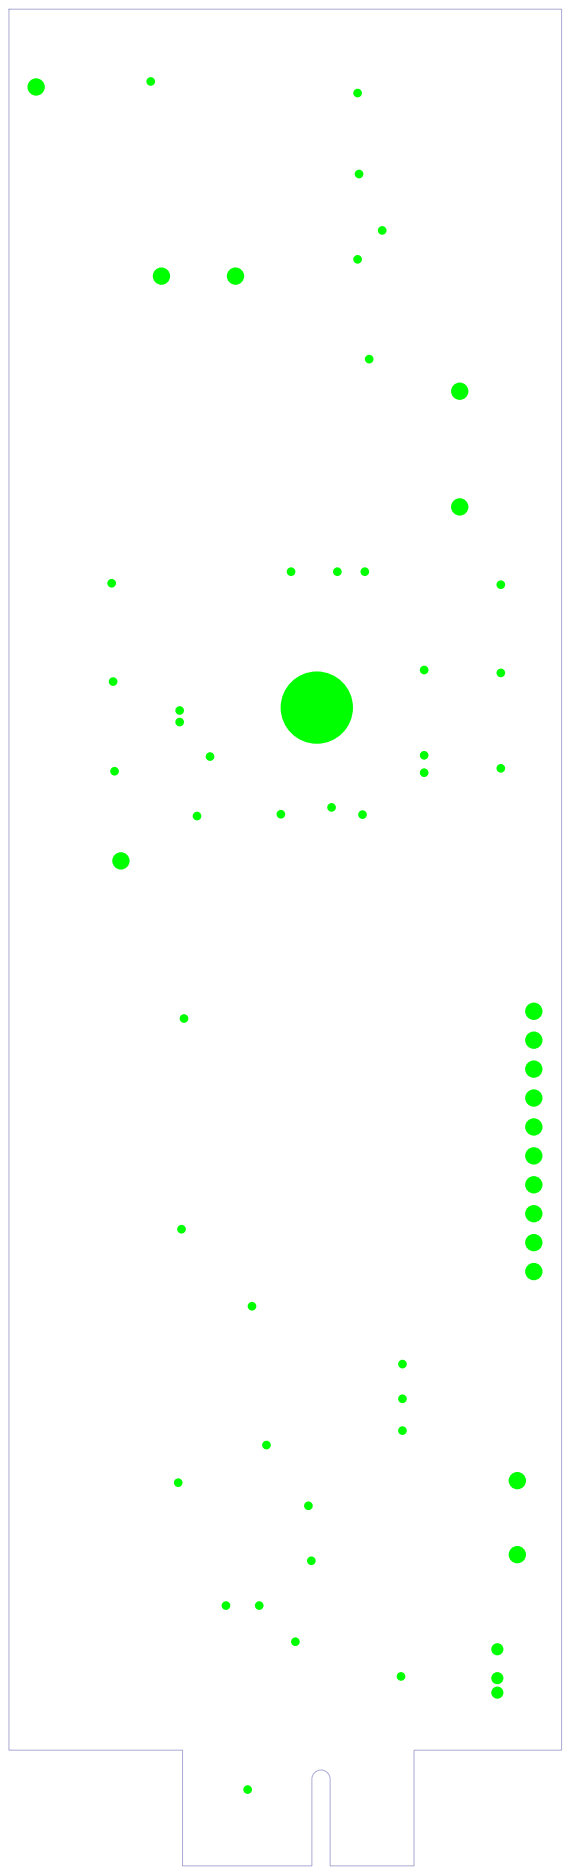
[picture p78: page 2]
U6U⁶x1 U⁶x2 U⁶x3 U⁶x4 U⁶x5 U⁶x6 U⁶x7 U⁶x8 U⁶x9 U⁶x10; U⁶x11 U⁶x12 U⁶x13 U⁶x14 U⁶x15 U⁶x16 U⁶x17 U⁶x18 U⁶x19 U⁶x20; DIPSWITCH DIPSWITCHx1 DIPSWITCHx2 DIPSWITCHx3 DIPSWITCHx4 DIPSWITCHx8 DIPSWITCHx7 DIPSWITCHx6 DIPSWITCHx5; JTAG_RESET JTAG_RESETxA¹; JTAG_RESETxA² JTAG_RESETxB¹; JTAG_RESETxB²; R7R⁷x1 R⁷x2 R⁷x3 R⁷x4 R⁷x5; R9R⁹x1 R⁹x2 R⁹x3 R⁹x4 R⁹x5 R⁹x6 R⁹x7 R⁹x8 R⁹x9 R⁹x10; R8R⁸x1 R⁸x2 R⁸x3 R⁸x4 R⁸x5 R⁸x6 R⁸x7 R⁸x8 R⁸x9 R⁸x10; SAM_ERASE SAM_ERASExA¹ SAM_ERASExA²; SAM_ERASExB¹ SAM_ERASExB²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

JTAGFPGA JTAGFPGAx2 JTAGFPGAx1 JTAGFPGAx4 JTAGFPGAx3 JTAGFPGAx6 JTAGFPGAx5 JTAGFPGAx8 JTAGFPGAx7 JTAGFPGAx10 JTAGFPGAx9

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

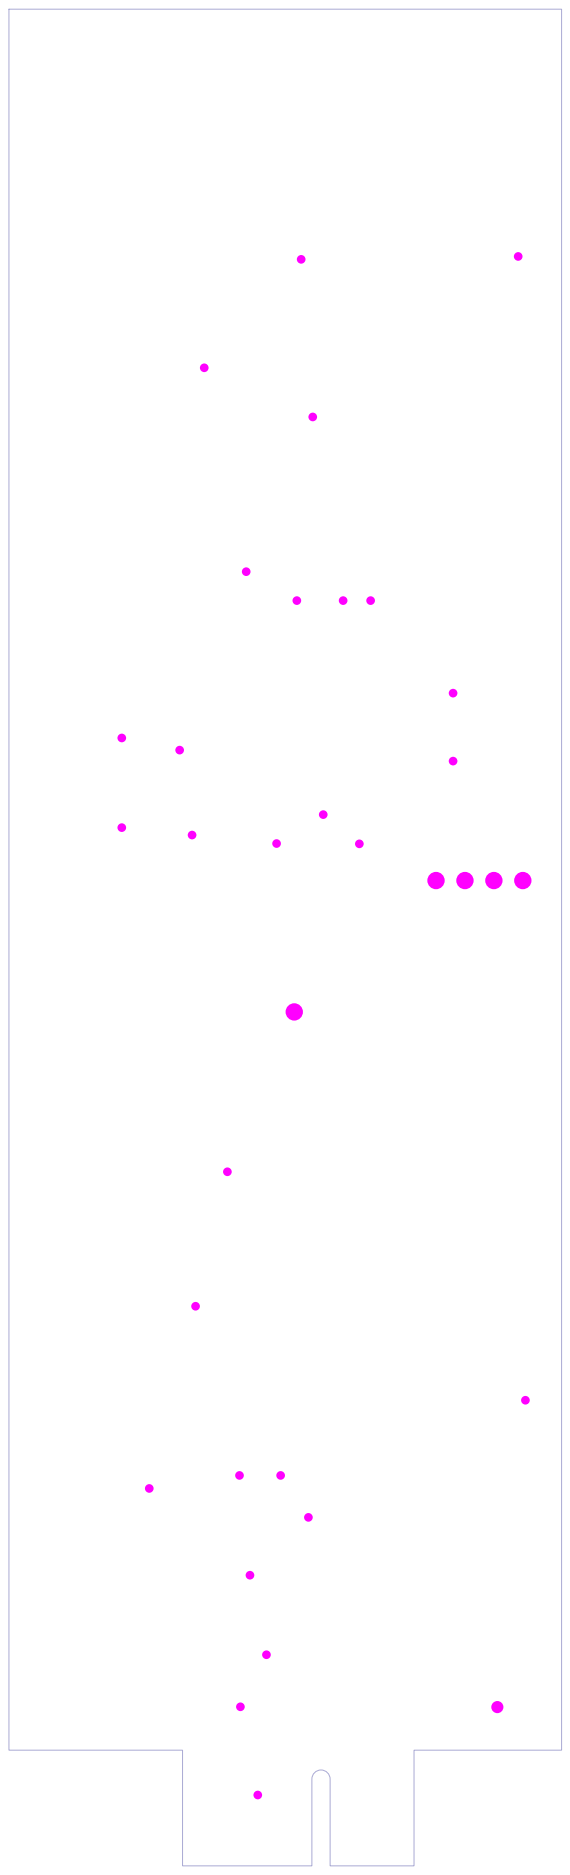
[picture p79: page 3]
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

JTAGFPGA JTAGFPGAx2 JTAGFPGAx1 JTAGFPGAx4 JTAGFPGAx3 JTAGFPGAx6 JTAGFPGAx5 JTAGFPGAx8 JTAGFPGAx7 JTAGFPGAx10 JTAGFPGAx9

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

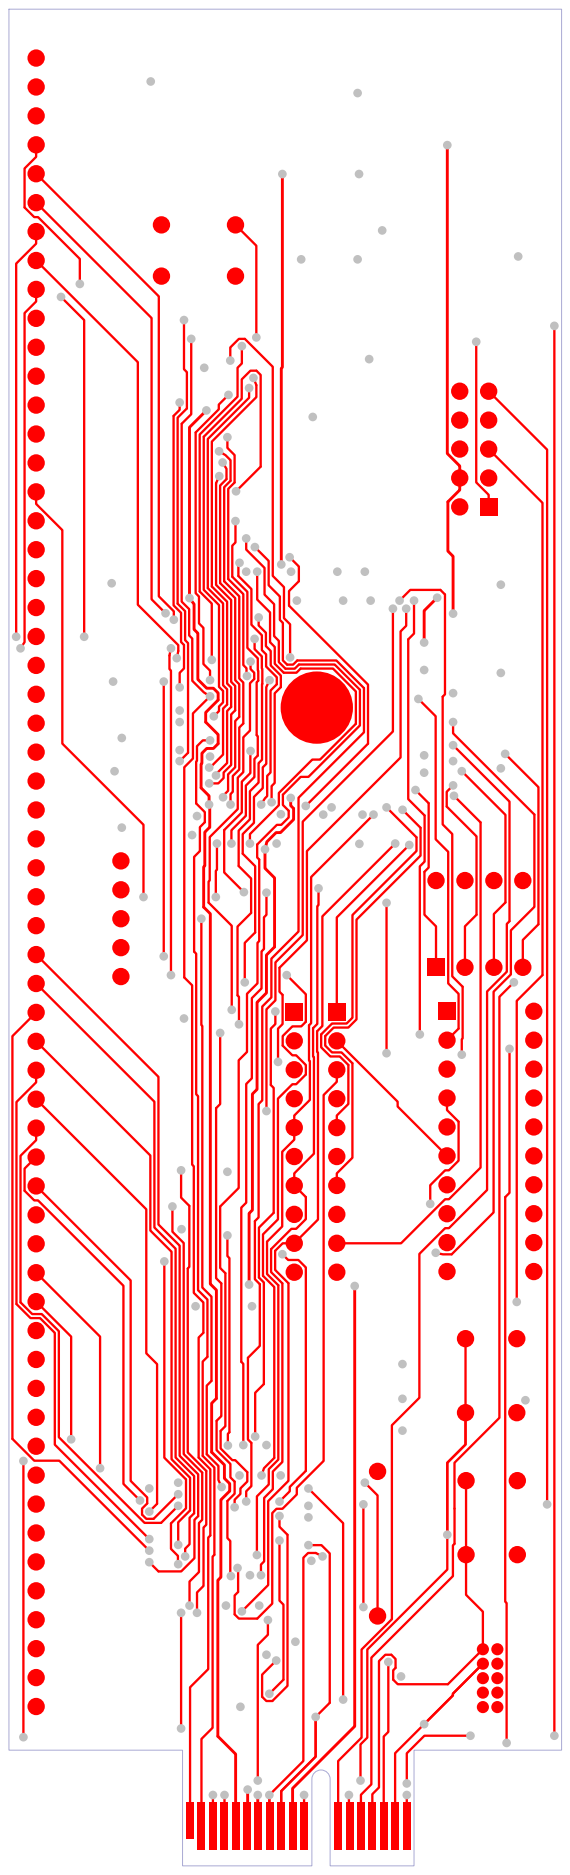
[picture p80: page 4]
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

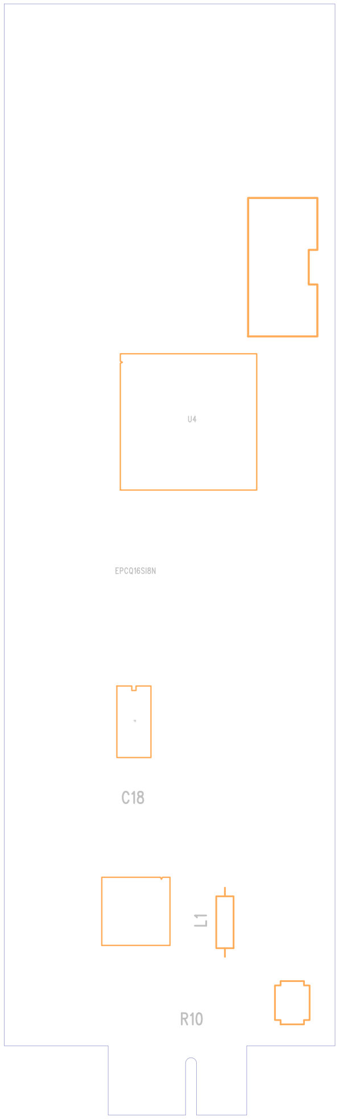
[picture p81: figure]
EPCQ16SI8N; JTAGFPGA; JTAGSAM

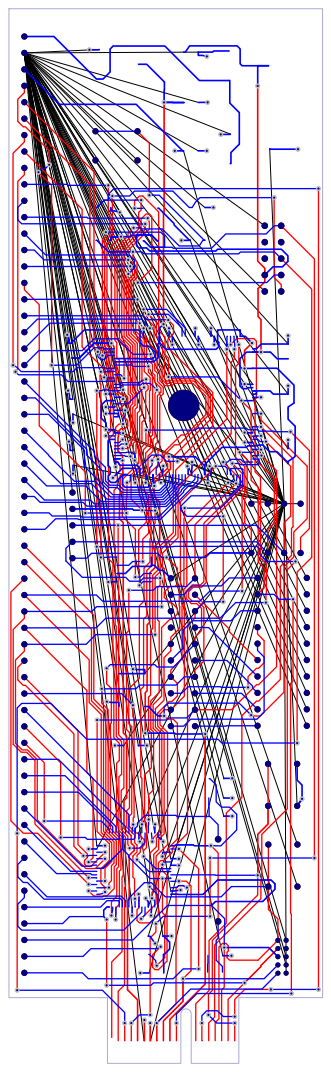
[picture p82: page 9]
