kpezeshki/MuddPiV5/New PCB, no jumpers/uMuddMarkVLogic_Oscillator.pdf

6 | 5 | 4 | 3 | 2 | 1

D

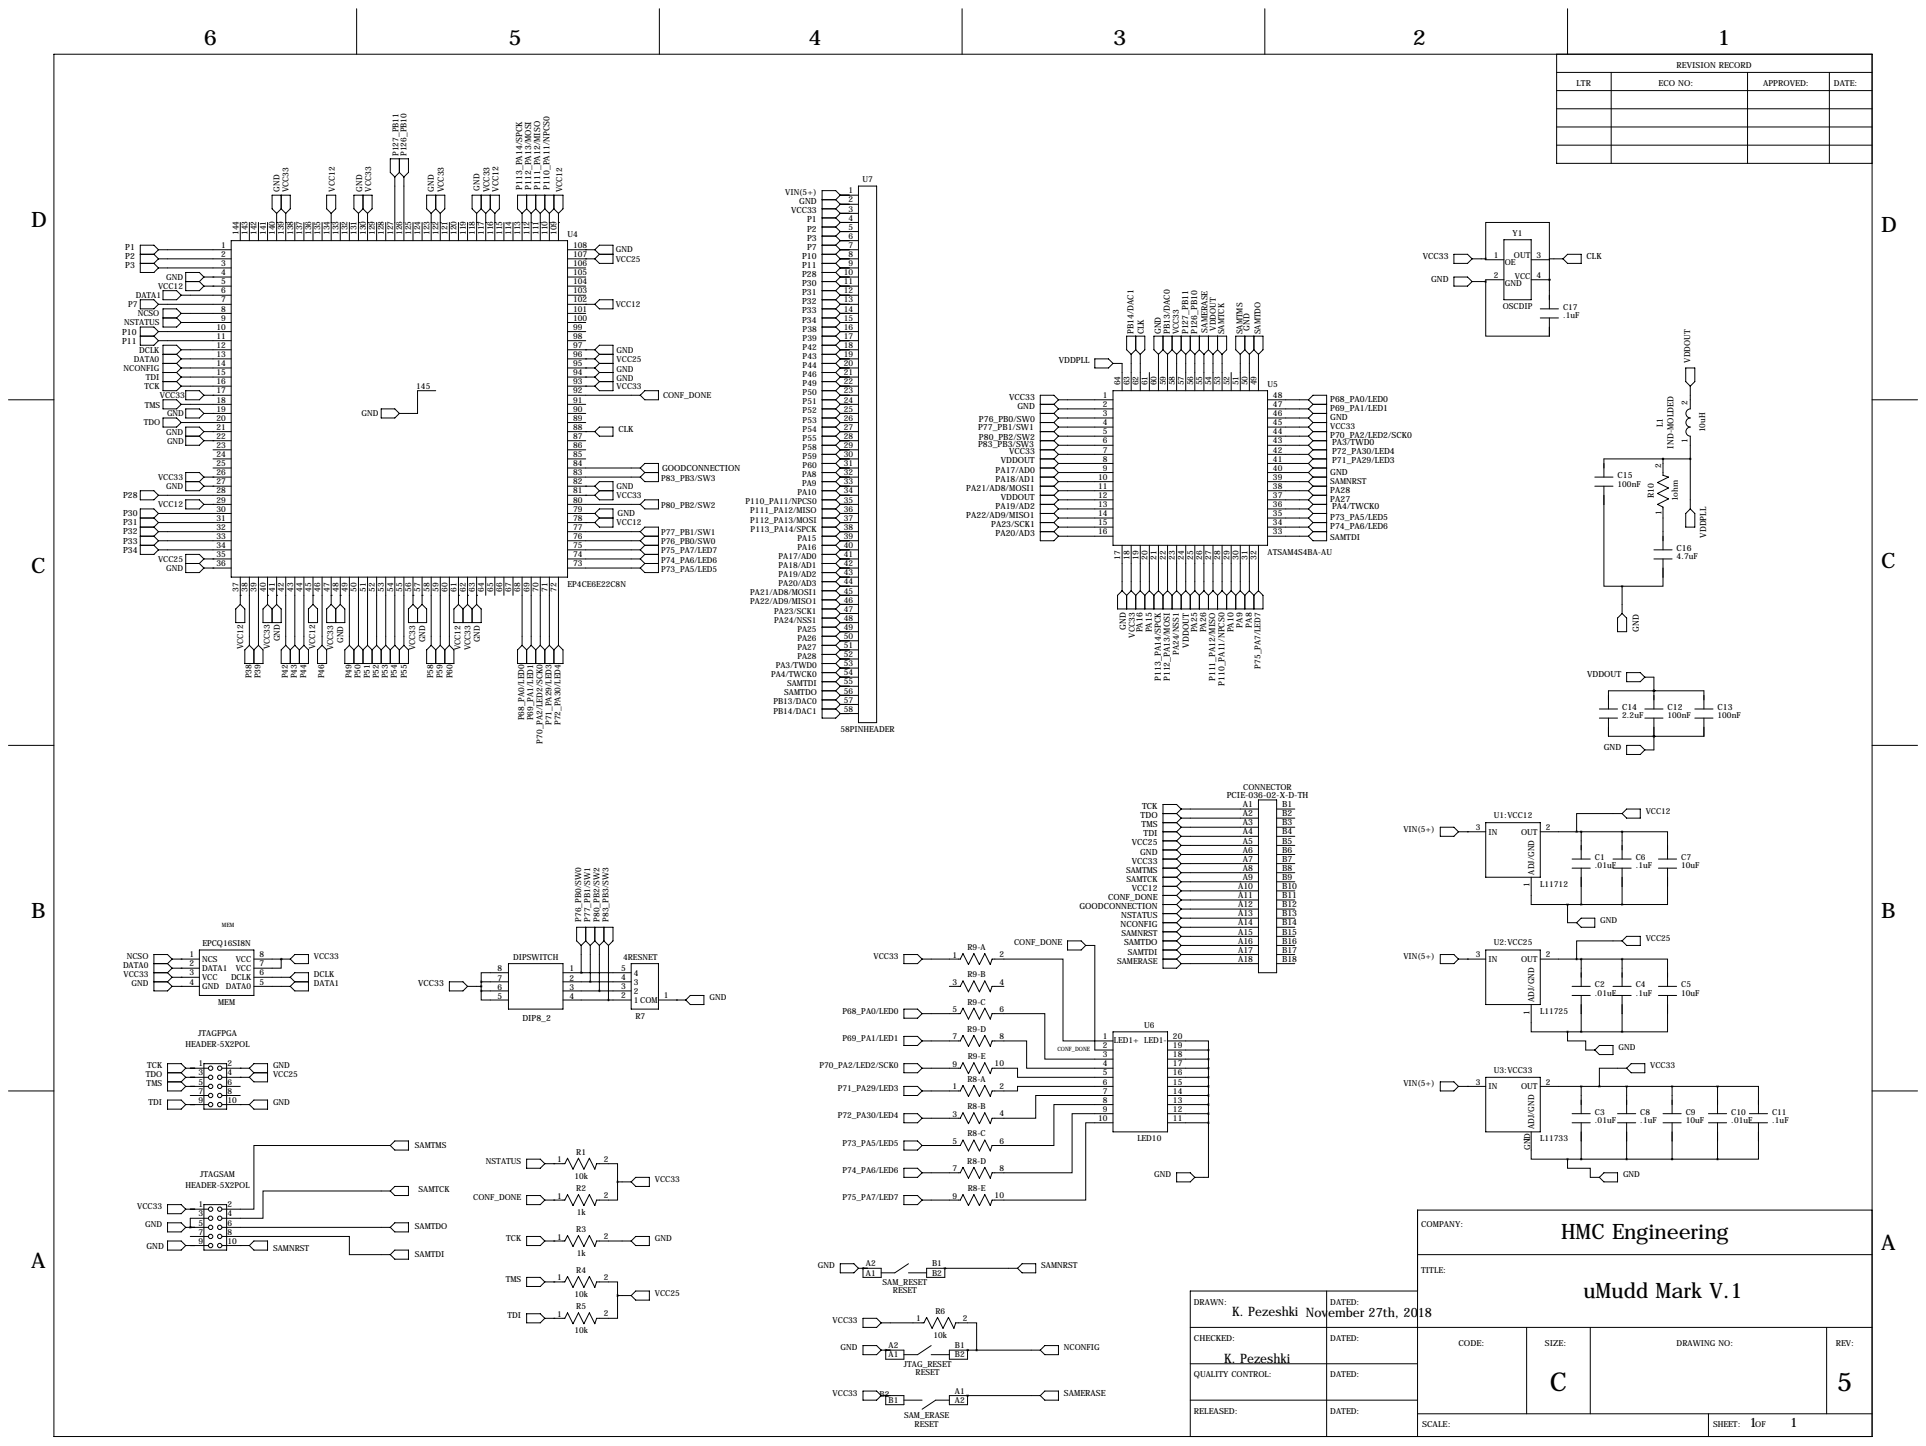
[picture p83: page 1]

U7 | REVISION RECORD

LTR | ECO NO: | APPROVED: | DATE:

DRAWN: K. Pezeshki November 27th, 2018 | DATED:
CHECKED: K. Pezeshki | DATED: | CODE: | SIZE: C | DRAWING NO: | REV: 5

QUALITY CONTROL: | DATED:

RELEASED: | DATED:

SCALE: | 1 1 SHEET: OF
