kpezeshki/MuddPiV5/New PCB, no jumpers/uMuddMarkVLayout_2.pdf

R4R⁴x1 | R⁴x2
C7C⁷x1 | C⁷x2

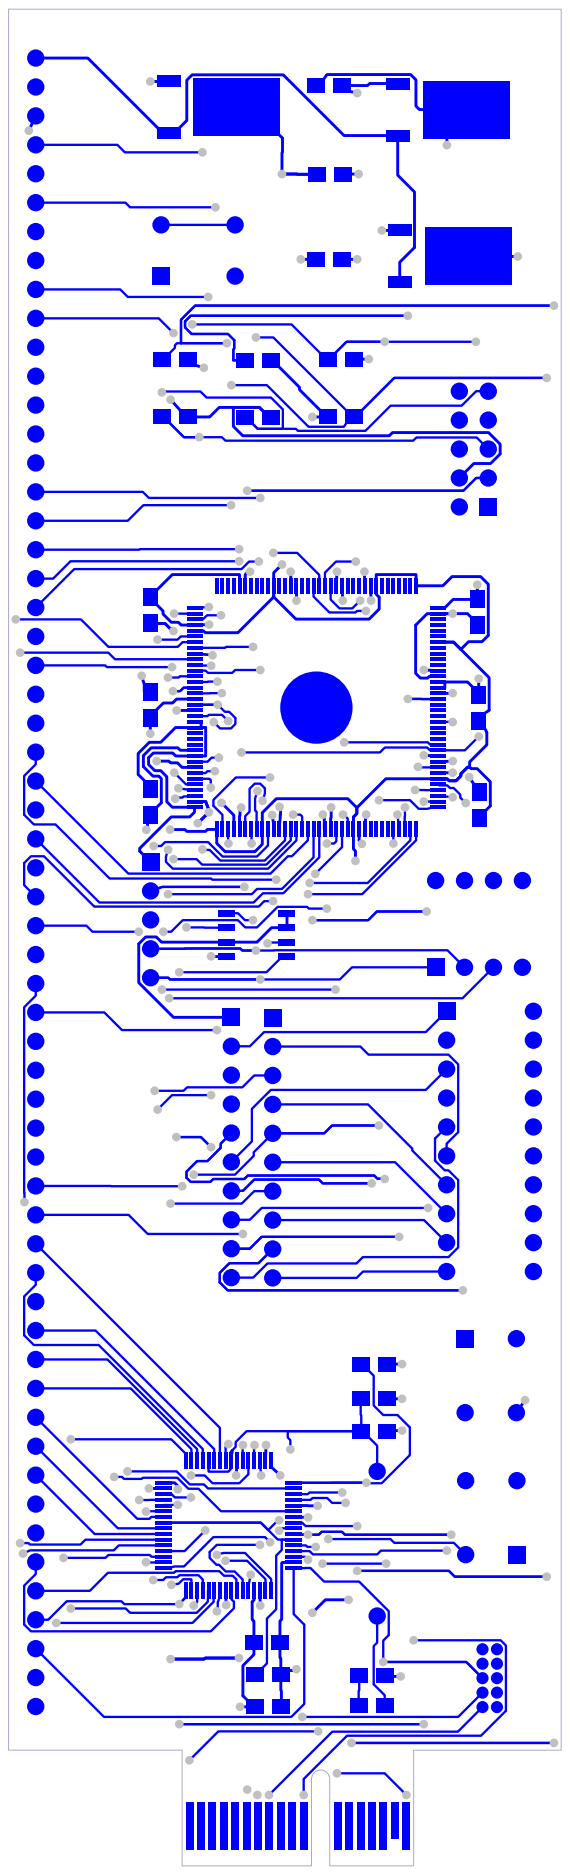
[picture p89: page 1]
SAM_RESETSAM_RESETxA¹ SAM_RESETxA² SAM_RESETxB¹ SAM_RESETxB²; SAM_ERASE SAM_ERASExA¹ SAM_ERASExA²; SAM_ERASExB¹ SAM_ERASExB²; C1C¹x1 C¹x2; C6C⁶x1 C⁶x2; C4C⁴x1 C⁴x2; C5C⁵x1; C⁵x2; JTAGSAM JTAGSAMx2 JTAGSAMx1 JTAGSAMx4 JTAGSAMx3 JTAGSAMx6 JTAGSAMx5 JTAGSAMx8 JTAGSAMx7 JTAGSAMx10 JTAGSAMx9; R3R³x1; R³x2; U3:VCC33 U³:VCC³³x1 U³:VCC³³x3; U³:VCC³³x2; U2:VCC25 U²:VCC²⁵x1 U²:VCC²⁵x3; U²:VCC²⁵x2; C8C⁸x1; C⁸x2; R7R⁷x1 R⁷x2 R⁷x3 R⁷x4 R⁷x5; R2R²x1; R²x2; C12C¹²x1; C¹²x2; C13C¹³x1; C¹³x2; C11C¹¹x1 C¹¹x2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

JTAGFPGA JTAGFPGAx2 JTAGFPGAx1 JTAGFPGAx4 JTAGFPGAx3 JTAGFPGAx6 JTAGFPGAx5 JTAGFPGAx8 JTAGFPGAx7 JTAGFPGAx10 JTAGFPGAx9

U4U⁴x145 U7U⁷x1 U⁷x2 U⁷x3 U⁷x4 U⁷x5 U⁷x6 U⁷x7 U⁷x8 U⁷x9 U⁷x10 U⁷x11 U⁷x12 U⁷x13 U⁷x14 U⁷x15 U⁷x16 U⁷x17 U⁷x18 U⁷x19 U⁷x20 U⁷x21 U⁷x22 U⁷x23 U⁷x24 U⁷x25 U⁷x26 U⁷x27 U⁷x28 U⁷x29 U⁷x30 U⁷x31 U⁷x32 U⁷x33 U⁷x34 U⁷x35 U⁷x36 U⁷x37 U⁷x38 U⁷x39 U⁷x40 U⁷x41 U⁷x42 U⁷x43 U⁷x44 U⁷x45 U⁷x46 U⁷x47 U⁷x48 U⁷x49 U⁷x50 U⁷x51 U⁷x52 U⁷x53 U⁷x54 U⁷x55 U⁷x56 U⁷x57 U⁷x58

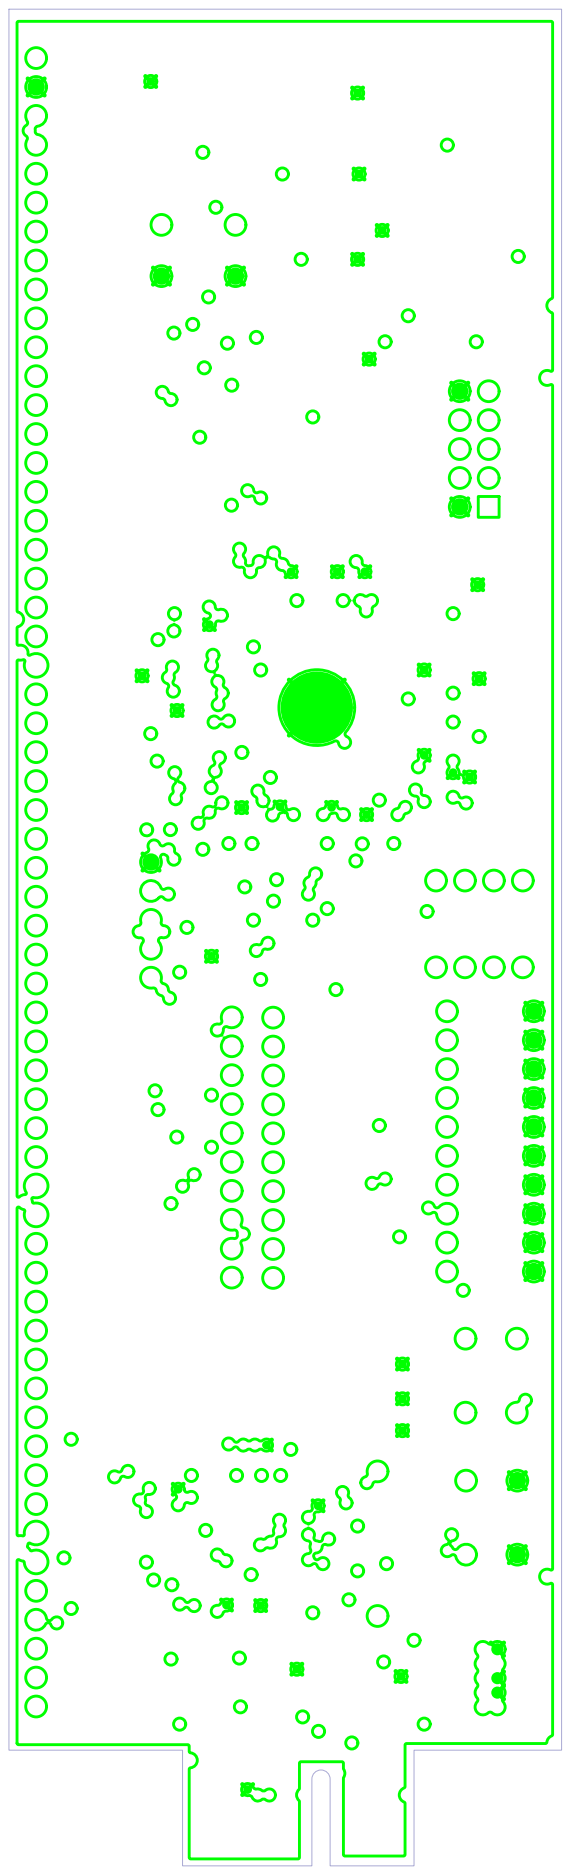
[picture p90: page 2]
SAM_RESETSAM_RESETxA¹ SAM_RESETxA² SAM_RESETxB¹ SAM_RESETxB²; SAM_ERASE SAM_ERASExA¹ SAM_ERASExA²; SAM_ERASExB¹ SAM_ERASExB²; JTAGSAM JTAGSAMx2 JTAGSAMx1 JTAGSAMx4 JTAGSAMx3 JTAGSAMx6 JTAGSAMx5 JTAGSAMx8 JTAGSAMx7 JTAGSAMx10 JTAGSAMx9; R7R⁷x1 R⁷x2 R⁷x3 R⁷x4 R⁷x5; U6U⁶x1 U⁶x2 U⁶x3 U⁶x4 U⁶x5 U⁶x6 U⁶x7 U⁶x8 U⁶x9 U⁶x10; U⁶x11 U⁶x12 U⁶x13 U⁶x14 U⁶x15 U⁶x16 U⁶x17 U⁶x18 U⁶x19 U⁶x20; JTAG_RESET JTAG_RESETxA¹; JTAG_RESETxA² JTAG_RESETxB¹; JTAG_RESETxB²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

JTAGFPGA JTAGFPGAx2 JTAGFPGAx1 JTAGFPGAx4 JTAGFPGAx3 JTAGFPGAx6 JTAGFPGAx5 JTAGFPGAx8 JTAGFPGAx7 JTAGFPGAx10 JTAGFPGAx9

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

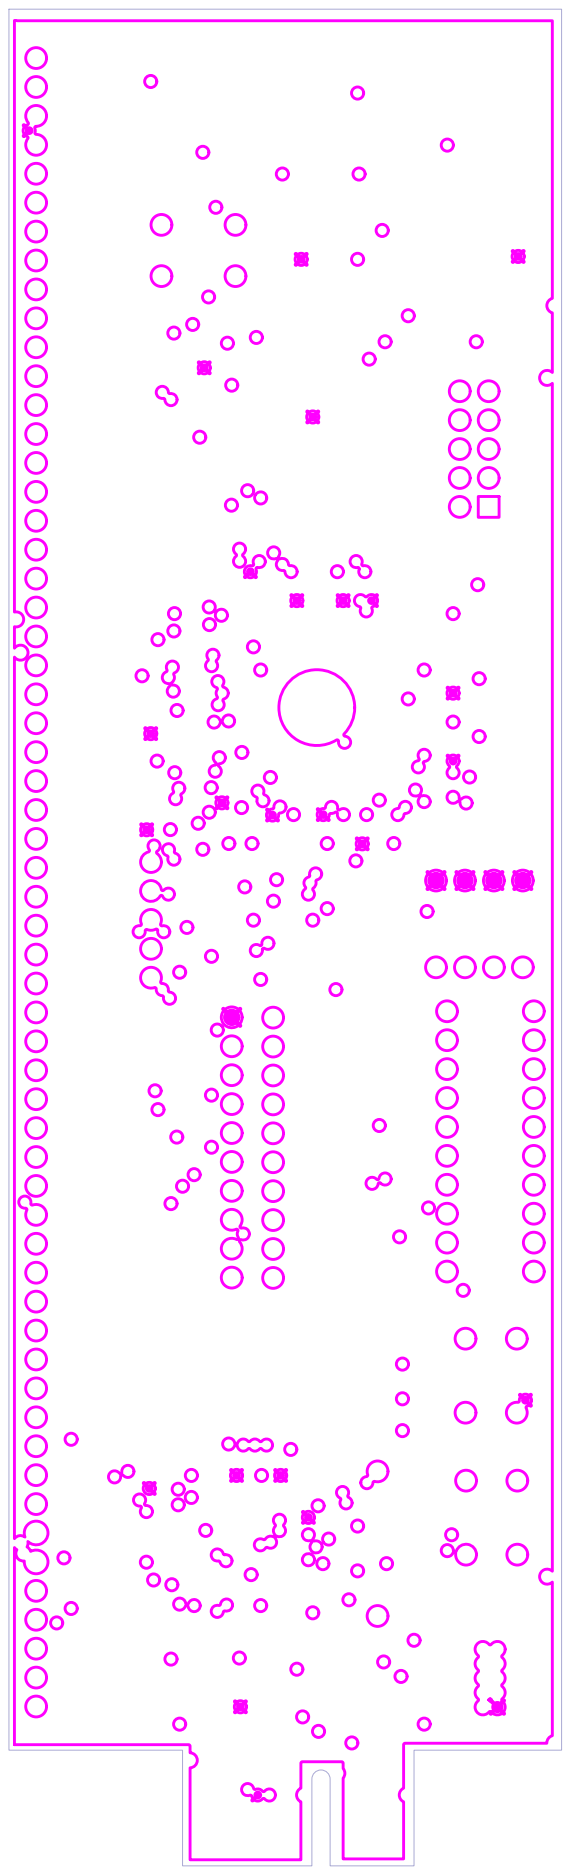
[picture p91: page 3]
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

JTAGFPGA JTAGFPGAx2 JTAGFPGAx1 JTAGFPGAx4 JTAGFPGAx3 JTAGFPGAx6 JTAGFPGAx5 JTAGFPGAx8 JTAGFPGAx7 JTAGFPGAx10 JTAGFPGAx9

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

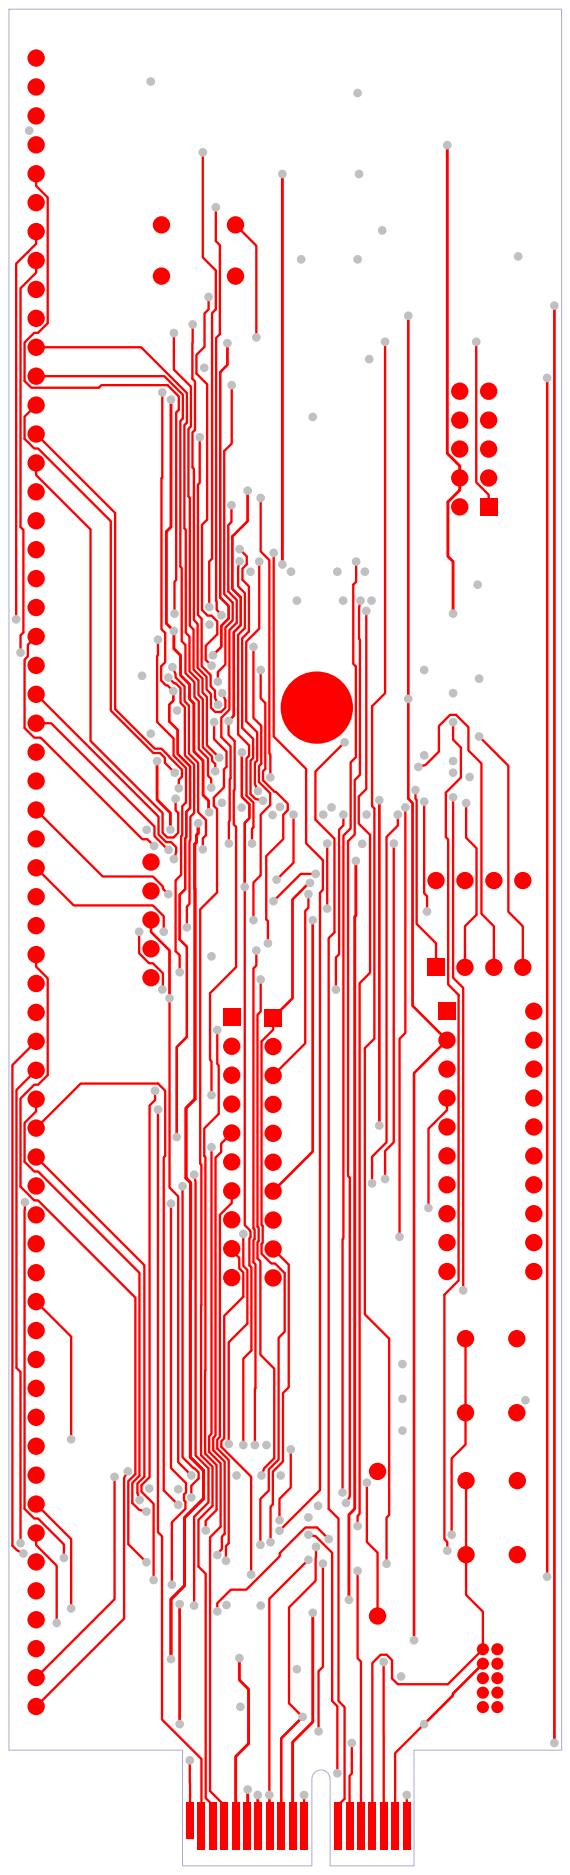
[picture p92: page 4]
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

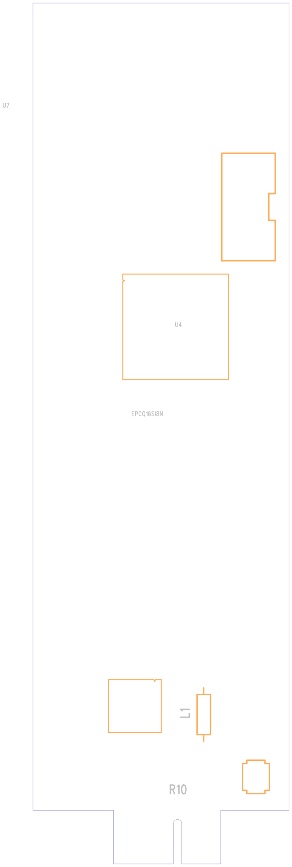
[picture p93: figure]
EPCQ16SI8N; JTAGSAM; JTAGFPGA

# VIN GND

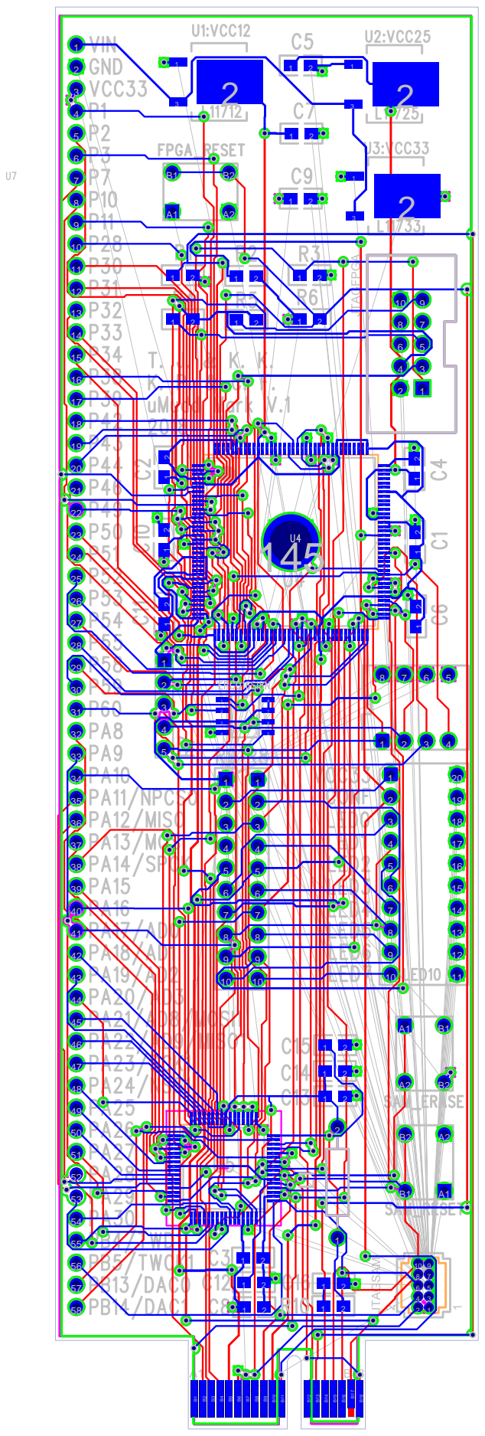
[picture p94: page 7]

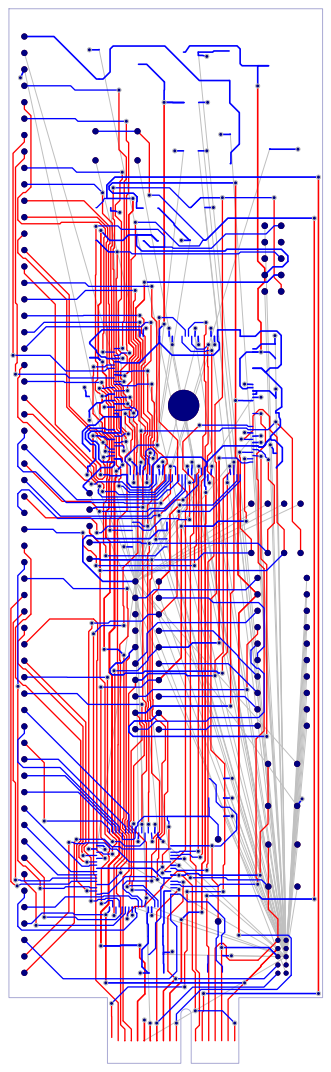
[picture p95: page 10]
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
