kpezeshki/MuddPiV5/New PCB/logicrouted.pdf

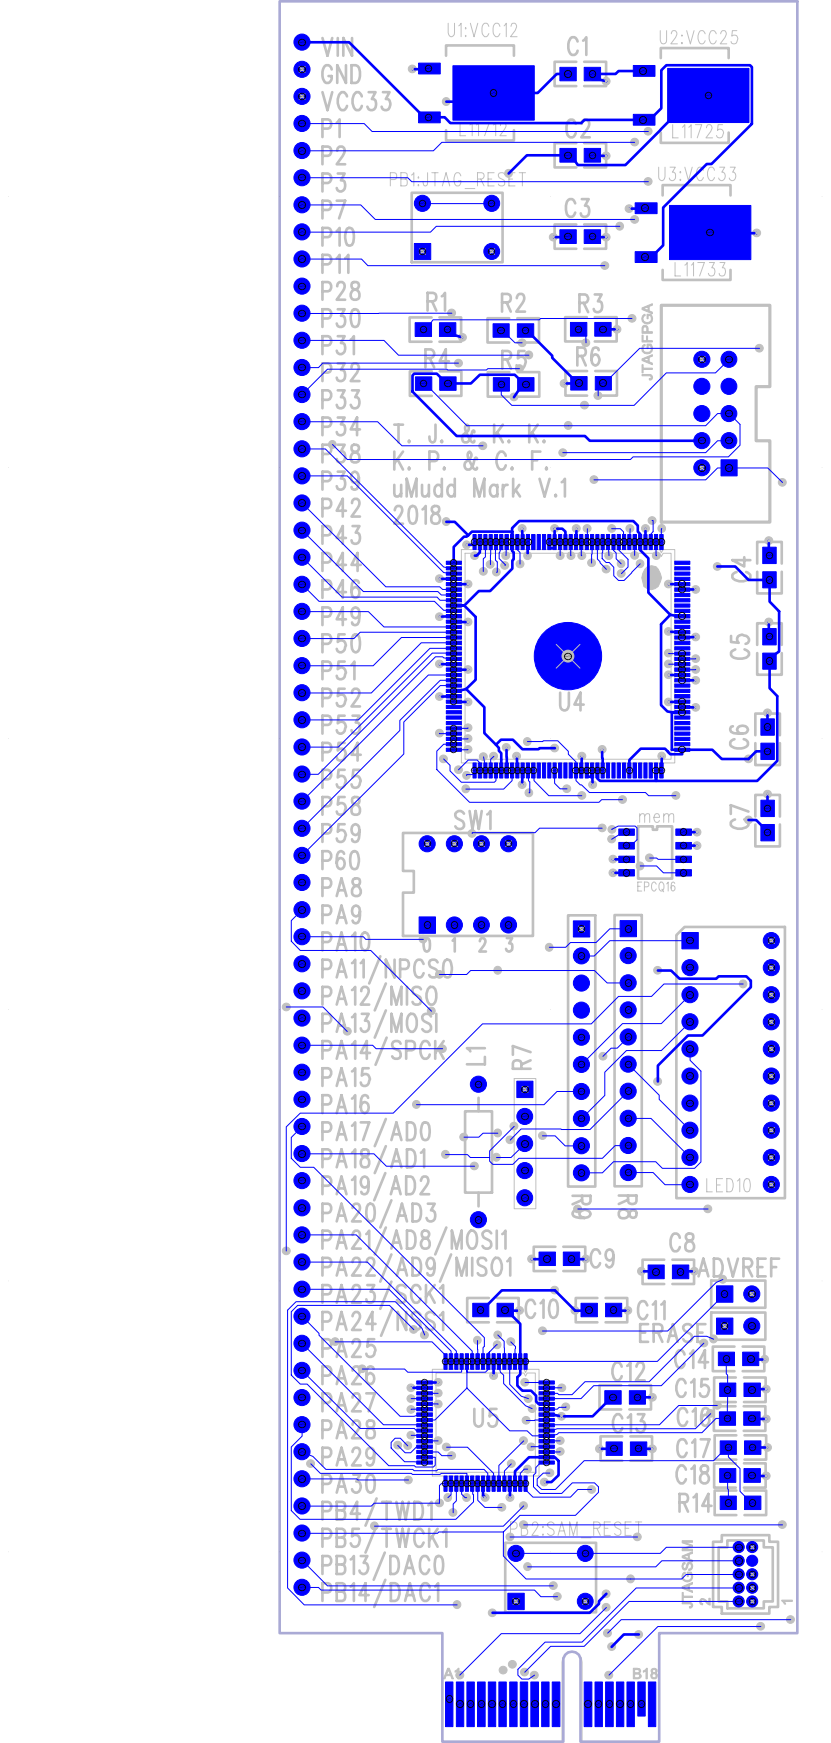
[picture p96: page 1]
