kpezeshki/MuddPiV5/Pre-Existing Work/FinalVersion/uMuddMarkVLayout.pdf

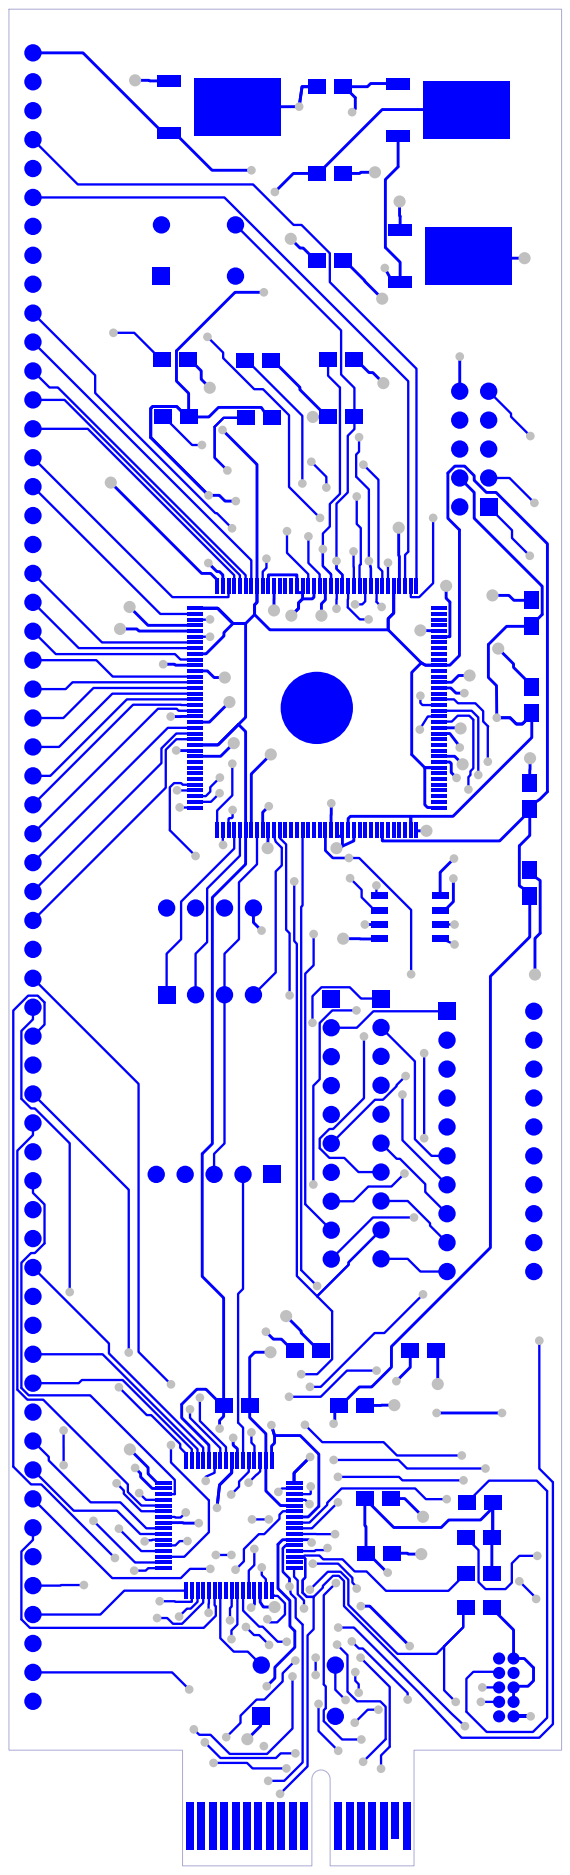
[picture p97: page 1]
C1C¹x1; C¹x2; R4R⁴x1; R⁴x2; C6C⁶x1 C⁶x2; C7C⁷x1 C⁷x2; C4C⁴x1 C⁴x2; C5C⁵x1 C⁵x2; JTAGSAM JTAGSAMx2 JTAGSAMx1 JTAGSAMx4 JTAGSAMx3 JTAGSAMx6 JTAGSAMx5 JTAGSAMx8 JTAGSAMx7 JTAGSAMx10 JTAGSAMx9; R3R³x1; R³x2; U3:VCC33 U³:VCC³³x1 U³:VCC³³x3; U³:VCC³³x2; U2:VCC25 U²:VCC²⁵x1 U²:VCC²⁵x3; U²:VCC²⁵x2; C8C⁸x1; C⁸x2; U9U⁹x1 U⁹x2 U⁹x3 U⁹x4 U⁹x8 U⁹x7 U⁹x6 U⁹x5; R7R⁷x5; R⁷x4; R⁷x3; R⁷x2; R⁷x1; R2R²x1; R²x2; C12C¹²x1; C¹²x2; C13C¹³x1; C¹³x2; C11C¹¹x1; C¹¹x2; R6R⁶x1; R⁶x2; C2C²x1; C²x2; C3C³x1; C³x2; C9C⁹x1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

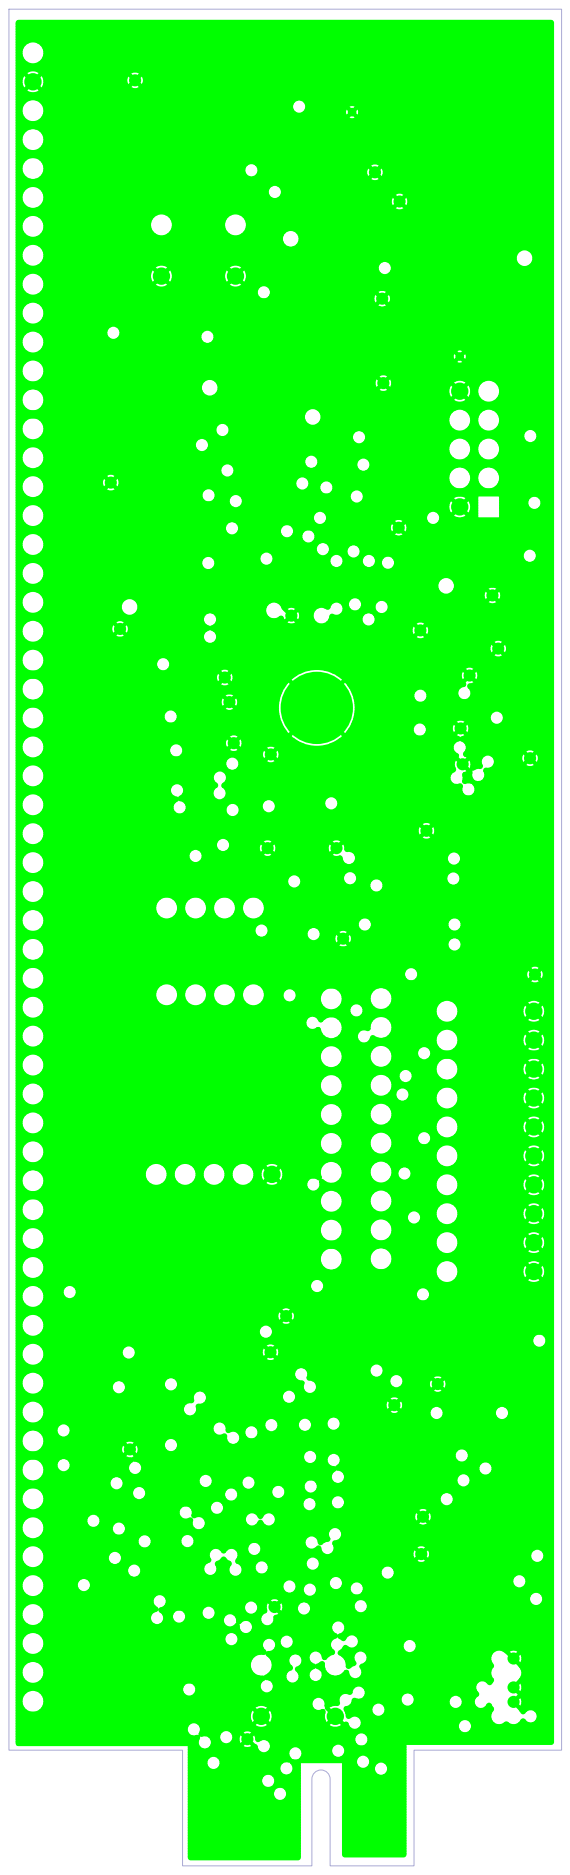
[picture p98: page 2]
JTAGSAM JTAGSAMx2 JTAGSAMx1 JTAGSAMx4 JTAGSAMx3 JTAGSAMx6 JTAGSAMx5 JTAGSAMx8 JTAGSAMx7 JTAGSAMx10 JTAGSAMx9; U9U⁹x1 U⁹x2 U⁹x3 U⁹x4 U⁹x8 U⁹x7 U⁹x6 U⁹x5; R7R⁷x5; R⁷x4; R⁷x3; R⁷x2; R⁷x1; U10 U¹⁰x1 U¹⁰x2 U¹⁰x3 U¹⁰x4 U¹⁰x5 U¹⁰x6 U¹⁰x7 U¹⁰x8 U¹⁰x9 U¹⁰x10; U¹⁰x11 U¹⁰x12 U¹⁰x13 U¹⁰x14 U¹⁰x15 U¹⁰x16 U¹⁰x17 U¹⁰x18 U¹⁰x19 U¹⁰x20; PB1:JTAG_RESET PB¹:JTAG_RESETxA¹; PB¹:JTAG_RESETxA² PB¹:JTAG_RESETxB¹; PB¹:JTAG_RESETxB²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

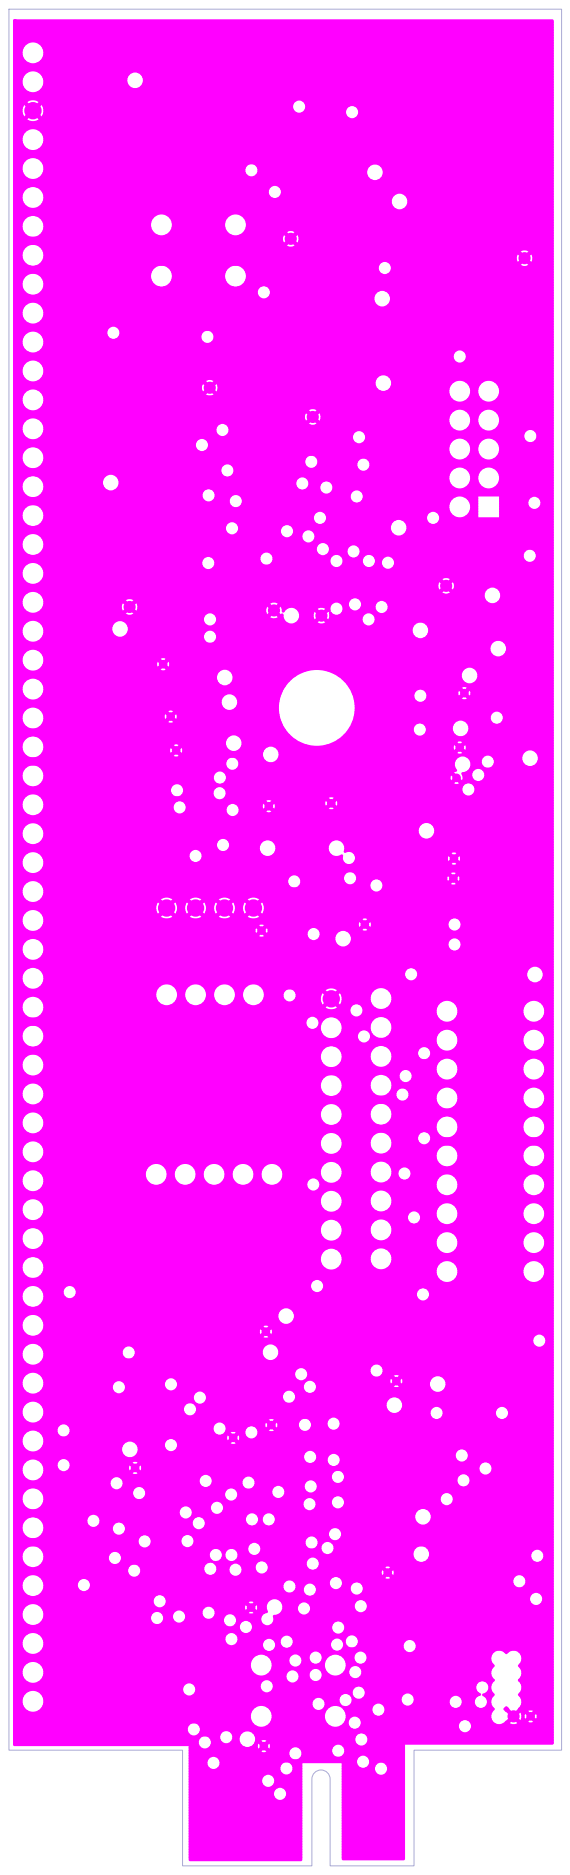
[picture p99: page 3]
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

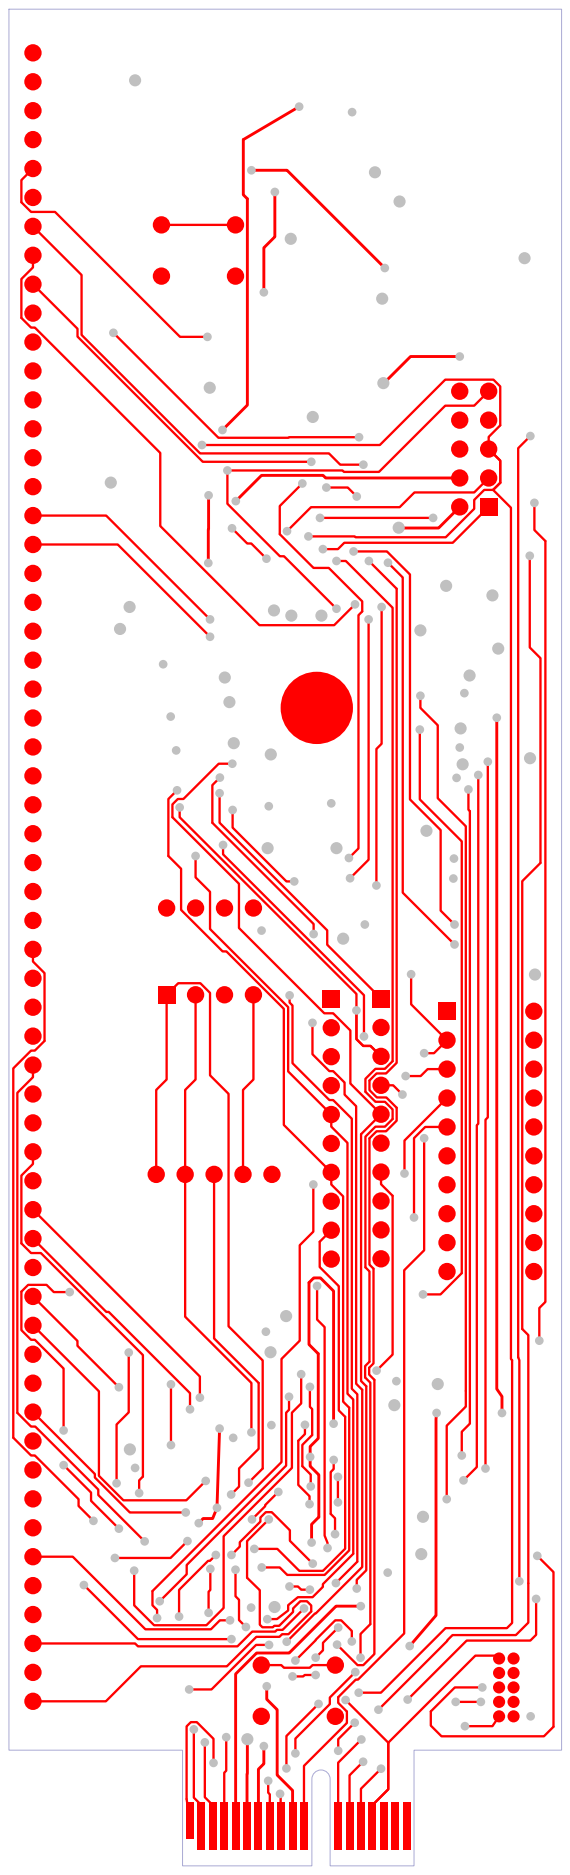
[picture p100: page 4]
JTAGSAM JTAGSAMx2 JTAGSAMx1 JTAGSAMx4 JTAGSAMx3 JTAGSAMx6 JTAGSAMx5 JTAGSAMx8 JTAGSAMx7 JTAGSAMx10 JTAGSAMx9; U9U⁹x1 U⁹x2 U⁹x3 U⁹x4 U⁹x8 U⁹x7 U⁹x6 U⁹x5; R7R⁷x5; R⁷x4; R⁷x3; R⁷x2; R⁷x1; U10 U¹⁰x1 U¹⁰x2 U¹⁰x3 U¹⁰x4 U¹⁰x5 U¹⁰x6 U¹⁰x7 U¹⁰x8 U¹⁰x9 U¹⁰x10; U¹⁰x11 U¹⁰x12 U¹⁰x13 U¹⁰x14 U¹⁰x15 U¹⁰x16 U¹⁰x17 U¹⁰x18 U¹⁰x19 U¹⁰x20; CONNECTOR CONNECTORxA¹ CONNECTORxA² CONNECTORxA³ CONNECTORxA⁴ CONNECTORxA⁵ CONNECTORxA⁶ CONNECTORxA⁷ CONNECTORxA⁸ CONNECTORxA⁹ CONNECTORxA¹⁰ CONNECTORxA¹¹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

JTAGSAM

U6

U8

JTAGFPGA

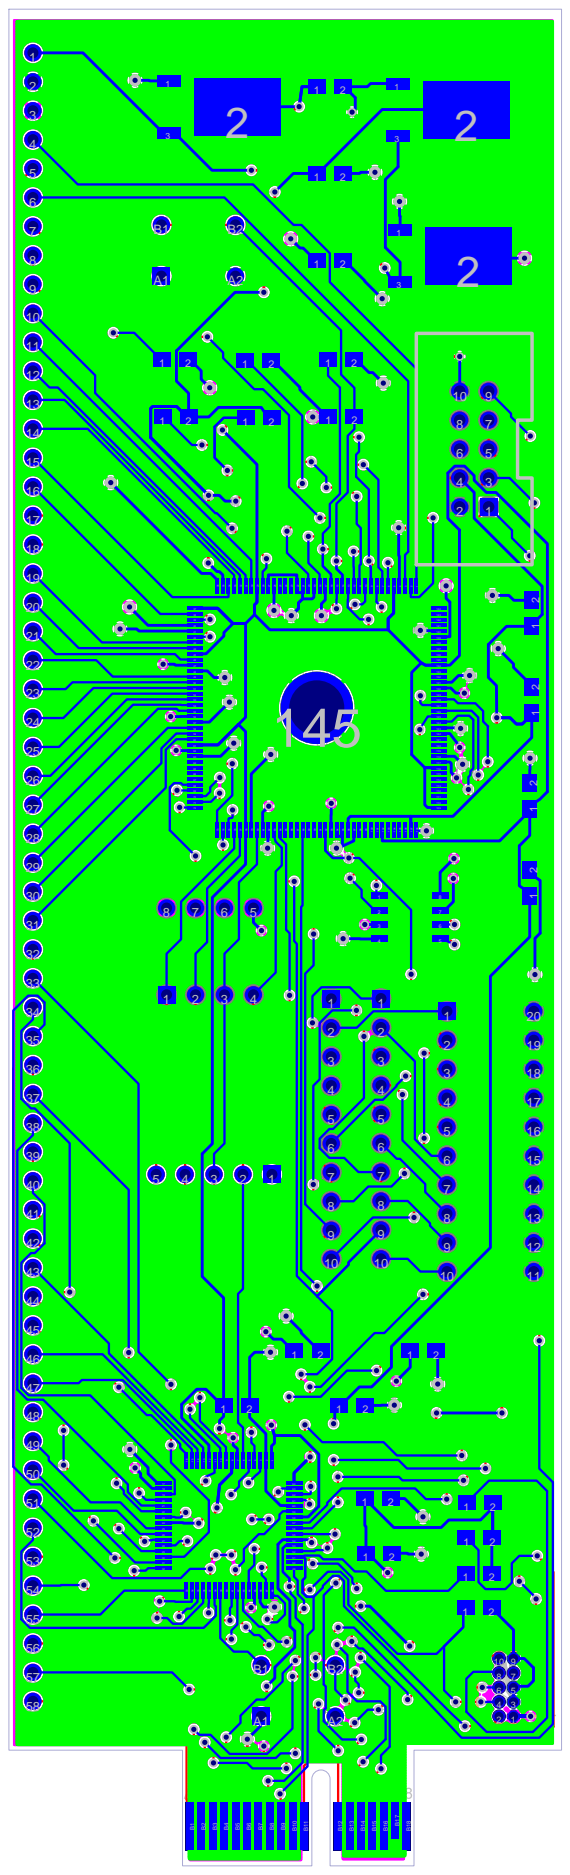
[picture p101: page 7]

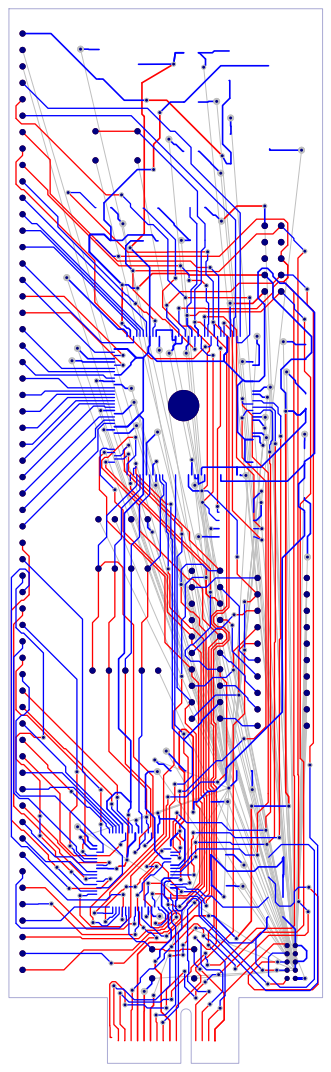
[picture p102: page 10]
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
