kpezeshki/MuddPiV5/Pre-Existing Work/DEPRECATED/OLD/uMuddBoard-3-26-15/E155BoardSchematic2.pdf

6 | 5 | 4 | 3 | 2 | 1

D

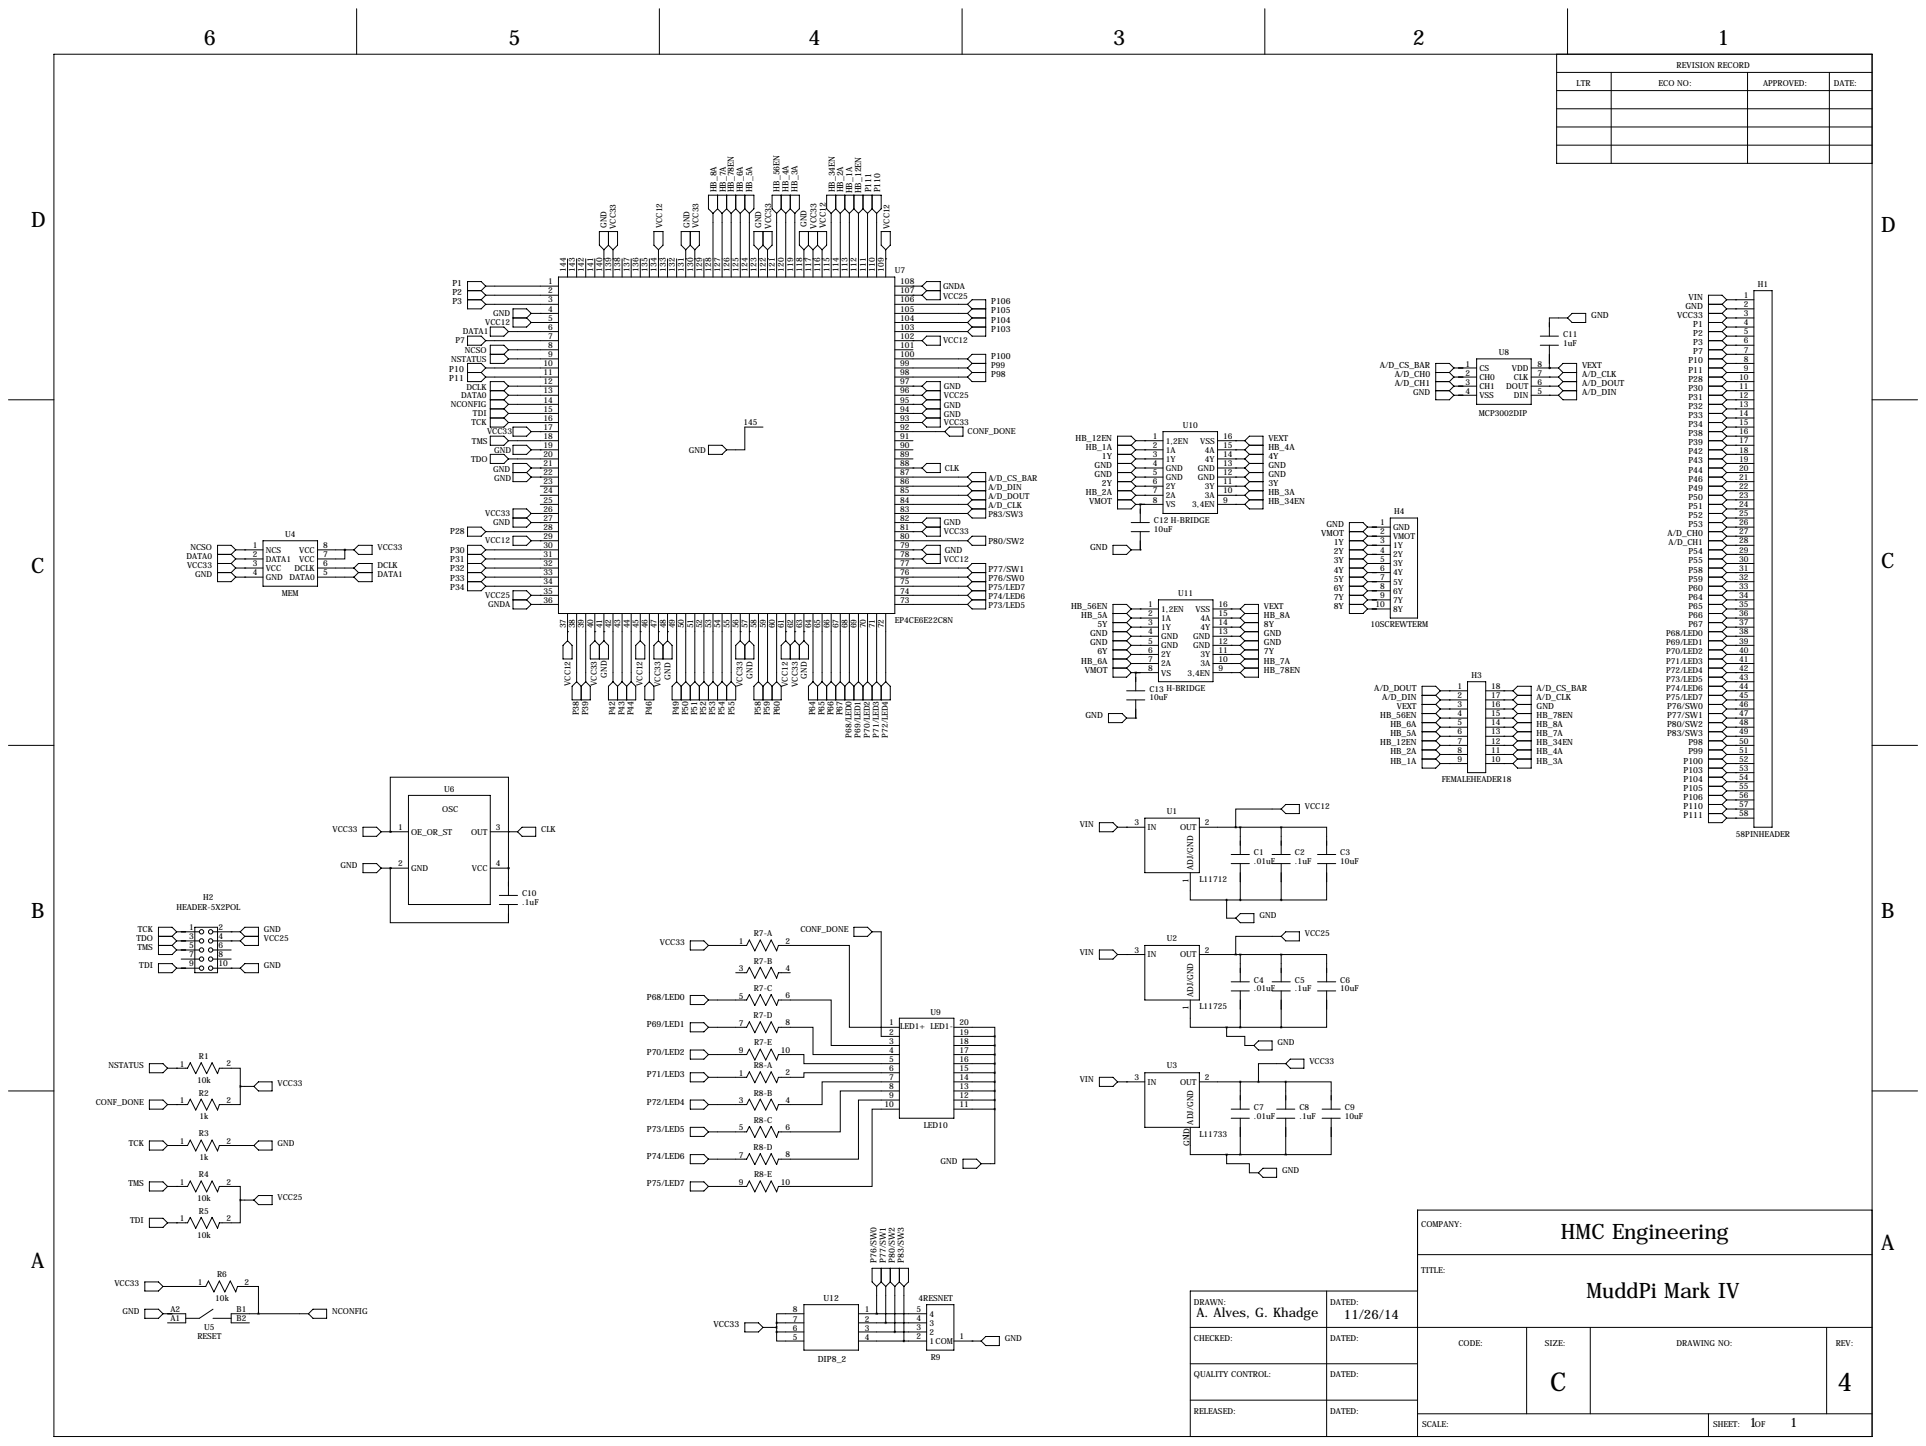
[picture p103: page 1]

REVISION RECORD

LTR | ECO NO: | APPROVED: | DATE:

DRAWN: A. Alves, G. Khadge | DATED: 11/26/14
CHECKED: | DATED: | CODE: | SIZE: C | DRAWING NO: | REV: 4

QUALITY CONTROL: | DATED:

RELEASED: | DATED:

SCALE: | 1 1 SHEET: OF
