kpezeshki/MuddPiV5/Pre-Existing Work/DEPRECATED/OLD/microp-revised-board-20170927T040230Z-001/microp-revised-board.pdf

U7

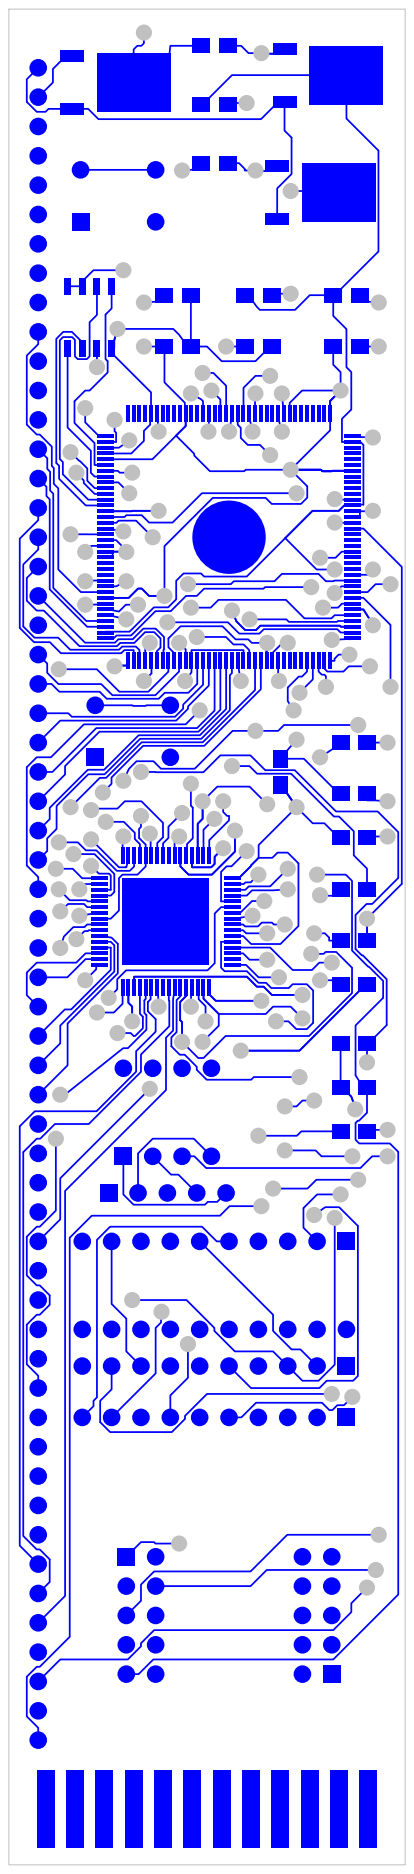
[picture p104: page 1]
C2C²x1; C²x2; C9C⁹x1; C⁹x2 U11U¹¹x1 U¹¹x2 U¹¹x3 U¹¹x4 U¹¹x5 U¹¹x6 U¹¹x7 U¹¹x8 U¹¹x9 U¹¹x10 U¹¹x11 U¹¹x12 U¹¹x13 U¹¹x14 U¹¹x15 U¹¹x16 U¹¹x17 U¹¹x18 U¹¹x19 U¹¹x20 U¹¹x21 U¹¹x22 U¹¹x23 U¹¹x24 U¹¹x25 U¹¹x26 U¹¹x27 U¹¹x28 U¹¹x29 U¹¹x30 U¹¹x31 U¹¹x32 U¹¹x33 U¹¹x34 U¹¹x35 U¹¹x36 U¹¹x37 U¹¹x38 U¹¹x39 U¹¹x40 U¹¹x41 U¹¹x42 U¹¹x43 U¹¹x44 U¹¹x45 U¹¹x46 U¹¹x47 U¹¹x48 U¹¹x49 U¹¹x50 U¹¹x51 U¹¹x52 U¹¹x53 U¹¹x54 U¹¹x55 U¹¹x56 U¹¹x57 U¹¹x58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

U7U⁷x145 U11U¹¹x1 U¹¹x2 U¹¹x3 U¹¹x4 U¹¹x5 U¹¹x6 U¹¹x7 U¹¹x8 U¹¹x9 U¹¹x10 U¹¹x11 U¹¹x12 U¹¹x13 U¹¹x14 U¹¹x15 U¹¹x16 U¹¹x17 U¹¹x18 U¹¹x19 U¹¹x20 U¹¹x21 U¹¹x22 U¹¹x23 U¹¹x24 U¹¹x25 U¹¹x26 U¹¹x27 U¹¹x28 U¹¹x29 U¹¹x30 U¹¹x31 U¹¹x32 U¹¹x33 U¹¹x34 U¹¹x35 U¹¹x36 U¹¹x37 U¹¹x38 U¹¹x39 U¹¹x40 U¹¹x41 U¹¹x42 U¹¹x43 U¹¹x44 U¹¹x45 U¹¹x46 U¹¹x47 U¹¹x48 U¹¹x49 U¹¹x50 U¹¹x51 U¹¹x52 U¹¹x53 U¹¹x54 U¹¹x55 U¹¹x56 U¹¹x57 U¹¹x58

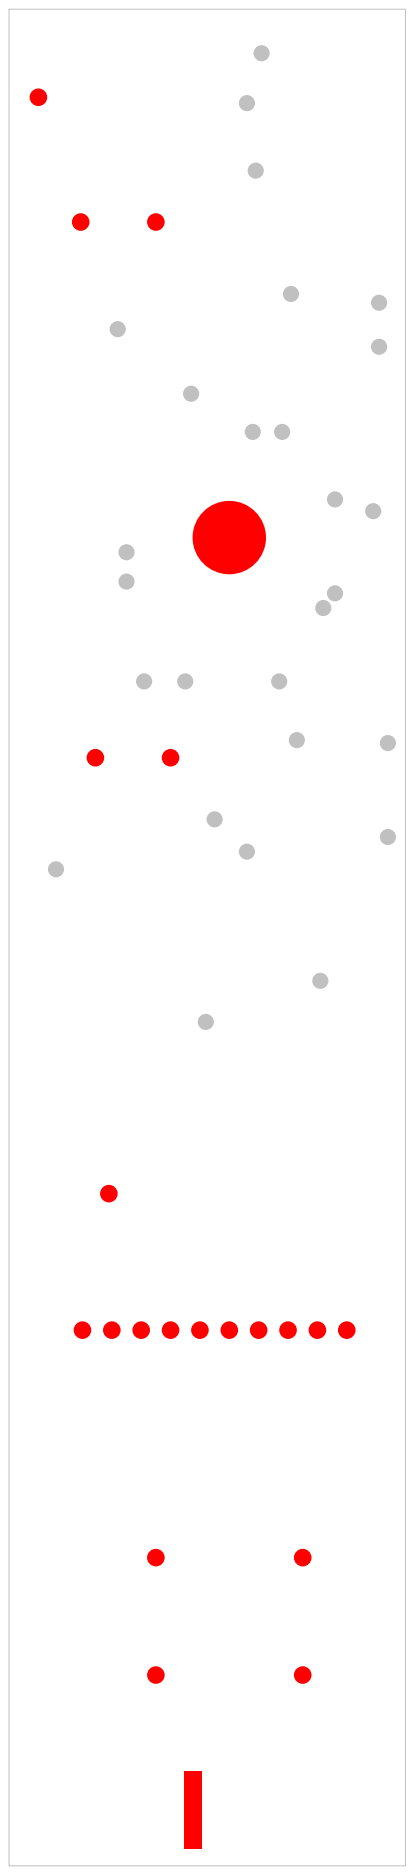
[picture p105: page 2]
U13 U¹³x1 U¹³x2 U¹³x3 U¹³x4 U¹³x5; U¹³x6; U¹³x7 U¹³x8 U¹³x9 U¹³x10 U¹³x11 U¹³x12; R9R⁹x1; R⁹x2; R⁹x3; R⁹x4; R⁹x5; R7 R⁷x10 R⁷x9 R⁷x8 R⁷x7 R⁷x6 R⁷x5 R⁷x4 R⁷x3 R⁷x2 R⁷x1; U9 R⁸x10 R⁸x9 R⁸x8 R⁸x7 R⁸x6 R⁸x5 R⁸x4 R⁸x3 R⁸x2 R⁸x1 U⁹x10 U⁹x9 U⁹x8 U⁹x7 U⁹x6 U⁹x5 U⁹x4 U⁹x3 U⁹x2 U⁹x1 U⁹x11 U⁹x12 U⁹x13 U⁹x14 U⁹x15 U⁹x16 U⁹x17 U⁹x18 U⁹x19 U⁹x20; U4U⁴xA¹; U⁴xA² U⁴xB¹; U⁴xB²; U5U⁵xA¹; U⁵xA² U⁵xB¹; U⁵xB²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

U13 U¹³x1 U¹³x2 U¹³x3 U¹³x4 U¹³x5 U¹³x6 U¹³x7 U¹³x8 U¹³x9 U¹³x10 U¹³x11 U¹³x12

R9R⁹x1 | R⁹x2 | R⁹x3 | R⁹x4 | R⁹x5

R7 R⁷x10 R⁷x9 R⁷x8 R⁷x7 R⁷x6 R⁷x5 R⁷x4 R⁷x3 R⁷x2 R⁷x1

R8

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

U4U⁴xA¹ | U⁴xA² U⁴xB¹ | U⁴xB²
U5U⁵xA¹ | U⁵xA² U⁵xB¹ | U⁵xB²

JTAGSAM JTAGSAMx2 JTAGSAMx1 JTAGSAMx4 JTAGSAMx3 JTAGSAMx6 JTAGSAMx5 JTAGSAMx8 JTAGSAMx7 JTAGSAMx10 JTAGSAMx9

JTAGFPGA JTAGFPGAx1 JTAGFPGAx2 JTAGFPGAx3 JTAGFPGAx4 JTAGFPGAx5 JTAGFPGAx6 JTAGFPGAx7 JTAGFPGAx8 JTAGFPGAx9 JTAGFPGAx10

U10 U¹⁰x1 U¹⁰x2 U¹⁰x3 U¹⁰x4 U¹⁰x8 U¹⁰x7 U¹⁰x6 U¹⁰x5

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

U13 U¹³x1 U¹³x2 U¹³x3 U¹³x4 U¹³x5 U¹³x6 U¹³x7 U¹³x8 U¹³x9 U¹³x10 U¹³x11 U¹³x12

R9R⁹x1 | R⁹x2 | R⁹x3 | R⁹x4 | R⁹x5

R7 R⁷x10 R⁷x9 R⁷x8 R⁷x7 R⁷x6 R⁷x5 R⁷x4 R⁷x3 R⁷x2 R⁷x1

R8

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

U4U⁴xA¹ | U⁴xA² U⁴xB¹ | U⁴xB²
U5U⁵xA¹ | U⁵xA² U⁵xB¹ | U⁵xB²

JTAGSAM JTAGSAMx2 JTAGSAMx1 JTAGSAMx4 JTAGSAMx3 JTAGSAMx6 JTAGSAMx5 JTAGSAMx8 JTAGSAMx7 JTAGSAMx10 JTAGSAMx9

JTAGFPGA JTAGFPGAx1 JTAGFPGAx2 JTAGFPGAx3 JTAGFPGAx4 JTAGFPGAx5 JTAGFPGAx6 JTAGFPGAx7 JTAGFPGAx8 JTAGFPGAx9 JTAGFPGAx10

U10 U¹⁰x1 U¹⁰x2 U¹⁰x3 U¹⁰x4 U¹⁰x8 U¹⁰x7 U¹⁰x6 U¹⁰x5

U7

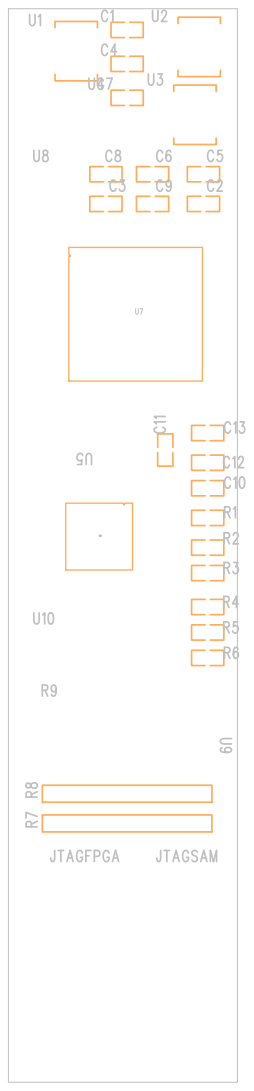
[picture p106: page 5]

U7

U7

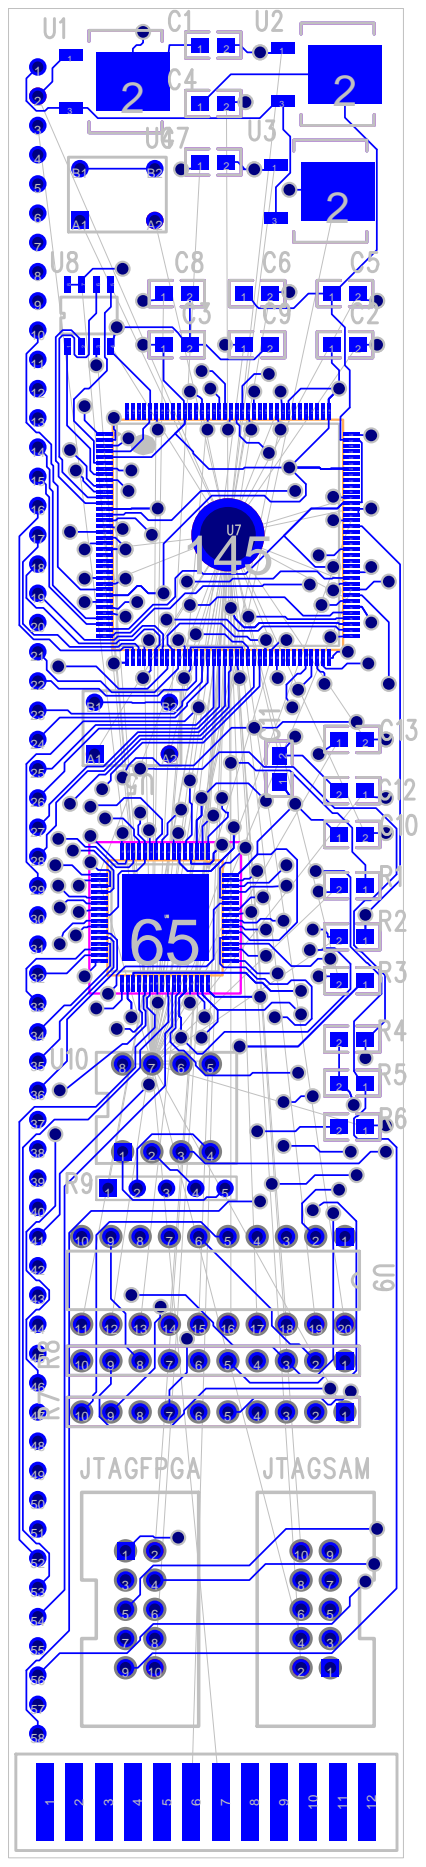
[picture p107: page 7]
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
