kpezeshki/MuddPiV5/Pre-Existing Work/DEPRECATED/OLD/uMuddBoard-3-26-15/E155BoardLayout2.pdf

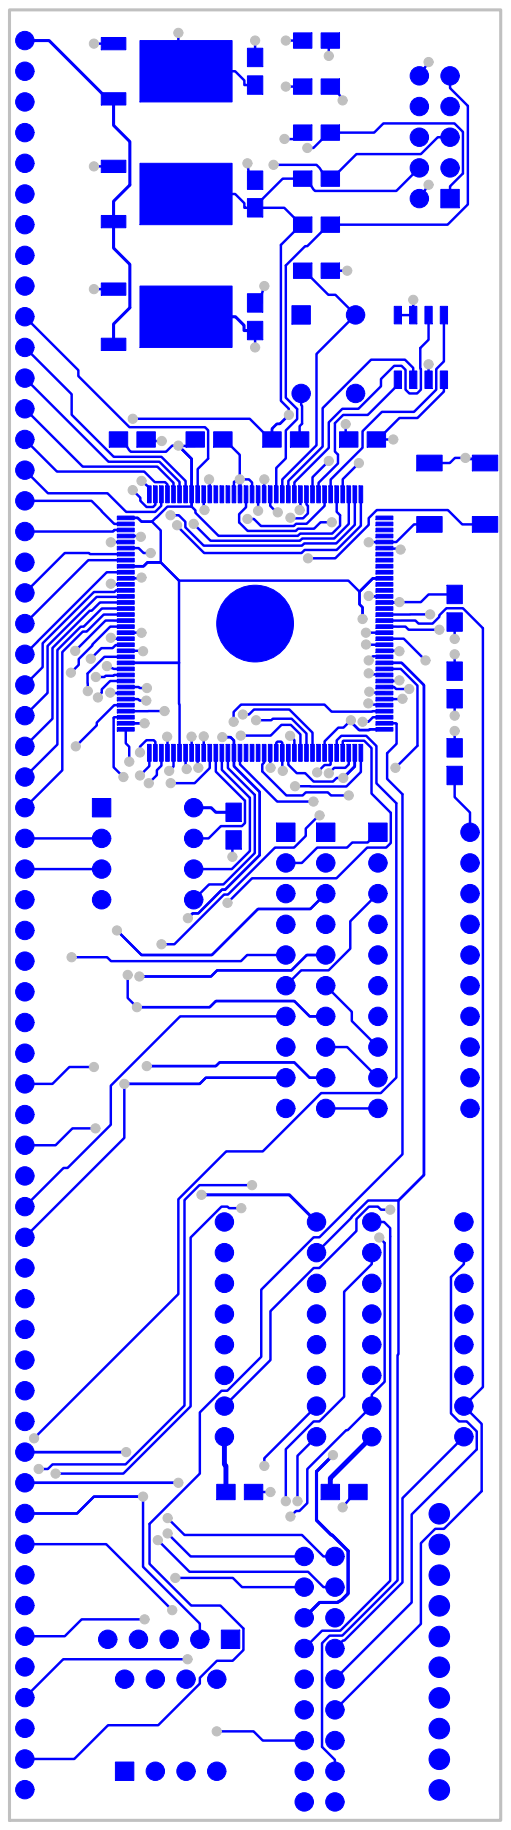
[picture p108: page 1]
C8C⁸x1 C⁸x2; U1U¹x1 U¹x3; U¹x2; U2U²x1 U²x3; U²x2; U3U³x1 U³x3; U³x2 H1H¹x1 H¹x2 H¹x3 H¹x4 H¹x5 H¹x6 H¹x7 H¹x8 H¹x9 H¹x10 H¹x11 H¹x12 H¹x13 H¹x14 H¹x15 H¹x16 H¹x17 H¹x18 H¹x19 H¹x20 H¹x21 H¹x22 H¹x23 H¹x24 H¹x25 H¹x26 H¹x27 H¹x28 H¹x29 H¹x30 H¹x31 H¹x32 H¹x33 H¹x34 H¹x35 H¹x36 H¹x37 H¹x38 H¹x39 H¹x40 H¹x41 H¹x42 H¹x43 H¹x44 H¹x45 H¹x46 H¹x47 H¹x48 H¹x49 H¹x50 H¹x51 H¹x52 H¹x53 H¹x54 H¹x55 H¹x56 H¹x57 H¹x58; C1C¹x1; C¹x2; U8U⁸x1 U⁸x2 U⁸x3 U⁸x4; U⁸x5 U⁸x6 U⁸x7 U⁸x8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

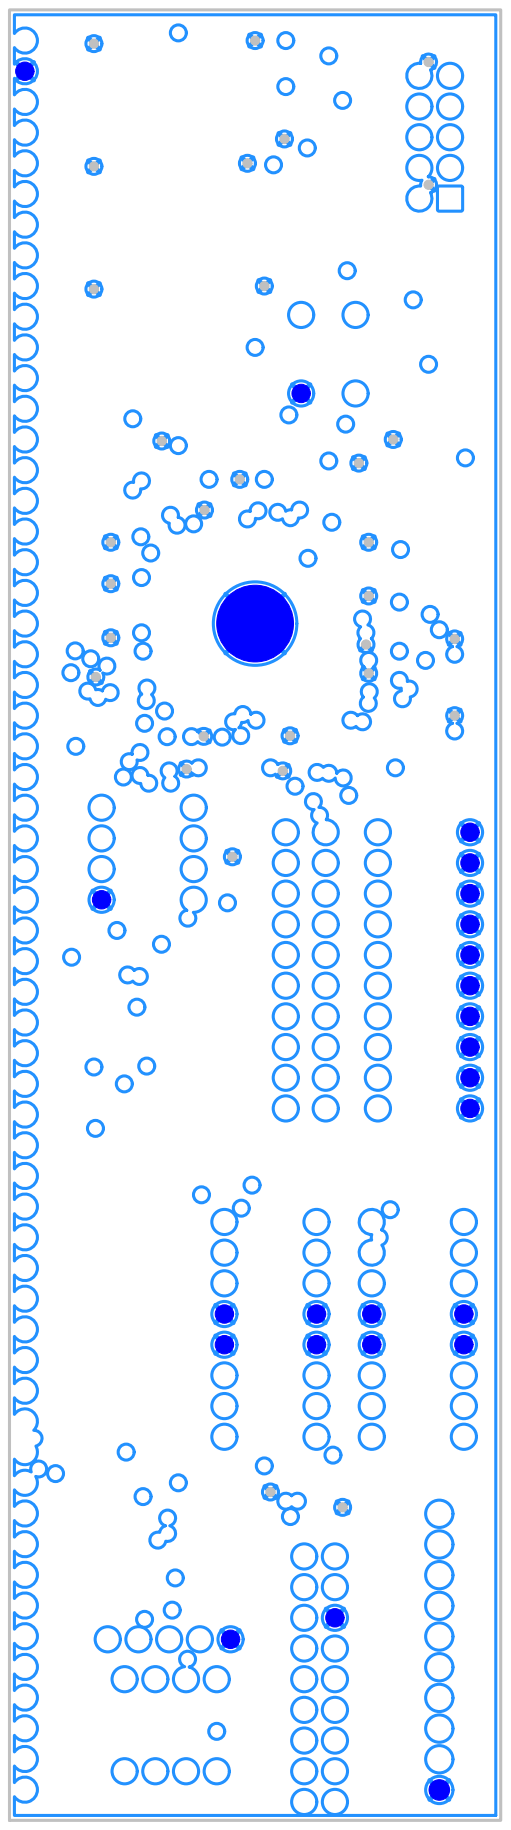
[picture p109: page 2]
H1H¹x1 H¹x2 H¹x3 H¹x4 H¹x5 H¹x6 H¹x7 H¹x8 H¹x9 H¹x10 H¹x11 H¹x12 H¹x13 H¹x14 H¹x15 H¹x16 H¹x17 H¹x18 H¹x19 H¹x20 H¹x21 H¹x22 H¹x23 H¹x24 H¹x25 H¹x26 H¹x27 H¹x28 H¹x29 H¹x30 H¹x31 H¹x32 H¹x33 H¹x34 H¹x35 H¹x36 H¹x37 H¹x38 H¹x39 H¹x40 H¹x41 H¹x42 H¹x43 H¹x44 H¹x45 H¹x46 H¹x47 H¹x48 H¹x49 H¹x50 H¹x51 H¹x52 H¹x53 H¹x54 H¹x55 H¹x56 H¹x57 H¹x58; U8U⁸x1 U⁸x2 U⁸x3 U⁸x4; U⁸x5 U⁸x6 U⁸x7 U⁸x8; U12 U¹²x1 U¹²x2 U¹²x3 U¹²x4 U¹²x8 U¹²x7 U¹²x6 U¹²x5; R9R⁹x5; R⁹x4; R⁹x3; R⁹x2; R⁹x1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

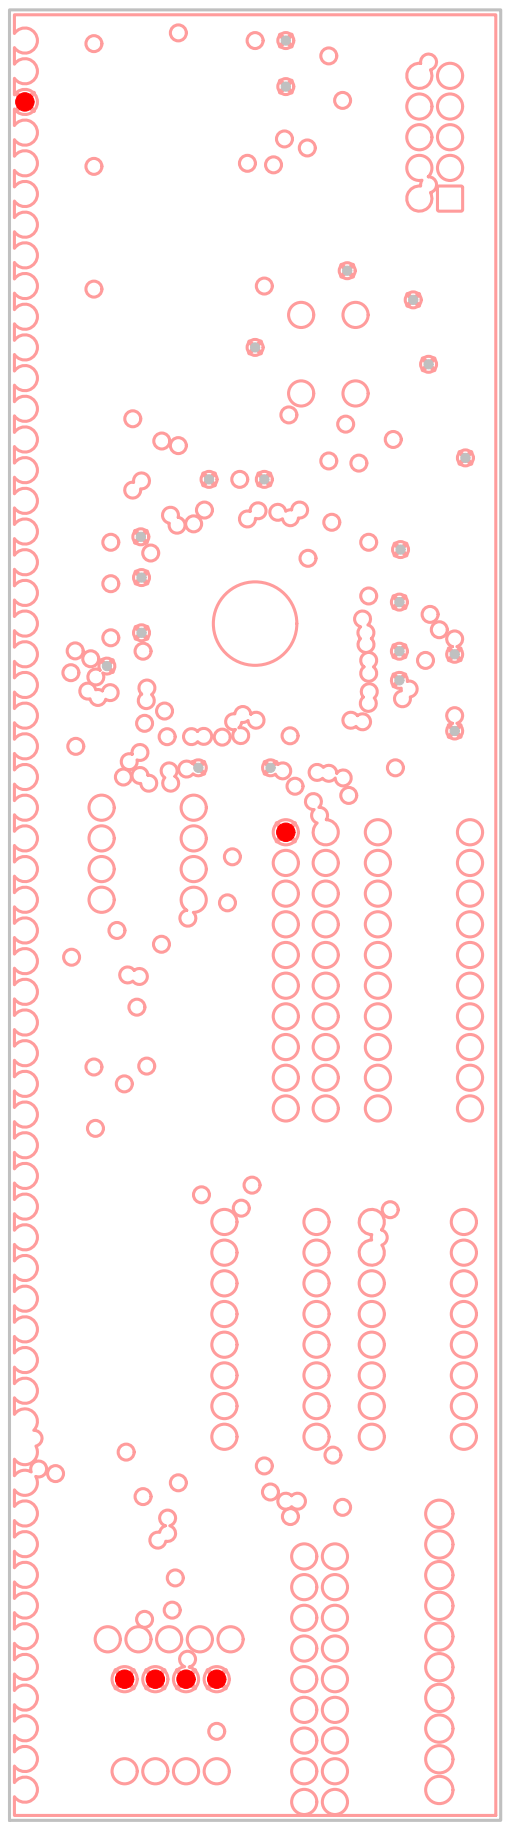
[picture p110: page 3]
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

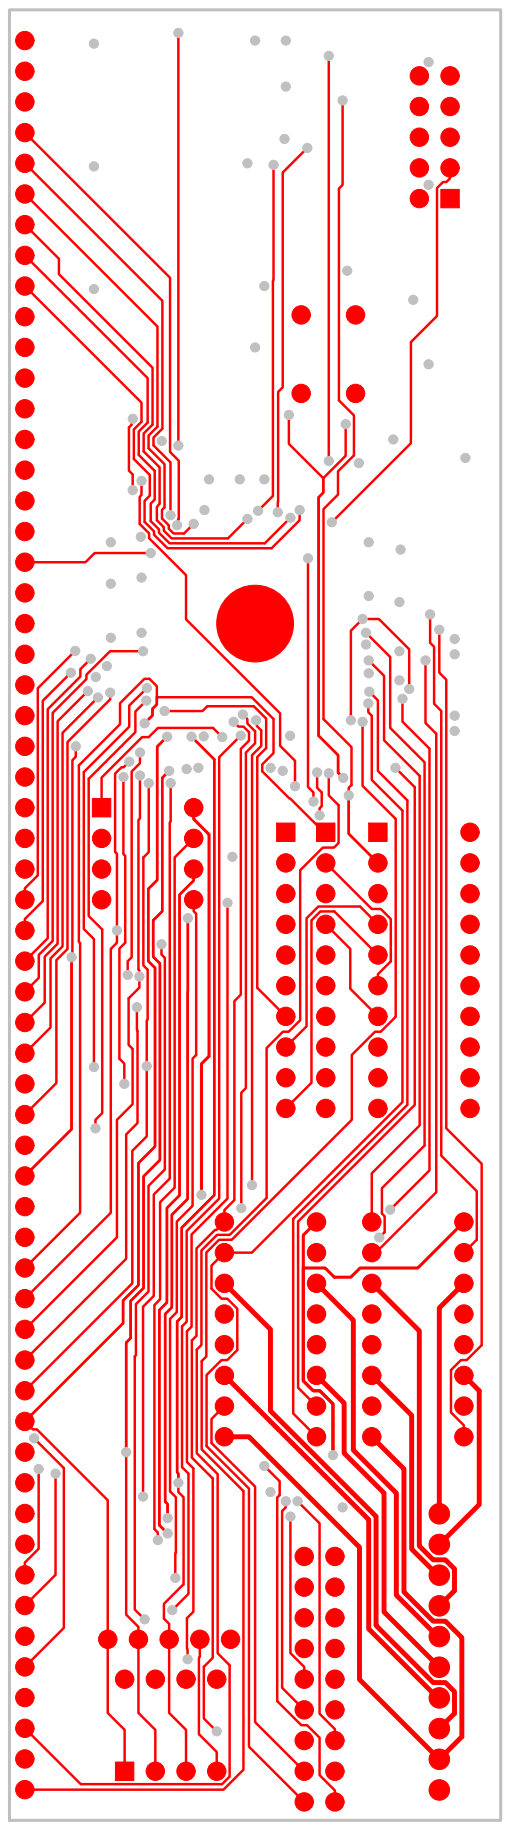
[picture p111: page 4]
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

U7

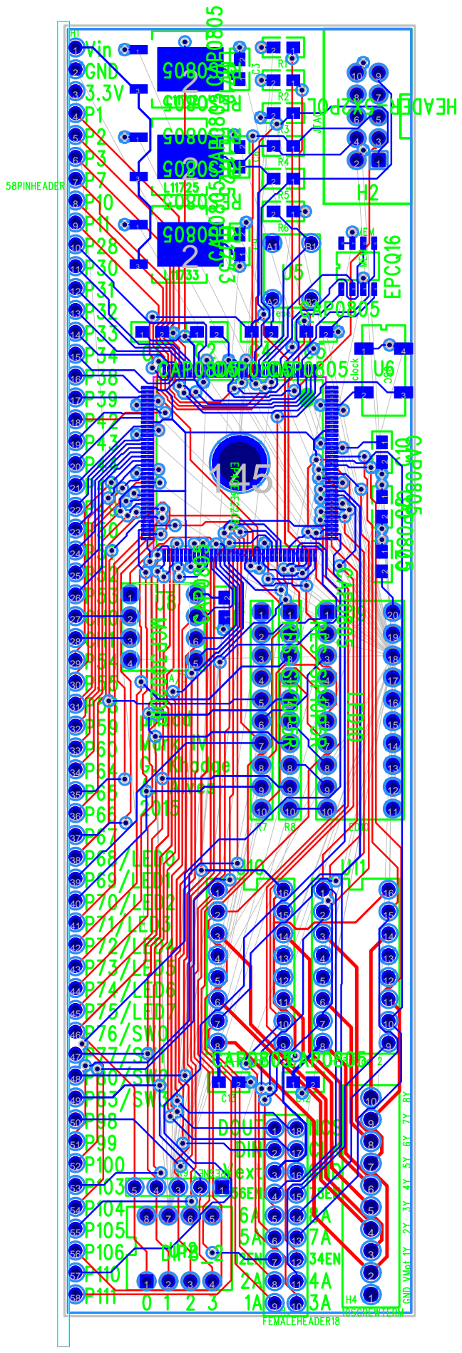
[picture p112: page 7]
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
