kpezeshki/MuddPiV5/Pre-Existing Work/DEPRECATED/OLD/microp-revised-board-20170927T040230Z-001/microp-revised-board/edgecardlayout11_1_2017.pdf

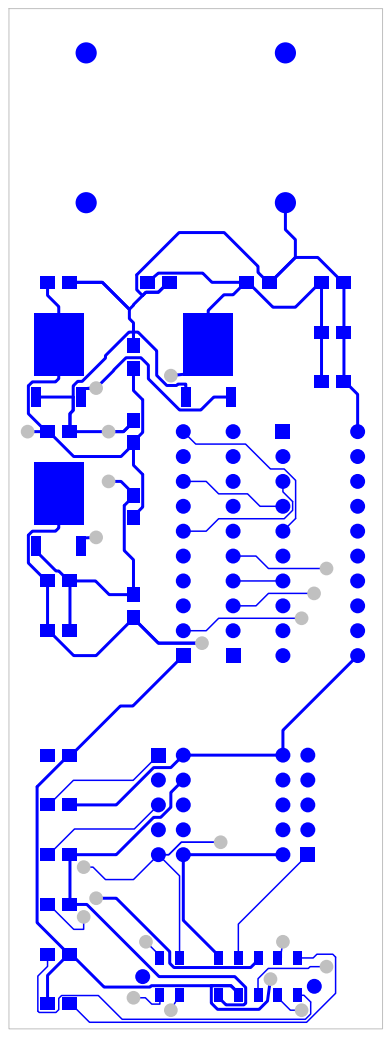
[picture p113: page 1]
C9C⁹x1; C⁹x2; C12C¹²x1; C¹²x2; C13C¹³x1; C¹³x2; U9U⁹x1 U⁹x2 U⁹x3 U⁹x4 U⁹x5 U⁹x6 U⁹x7 U⁹x8 U⁹x9 U⁹x10; U⁹x11 U⁹x12 U⁹x13 U⁹x14 U⁹x15 U⁹x16 U⁹x17 U⁹x18 U⁹x19 U⁹x20; JTAGSAM JTAGSAMx2 JTAGSAMx1 JTAGSAMx4 JTAGSAMx3 JTAGSAMx6 JTAGSAMx5 JTAGSAMx8 JTAGSAMx7 JTAGSAMx10 JTAGSAMx9; BV2BV²x1 BV²x2; C8C⁸x1; C⁸x2; R8R⁸x1 R⁸x2 R⁸x3 R⁸x4 R⁸x5 R⁸x6 R⁸x7 R⁸x8 R⁸x9 R⁸x10; R7R⁷x1 R⁷x2 R⁷x3 R⁷x4 R⁷x5 R⁷x6 R⁷x7 R⁷x8 R⁷x9 R⁷x10; U3U³x1 U³x2 U³x3; C3C³x1; C³x2; U12 U¹²x1 U¹²x2; U¹²x3 U¹²x4; U¹²x5 U¹²x6; U¹²x7 U¹²x8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

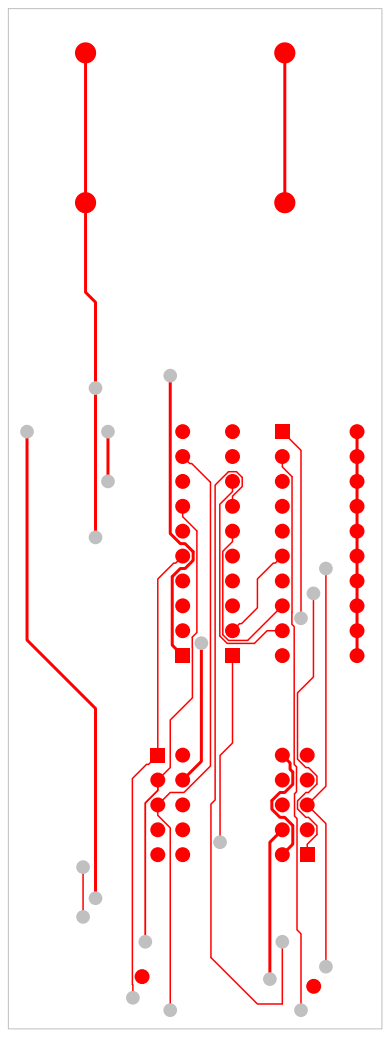
[picture p114: page 2]
U9U⁹x1 U⁹x2 U⁹x3 U⁹x4 U⁹x5 U⁹x6 U⁹x7 U⁹x8 U⁹x9 U⁹x10; U⁹x11 U⁹x12 U⁹x13 U⁹x14 U⁹x15 U⁹x16 U⁹x17 U⁹x18 U⁹x19 U⁹x20; JTAGSAM JTAGSAMx2 JTAGSAMx1 JTAGSAMx4 JTAGSAMx3 JTAGSAMx6 JTAGSAMx5 JTAGSAMx8 JTAGSAMx7 JTAGSAMx10 JTAGSAMx9; BV2BV²x1 BV²x2; R8R⁸x1 R⁸x2 R⁸x3 R⁸x4 R⁸x5 R⁸x6 R⁸x7 R⁸x8 R⁸x9 R⁸x10; R7R⁷x1 R⁷x2 R⁷x3 R⁷x4 R⁷x5 R⁷x6 R⁷x7 R⁷x8 R⁷x9 R⁷x10; U12 U¹²x_1; U¹²x_2; JTAGFPGA JTAGFPGAx1 JTAGFPGAx2 JTAGFPGAx3 JTAGFPGAx4 JTAGFPGAx5 JTAGFPGAx6 JTAGFPGAx7 JTAGFPGAx8 JTAGFPGAx9 JTAGFPGAx10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

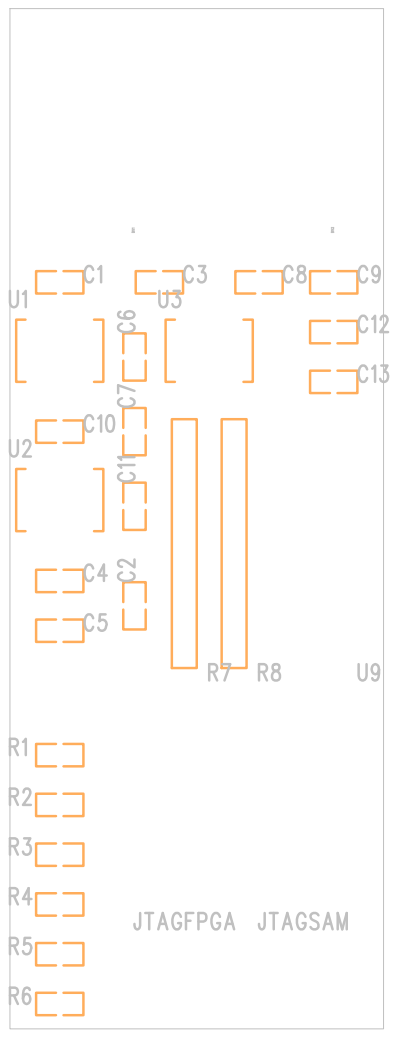
[picture p115: page 3]

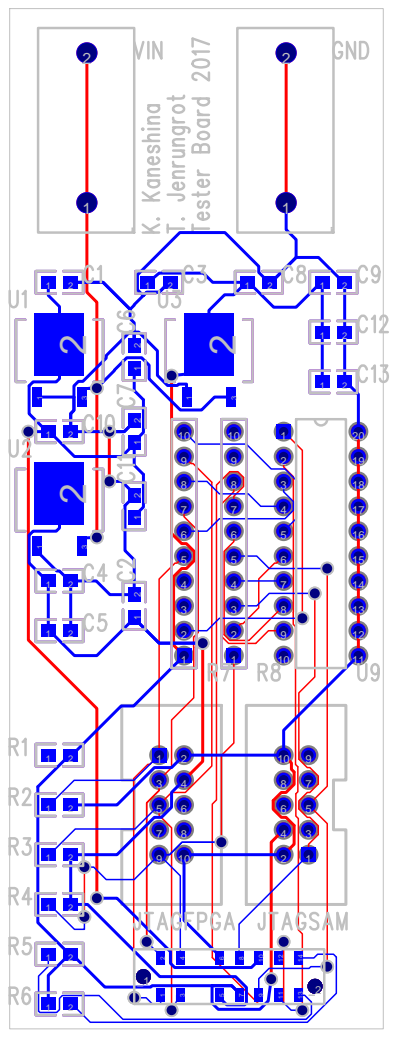
[picture p116: page 5]
