kpezeshki/MuddPiV5/Pre-Existing Work/DEPRECATED/OLD/microp-revised-board-20170927T040230Z-001/microp-revised-board/microp-revised-board[November-1-2017].pdf

U6

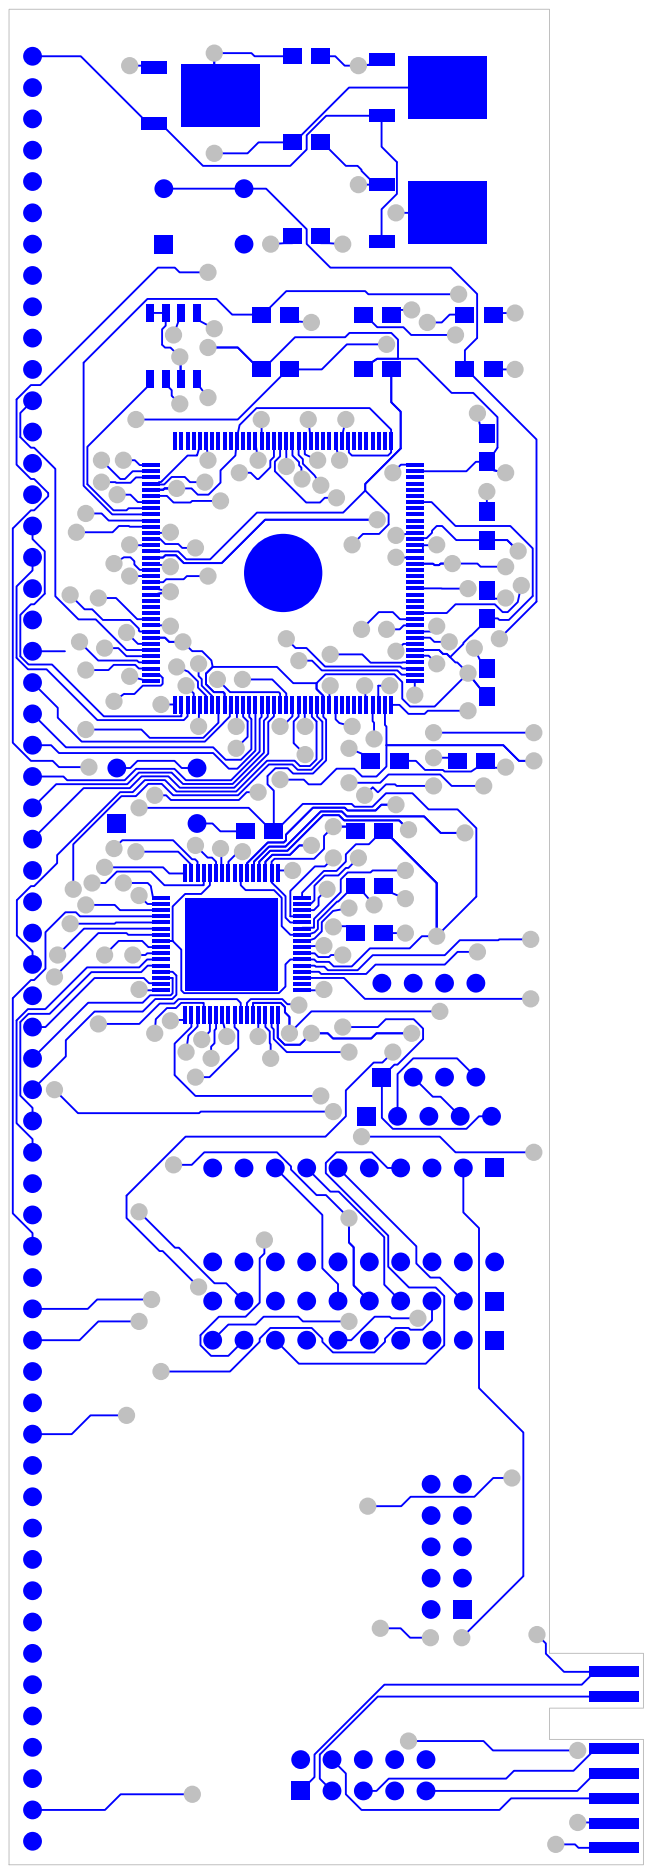
[picture p117: page 1]
U12U¹²x1 U¹²x2 U¹²x3 U¹²x4 U¹²x5 U¹²x6 U¹²x7; C4C⁴x1 C⁴x2; C5C⁵x1 C⁵x2; C6C⁶x1 C⁶x2; C7C⁷x1 C⁷x2; R3R³x1; R³x2; R6R⁶x2; R⁶x1; C8C⁸x1; C⁸x2; U2U²x1 U²x3; U²x2; U3U³x1 U³x3; U³x2; JTAGSAM JTAGSAMx2 JTAGSAMx1 JTAGSAMx4 JTAGSAMx3 JTAGSAMx6 JTAGSAMx5 JTAGSAMx8 JTAGSAMx7 JTAGSAMx10 JTAGSAMx9; C9C⁹x1; C⁹x2; U9U⁹x1 U⁹x2 U⁹x3 U⁹x4 U⁹x8 U⁹x7 U⁹x6 U⁹x5; R7R⁷x1; R⁷x2; R⁷x3; R⁷x4; R⁷x5; R2R²x1; R²x2; R5R⁵x2; R⁵x1; C11C¹¹x2; C¹¹x1; C12C¹²x1; C¹²x2; C13C¹³x1; C¹³x2; C1C¹x1; C¹x2; C2C²x1; C²x2; C3C³x1; C³x2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

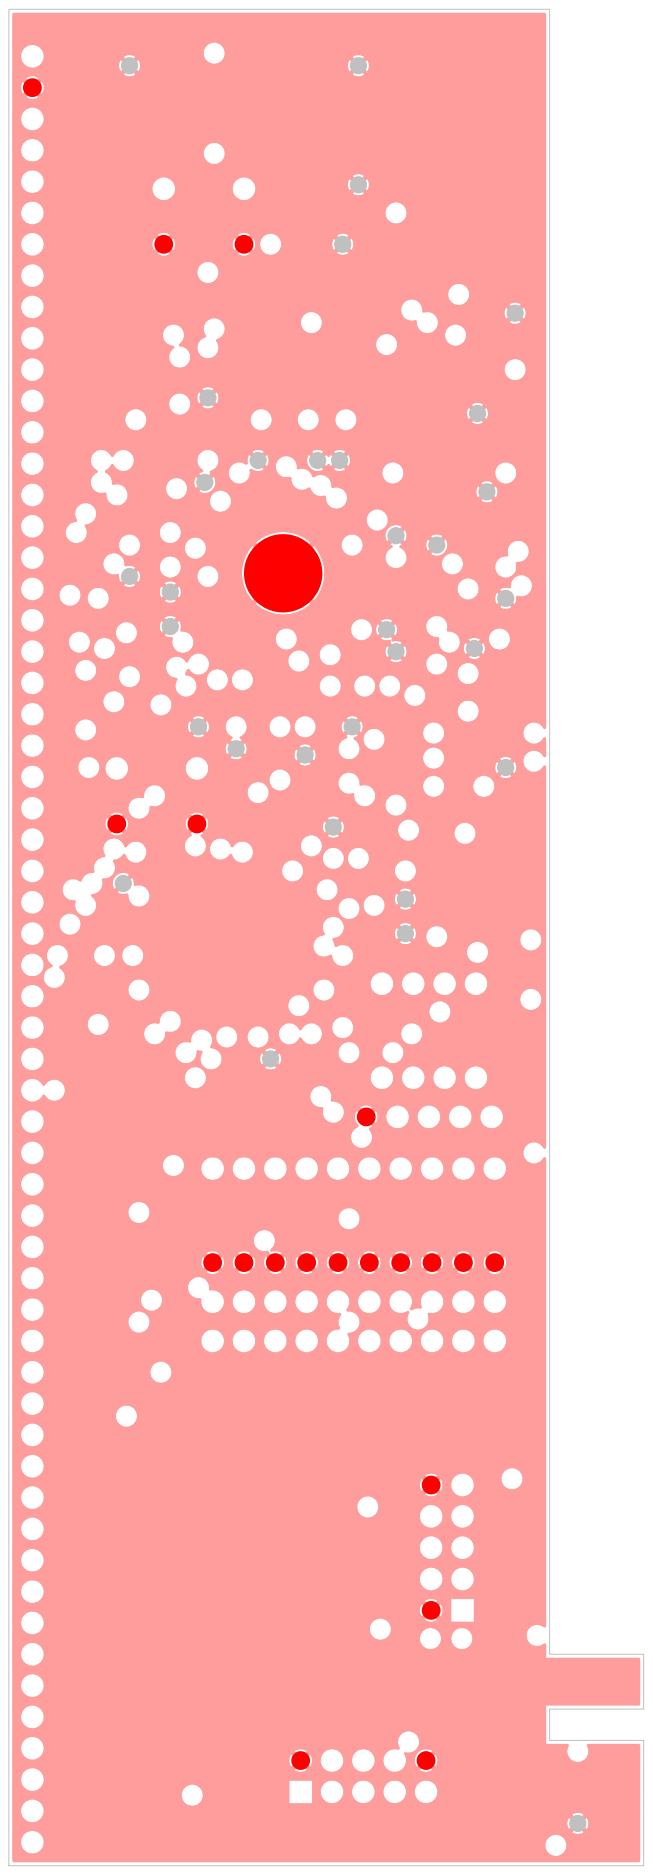
[picture p118: page 2]
JTAGSAM JTAGSAMx2 JTAGSAMx1 JTAGSAMx4 JTAGSAMx3 JTAGSAMx6 JTAGSAMx5 JTAGSAMx8 JTAGSAMx7 JTAGSAMx10 JTAGSAMx9; U9U⁹x1 U⁹x2 U⁹x3 U⁹x4 U⁹x8 U⁹x7 U⁹x6 U⁹x5; R7R⁷x1; R⁷x2; R⁷x3; R⁷x4; R⁷x5; JTAGFPGA JTAGFPGAx1 JTAGFPGAx2 JTAGFPGAx3 JTAGFPGAx4 JTAGFPGAx5 JTAGFPGAx6 JTAGFPGAx7 JTAGFPGAx8 JTAGFPGAx9 JTAGFPGAx10; U10 U¹⁰x10 U¹⁰x9 U¹⁰x8 U¹⁰x7 U¹⁰x6 U¹⁰x5 U¹⁰x4 U¹⁰x3 U¹⁰x2 U¹⁰x1; R8 U¹⁰x11 U¹⁰x12 U¹⁰x13 U¹⁰x14 U¹⁰x15 U¹⁰x16 U¹⁰x17 U¹⁰x18 U¹⁰x19 U¹⁰x20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

JTAGSAM JTAGSAMx2 JTAGSAMx1 JTAGSAMx4 JTAGSAMx3 JTAGSAMx6 JTAGSAMx5 JTAGSAMx8 JTAGSAMx7 JTAGSAMx10 JTAGSAMx9

U9U⁹x1 U⁹x2 U⁹x3 U⁹x4 U⁹x8 U⁹x7 U⁹x6 U⁹x5

R7R⁷x1 | R⁷x2 | R⁷x3 | R⁷x4 | R⁷x5

JTAGFPGA JTAGFPGAx1 JTAGFPGAx2 JTAGFPGAx3 JTAGFPGAx4 JTAGFPGAx5 JTAGFPGAx6 JTAGFPGAx7 JTAGFPGAx8 JTAGFPGAx9 JTAGFPGAx10

U10 U¹⁰x10 U¹⁰x9 U¹⁰x8 U¹⁰x7 U¹⁰x6 U¹⁰x5 U¹⁰x4 U¹⁰x3 U¹⁰x2 U¹⁰x1

R8 U¹⁰x11 U¹⁰x12 U¹⁰x13 U¹⁰x14 U¹⁰x15 U¹⁰x16 U¹⁰x17 U¹⁰x18 U¹⁰x19 U¹⁰x20

R9 R⁸x10 R⁸x9 R⁸x8 R⁸x7 R⁸x6 R⁸x5 R⁸x4 R⁸x3 R⁸x2 R⁸x1 R⁹x10 R⁹x9 R⁹x8 R⁹x7 R⁹x6 R⁹x5 R⁹x4 R⁹x3 R⁹x2 R⁹x1

U6U⁶x145

U4U⁴xA¹ | U⁴xA² U⁴xB¹ | U⁴xB²
U7U⁷xA¹ | U⁷xA² U⁷xB¹ | U⁷xB² U11U¹¹x1 U¹¹x2 U¹¹x3 U¹¹x4 U¹¹x5 U¹¹x6 U¹¹x7 U¹¹x8 U¹¹x9 U¹¹x10 U¹¹x11 U¹¹x12 U¹¹x13 U¹¹x14 U¹¹x15 U¹¹x16 U¹¹x17 U¹¹x18 U¹¹x19 U¹¹x20 U¹¹x21 U¹¹x22 U¹¹x23 U¹¹x24 U¹¹x25 U¹¹x26 U¹¹x27 U¹¹x28 U¹¹x29 U¹¹x30 U¹¹x31 U¹¹x32 U¹¹x33 U¹¹x34 U¹¹x35 U¹¹x36 U¹¹x37 U¹¹x38 U¹¹x39 U¹¹x40 U¹¹x41 U¹¹x42 U¹¹x43 U¹¹x44 U¹¹x45 U¹¹x46 U¹¹x47 U¹¹x48 U¹¹x49 U¹¹x50 U¹¹x51 U¹¹x52 U¹¹x53 U¹¹x54 U¹¹x55 U¹¹x56 U¹¹x57 U¹¹x58

U12U¹²x8 U¹²x9 U¹²x10 U¹²x11 U¹²x12 U¹²x13 U¹²x14 JTAGSAM JTAGSAMx2 JTAGSAMx1 JTAGSAMx4 JTAGSAMx3 JTAGSAMx6 JTAGSAMx5 JTAGSAMx8 JTAGSAMx7 JTAGSAMx10 JTAGSAMx9

U9U⁹x1 U⁹x2 U⁹x3 U⁹x4 U⁹x8 U⁹x7 U⁹x6 U⁹x5

R7R⁷x1 | R⁷x2 | R⁷x3 | R⁷x4 | R⁷x5

JTAGFPGA JTAGFPGAx1 JTAGFPGAx2 JTAGFPGAx3 JTAGFPGAx4 JTAGFPGAx5 JTAGFPGAx6 JTAGFPGAx7 JTAGFPGAx8 JTAGFPGAx9 JTAGFPGAx10

U10 U¹⁰x10 U¹⁰x9 U¹⁰x8 U¹⁰x7 U¹⁰x6 U¹⁰x5 U¹⁰x4 U¹⁰x3 U¹⁰x2 U¹⁰x1

R8 U¹⁰x11 U¹⁰x12 U¹⁰x13 U¹⁰x14 U¹⁰x15 U¹⁰x16 U¹⁰x17 U¹⁰x18 U¹⁰x19 U¹⁰x20

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

U6U⁶x145

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

U6

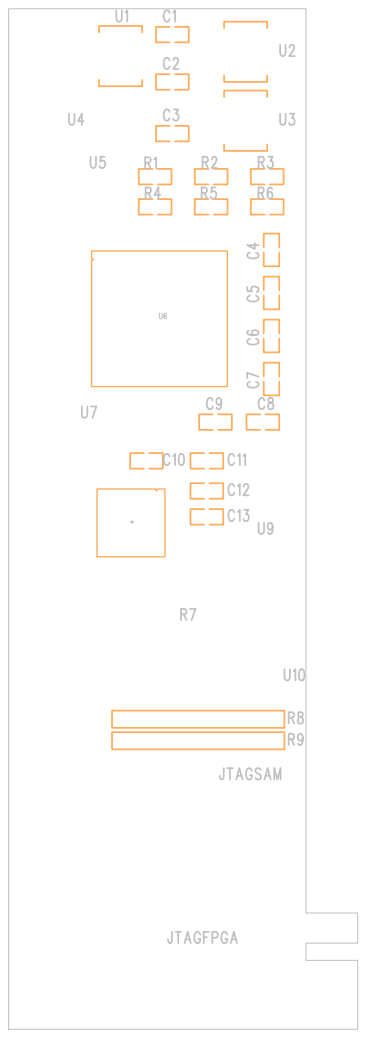
[picture p119: page 5]

U8U⁸x16 | U⁸x15 | U⁸x14 | U⁸x13 | U⁸x12 | U⁸x11 | U⁸x10 | U⁸x9 | U⁸x8 | U⁸x7 | U⁸x6 | U⁸x5 | U⁸x4 | U⁸x3 | U⁸x2 | U⁸x1 U⁸x17 U⁸x18 U⁸x19 U⁸x20 U⁸x21 U⁸x22 U⁸x23 U⁸x24 U⁸x25 U⁸x26 U⁸x27 U⁸x28 U⁸x29 U⁸x30 U⁸x31 U⁸x32 | U⁸x33 | U⁸x34 | U⁸x35 | U⁸x36 | U⁸x37 | U⁸x38 | U⁸x39 | U⁸x40 | U⁸x41 | U⁸x42 | U⁸x43 | U⁸x44 | U⁸x45 | U⁸x46 | U⁸x47 | U⁸x48 | U⁸x49 U⁸x50 U⁸x51 U⁸x52 U⁸x53 U⁸x54 U⁸x55 U⁸x56 U⁸x57 U⁸x58 U⁸x59 U⁸x60 U⁸x61 U⁸x62 U⁸x63 U⁸x64 U6 U⁶x1 U⁶x2 U⁶x3 U⁶x4 U⁶x5 U⁶x6 U⁶x7 U⁶x8 U⁶x9 U⁶x10 U⁶x11 U⁶x12 U⁶x13 U⁶x14 U⁶x15 U⁶x16 U⁶x17 U⁶x18 U⁶x19 U⁶x20 U⁶x21 U⁶x22 U⁶x23 U⁶x24 U⁶x25 U⁶x26 U⁶x27 U⁶x28 U⁶x29 U⁶x30 U⁶x31 U⁶x32 U⁶x33 U⁶x34 U⁶x35 U⁶x36 | U⁶x37 | U⁶x38 | U⁶x39 | U⁶x40 | U⁶x41 | U⁶x42 | U⁶x43 | U⁶x44 | U⁶x45 | U⁶x46 | U⁶x47 | U⁶x48 | U⁶x49 | U⁶x50 | U⁶x51 | U⁶x52 | U⁶x53 | U⁶x54 | U⁶x55 | U⁶x56 | U⁶x57 | U⁶x58 | U⁶x59 | U⁶x60 | U⁶x61 | U⁶x62 | U⁶x63 | U⁶x64 | U⁶x65 | U⁶x66 | U⁶x67 | U⁶x68 | U⁶x69 | U⁶x70 | U⁶x71 | U⁶x72 | U⁶x73 U⁶x74 U⁶x75 U⁶x76 U⁶x77 U⁶x78 U⁶x79 U⁶x80 U⁶x81 U⁶x82 U⁶x83 U⁶x84 U⁶x85 U⁶x86 U⁶x87 U⁶x88 U⁶x89 U⁶x90 U⁶x91 U⁶x92 U⁶x93 U⁶x94 U⁶x95 U⁶x96 U⁶x97 U⁶x98 U⁶x99 U⁶x100 U⁶x101 U⁶x102 U⁶x103 U⁶x104 U⁶x105 U⁶x106 U⁶x107 U⁶x108 U⁶x144 | U⁶x143 | U⁶x142 | U⁶x141 | U⁶x140 | U⁶x139 | U⁶x138 | U⁶x137 | U⁶x136 | U⁶x135 | U⁶x134 | U⁶x133 | U⁶x132 | U⁶x131 | U⁶x130 | U⁶x129 | U⁶x128 | U⁶x127 | U⁶x126 | U⁶x125 | U⁶x124 | U⁶x123 | U⁶x122 | U⁶x121 | U⁶x120 | U⁶x119 | U⁶x118 | U⁶x117 | U⁶x116 | U⁶x115 | U⁶x114 | U⁶x113 | U⁶x112 | U⁶x111 | U⁶x110 | U⁶x109
U8U⁸x16 | U⁸x15 | U⁸x14 | U⁸x13 | U⁸x12 | U⁸x11 | U⁸x10 | U⁸x9 | U⁸x8 | U⁸x7 | U⁸x6 | U⁸x5 | U⁸x4 | U⁸x3 | U⁸x2 | U⁸x1 U⁸x17 U⁸x18 U⁸x19 U⁸x20 U⁸x21 U⁸x22 U⁸x23 U⁸x24 U⁸x25 U⁸x26 U⁸x27 U⁸x28 U⁸x29 U⁸x30 U⁸x31 U⁸x32 | U⁸x33 | U⁸x34 | U⁸x35 | U⁸x36 | U⁸x37 | U⁸x38 | U⁸x39 | U⁸x40 | U⁸x41 | U⁸x42 | U⁸x43 | U⁸x44 | U⁸x45 | U⁸x46 | U⁸x47 | U⁸x48 | U⁸x49 U⁸x50 U⁸x51 U⁸x52 U⁸x53 U⁸x54 U⁸x55 U⁸x56 U⁸x57 U⁸x58 U⁸x59 U⁸x60 U⁸x61 U⁸x62 U⁸x63 U⁸x64 U6 U⁶x1 U⁶x2 U⁶x3 U⁶x4 U⁶x5 U⁶x6 U⁶x7 U⁶x8 U⁶x9 U⁶x10 U⁶x11 U⁶x12 U⁶x13 U⁶x14 U⁶x15 U⁶x16 U⁶x17 U⁶x18 U⁶x19 U⁶x20 U⁶x21 U⁶x22 U⁶x23 U⁶x24 U⁶x25 U⁶x26 U⁶x27 U⁶x28 U⁶x29 U⁶x30 U⁶x31 U⁶x32 U⁶x33 U⁶x34 U⁶x35 U⁶x36 | U⁶x37 | U⁶x38 | U⁶x39 | U⁶x40 | U⁶x41 | U⁶x42 | U⁶x43 | U⁶x44 | U⁶x45 | U⁶x46 | U⁶x47 | U⁶x48 | U⁶x49 | U⁶x50 | U⁶x51 | U⁶x52 | U⁶x53 | U⁶x54 | U⁶x55 | U⁶x56 | U⁶x57 | U⁶x58 | U⁶x59 | U⁶x60 | U⁶x61 | U⁶x62 | U⁶x63 | U⁶x64 | U⁶x65 | U⁶x66 | U⁶x67 | U⁶x68 | U⁶x69 | U⁶x70 | U⁶x71 | U⁶x72 | U⁶x73 U⁶x74 U⁶x75 U⁶x76 U⁶x77 U⁶x78 U⁶x79 U⁶x80 U⁶x81 U⁶x82 U⁶x83 U⁶x84 U⁶x85 U⁶x86 U⁶x87 U⁶x88 U⁶x89 U⁶x90 U⁶x91 U⁶x92 U⁶x93 U⁶x94 U⁶x95 U⁶x96 U⁶x97 U⁶x98 U⁶x99 U⁶x100 U⁶x101 U⁶x102 U⁶x103 U⁶x104 U⁶x105 U⁶x106 U⁶x107 U⁶x108 U⁶x144 | U⁶x143 | U⁶x142 | U⁶x141 | U⁶x140 | U⁶x139 | U⁶x138 | U⁶x137 | U⁶x136 | U⁶x135 | U⁶x134 | U⁶x133 | U⁶x132 | U⁶x131 | U⁶x130 | U⁶x129 | U⁶x128 | U⁶x127 | U⁶x126 | U⁶x125 | U⁶x124 | U⁶x123 | U⁶x122 | U⁶x121 | U⁶x120 | U⁶x119 | U⁶x118 | U⁶x117 | U⁶x116 | U⁶x115 | U⁶x114 | U⁶x113 | U⁶x112 | U⁶x111 | U⁶x110 | U⁶x109 U⁶x145

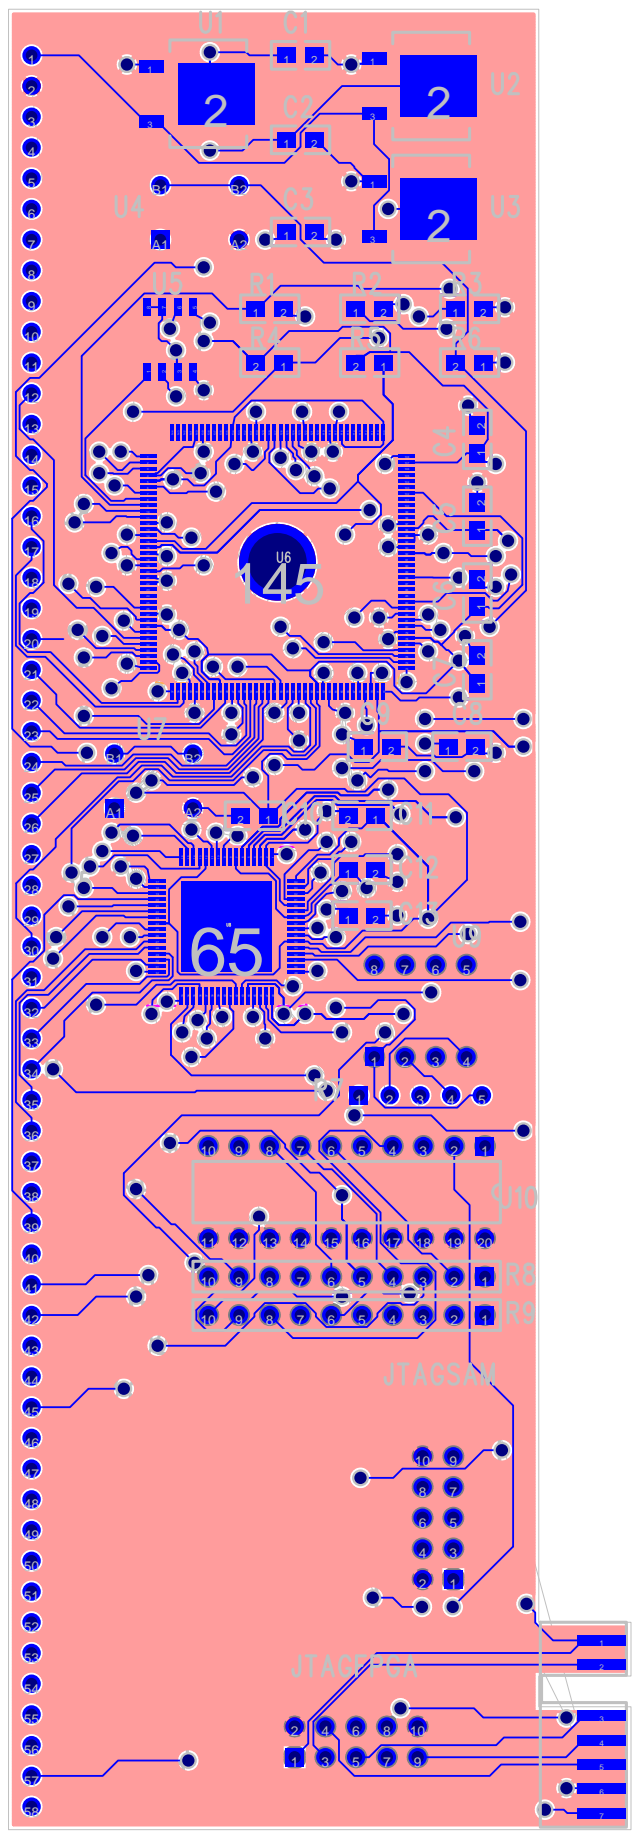
[picture p120: page 7]

PA22/AD9/MISO1
PA24/NSS1

55
56 | PB5/TWCK1
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
