kpezeshki/MuddPiV5/(list of files, drawings)

Other design files:
New PCB, no jumpers/uMuddMarkVLayout.pcb
New PCB, no jumpers/uMuddMarkVLayout_2.pcb
New PCB, no jumpers/uMuddMarkVLayout_2_blz.pcb
New PCB, no jumpers/uMuddMarkVLayout_3.pcb
New PCB, no jumpers/uMuddMarkVLayout_3_crystal.pcb
New PCB, no jumpers/uMuddMarkVLayout_3_crystal_routed.pcb
New PCB, no jumpers/uMuddMarkVLayout_3_oscillator.pcb
New PCB, no jumpers/uMuddMarkVLayout_3_oscillator_blz.pcb
New PCB, no jumpers/uMuddMarkVLayout_blz.pcb
New PCB, no jumpers/uMuddMarkVTesterLayout.pcb
New PCB, no jumpers/uMuddMarkVTesterLayout_blz.pcb
Pre-Existing Work/DEPRECATED/OLD/microp-revised-board-20170927T040230Z-001/microp-revised-board/edgecardlayout.pcb
Pre-Existing Work/DEPRECATED/OLD/microp-revised-board-20170927T040230Z-001/microp-revised-board/microp-revised-board.pcb
Pre-Existing Work/DEPRECATED/OLD/microp-revised-board-20170927T040230Z-001/try2.pcb
Pre-Existing Work/DEPRECATED/OLD/uMuddBoard-3-26-15/E155BoardLayout2.pcb
Pre-Existing Work/DEPRECATED/OLD/uMuddBoard-3-26-15/uMuddBoard-3-26-15/E155BoardLayout2.pcb
Pre-Existing Work/DEPRECATED/Tutorial/pcb.pcb
