kpezeshki/MuddPiV5/(commit log)

2018-10-27 added previous work and lab JTAG testing
    [Bill of Materials.xlsx, E155BoardLayout2.pcb, E155BoardRevD.sch, MicroP Research.xlsx, MuddPi_MarkIV-BOM.xls (1).xlsx, MuddPi_MarkIV-BOM.xls (2).xlsx, MuddPi_MarkIV-BOM.xls (3).xlsx, MuddPi_MarkIV-BOM.xls (4).xlsx]
2018-11-24 added working SPI examples
    [MicroP Research.xlsx]
2018-11-25 added SPI to library
2018-11-27 updated schematics, fixed ERASE pin
    [uMuddMarkVLayout.pcb, uMuddMarkVLogic.sch, uMuddMarkVTesterLayout.pcb, uMuddMarkVTesterLogic.sch]
2018-11-28 updated schematic, todo SAM_JTAG
    [uMuddMarkVLogic.sch]
2018-11-28 finished schematic
    [uMuddMarkVLogic.sch]
2018-11-28 added finished status report presentation
    [uMuddMarkVLogic.sch]
2018-12-01 Added TC channel support, reworked delays, completed final TC pass-through
    [easySamIO.h]
2018-12-01 completed schematic
    [uMuddMarkVLayout.pcb, uMuddMarkVLayout_blz.pcb, uMuddMarkVLogic.sch, uMuddMarkVTesterLayout.pcb, uMuddMarkVTesterLogic.sch]
2018-12-01 PCB design complete
    [uMuddMarkVLayout.pcb, uMuddMarkVLayout_blz.pcb, uMuddMarkVLogic.sch, uMuddMarkVTesterLayout.pcb, uMuddMarkVTesterLogic.sch]
2018-12-01 added PDFs of schematic and layout
2018-12-02 enabled SPI configuration
2018-12-03 updated schematics
    [uMuddMarkVLogic.sch]
2018-12-03 prototyped lab 6 ESP-side
2018-12-05 added new PCB version files
    [uMuddMarkVLayout.pcb, uMuddMarkVLayout_2.pcb, uMuddMarkVLogic.sch, uMuddMarkVTesterLogic.sch]
2018-12-05 added PCB image
2018-12-06 pcb passes drc
    [uMuddMarkVLayout_2.pcb, uMuddMarkVLogic.sch]
2018-12-06 updated BoM
    [uMuddMarkVTesterLayout.pcb, uMuddMarkVTesterLogic.sch]
2018-12-06 added PDFs
    [uMuddMarkVLogic.sch, uMuddMarkVTesterLayout_blz.pcb]
2018-12-07 generated Gerbers, updated BoM
    [Bill of Materials.xlsx, uMuddMarkVLayout_3.pcb, uMuddMarkVTesterLayout_blz.pcb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]
2018-12-08 passing advanced circuits dfm
    [uMuddMarkVLayout_3.pcb, uMuddMarkVTesterLayout_blz.pcb]
2018-12-08 Bit field pass on SPI and UART
2018-12-08 Bit field pass for all peripherals, implemented ADC
2018-12-10 Tested ADC
2018-12-11 added working website with interrupt-driven refreshes
2018-12-12 added lab 6 writeup, webpage working with ADC
2018-12-12 small PCB tweaks
    [uMuddMarkVLogic.sch, uMuddMarkVTesterLayout_blz.pcb]
2018-12-12 updated SPI
2018-12-14 grammar fixes and BoM added to final report
2019-01-30 added crystal, need to solve autorouter bugs
    [uMuddMarkVLayout_3_crystal.pcb, uMuddMarkVLogic_Crystal.sch]
2019-01-30 added oscillator to board, passing dfm
    [uMuddMarkVLayout_3_crystal_routed.pcb]
2019-01-31 added test program and Atmel Studio project for MCU test board
2019-01-31 added FPGA module for test board. Still needs to be synthesized, implemented, and tested
2019-02-13 added oscillator but footprint scaling is maybe a factor of 4 off
    [Available IO.xlsx, uMuddMarkVLayout_3_oscillator.pcb, uMuddMarkVLogic_Oscillator.sch]
2019-02-14 added oscillator to layout
    [uMuddMarkVLayout_3_oscillator.pcb, uMuddMarkVLogic_Oscillator.sch]
2019-02-16 added oscillator
    [Available IO.xlsx, uMuddMarkVLayout_3_oscillator.pcb, uMuddMarkVLogic_Oscillator.sch]
2019-02-16 added other shit
    [uMuddMarkVLogic_Oscillator.sch]
2019-02-25 generated gerbers
    [uMuddMarkVLayout_3_oscillator.pcb, uMuddMarkVLayout_3_oscillator_blz.pcb, uMuddMarkVLogic_Oscillator.sch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]
2019-03-01 updated BoM with crystal
    [Bill of Materials.xlsx]
2019-03-30 generated pdfs, added part orientation doc
    [uMuddMarkVLayout_3_oscillator_blz.pcb, uMuddMarkVLogic_Oscillator.sch]
2019-03-31 added test board PDFs
    [uMuddMarkVTesterLayout_blz.pcb]
2019-04-13 fixed PCB via connectivity issue
    [uMuddMarkVLayout_3_oscillator_blz.pcb, uMuddMarkVLogic_Oscillator.sch]
2019-04-13 updated DIP switch silkscreen
    [uMuddMarkVLayout_3_oscillator_blz.pcb]
2019-05-03 reviewed board and generated new Gerbers
    [uMuddMarkVLayout_3_oscillator_blz.pcb, uMuddMarkVTesterLayout_blz.pcb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]
2019-05-18 added regenerated uMudd files
    [ncdrill.drl]
